barcklay/Cube_SAT/portfolio/sky/index.html

HAB-1 · GPS u-blox MAX-M10S · запись 29.09.2026, 21:44 · Бангкок, у окна

# Небо, которое видит GPS

Три минуты настоящих данных с модуля GPS моего зонда. Каждая точка — спутник: где он на небе, какой системы и насколько сильный сигнал до него доходит. Координаты не публикуются.

## Где эти спутники на самом деле

Земля, орбиты и расстояния в одном масштабе. Каждый спутник стоит там, где его в тот момент видел модуль GPS в Бангкоке, а линия — путь его сигнала до зонда. Все линии уходят на юг и запад: туда смотрит окно, остальное небо закрывает дом. Ещё 21 спутник BeiDou слышен, но где он, приёмник пока не знает, поэтому на глобусе его нет. Солнце стоит там, где было в момент записи: Бангкок уже на ночной стороне, а спутники высоко и ещё освещены. Высота и наклон каждой орбиты настоящие, поворот орбиты нарисован условно (по одному наблюдению не видно, куда летит спутник), а сами спутники увеличены в сотни тысяч раз — иначе их не разглядеть. Нажми на спутник, чтобы подлететь к нему.

тянуть — вращать · колесо / щипок — масштаб · нажми на спутник, чтобы подлететь

ВосходВсе спутники← Назад

## Что делают эти спутники

Навигационный спутник — это летающие часы. На каждом стоят атомные часы, и он без остановки передаёт: «сейчас ровно такое-то время, я нахожусь вот здесь». Приёмник на зонде замечает, насколько опоздал сигнал от каждого спутника, переводит опоздания в расстояния и по четырём и больше спутникам вычисляет, где он и который час.

Спутники SBAS (здесь — индийская система GAGAN) висят над одной точкой экватора и рассылают поправки к часам, орбитам и задержке сигнала в атмосфере. С ними ошибка координат падает до метра. Основная работа этих двух спутников — связь и телевидение, навигационная аппаратура на них — попутный груз.

Спецификации: NAVCEN (статус GPS), GSC Europa (Galileo), список кодов PRN gps.gov (январь 2026), AAI (GAGAN), Wikipedia и eoPortal. Внешний вид моделей — по фото и рендерам производителей, упрощённо.

## То же небо глазами приёмника

Как читать карту: центр — зенит, прямо над головой; край — горизонт. Север сверху, восток справа. Чем крупнее и ярче точка, тем сильнее сигнал.

## Почему пока нет координат

Все хорошо слышные спутники стоят в южной и западной половине неба, от 110° до 270°. Это и есть окно: северную половину закрывает дом, а спутник прямо над головой (GPS 30) почти не слышно из-за потолка. Приёмник слышит 32 спутника, но положение знает только у 11, и все они с одной стороны. По спутникам с одной стороны точку не вычислить.

Отсюда первое правило запуска: антенне GPS нужно всё небо. В полёте над зондом ничего нет, а вот на земле перед стартом его надо включать на открытом месте и ждать фикса, а не в машине или под навесом. Именно так карта неба помогает проверить аппарат до полёта.

## Сила сигнала каждого спутника

Среднее отношение сигнал/шум (C/N0) за три минуты, в дБ·Гц; штрих — лучшее значение. Ниже ~25 сигнал слабый, от 35 — сильный.

## Режим Airborne <4g: без него GPS слепнет на высоте

По умолчанию модуль считает, что его носят в руке или везут в машине, и выше 12 км перестаёт выдавать координаты. Зонд летит на 30 км. Поэтому прошивка при каждом включении переводит модуль в режим «летательный аппарат» (Airborne <4g, потолок 80 км), ждёт подтверждения и сохраняет режим в память модуля с батарейкой. Так выглядит это в настоящем логе при старте платы:

GPS: NMEA OK at 38400 baud
GPS dynModel at boot: RAM=8 (AIRBORNE<4g), BBR=8 (AIRBORNE<4g)
GPS set Airborne<4g: ACK
GPS dynModel now: RAM=8 (AIRBORNE<4g)

Закрыть Все типы рядом

↓ Земля · модель упрощена, по фото и спецификациям

HAB-1 · данные: сырые NMEA-строки GSV модуля MAX-M10S, 185 секунд · проект: github.com/barcklay/Cube_SAT · полёт в 3D: HAB-1 Лаборатория (https://claude.ai/artifact/VP8YPhxGNXckYP5Keu93rK)
