barcklay/Cube_SAT/portfolio/lab/index.html

# HAB-1

Самодельный зонд, который поднимется на метеошаре на 30 км в стратосферу, соберёт данные и вернётся на парашюте

надуваем шар…

# HAB-1

Зонд поднимется на метеошаре на 30 км, соберёт данные и вернётся на парашюте. Бортовой компьютер, плату и корпус делаю сама.

Зонд Весь подвес Сверху Заглянуть внутрь О модели

Датчики ▴

Датчики на борту

Среда и шар

Место

ПОДЪЁМ

0км

▶ Полёт

## HAB-1: полёт в стратосферу

Что это

Самодельный бортовой компьютер для метеошара: плату, прошивку и корпус делаю сама.

Зачем

Подняться на 30 км, измерить холод, давление и ветер на высоте и вернуть данные и снимки. Первый запуск — в Таиланде, 2027.

Что здесь

Симуляция полёта. Время двигается внизу, датчики справа. Нажми на коробку — она откроется, внутри настоящая плата из проекта; нажми ещё раз — закроется.

Заглянуть внутрь ▶ Запустить полёт Просто смотреть

Внутри — бортовой компьютер · нажми Закрыть

## Что здесь настоящее, а что модель

### Настоящее

- Плата внутри зонда выгружена из KiCad-проекта полётной платы (kicad-cli pcb export glb). Детали расставлены, дорожки ещё не разведены.
- Высота по давлению считается формулой из прошивки: 44330·(1 − (p/p₀)^(1/5,255)). Она верна только до 11 км, и страница показывает, насколько она ошибается выше.
- Строка внизу экрана в формате FramePrint: те же поля, флаги valid и код режима GPS, что в прошивке hab_bringup.
- Паспортные пределы: BMP390 работает от 300 до 1250 гПа, DS18B20 от −55 до +125 °C.
- GPS переведён в режим Airborne <4g: в режиме по умолчанию приёмник перестаёт выдавать координаты выше 12 км, и зонд было бы не найти. Прошивка ставит режим при каждом включении и проверяет подтверждение модуля.
- Корпус по концепции HW-34: пенопласт XPS 30 мм, 250 × 175 × 140 мм, салазки с платой 1U, батареи 4× L91, отсек камеры.

### Модель

- Атмосфера — упрощённый тропический профиль: +27 °C у земли, около −83 °C на 17 км. Он холоднее стандартной ISA, потому что запуск будет в Таиланде.
- Подъём 5 м/с. Шар 1,9 м у земли и лопается при 7,9 м, газ считается при температуре воздуха. Высота разрыва получается из этого расчёта.
- Спуск на парашюте: 5 м/с у земли, на высоте быстрее пропорционально √(ρ₀/ρ).
- Температура внутри бокса — грубая оценка. Её заменят данные теста с сухим льдом (HW-34).
- Сцена показана на рассвете: с высоты 30 км Солнце уже встало, а на земле ещё ночь. Огни городов — снимок NASA Black Marble, дневная земля — Blue Marble. Облака и показания IMU в момент разрыва условные. Размеры шара, строп и корпуса в масштабе.

### Точка старта

- Кандидаты считались по сетке 0,1° по всему Таиланду (около 11 км между точками). Условия: от аэропортов с кодом IATA/ICAO не ближе 50 км, от других аэродромов 20 км, от военных объектов 25 км, до сухопутной границы и моря не меньше 150 км. Перепад высот по SRTM в квадрате 8×8 км не больше 25 м.
- Выбрана точка 15,800° N 102,500° E (район Вэнг Ной, провинция Кхонкэн, плато Корат). До границы и моря 178 км, до аэропорта 80 км, до военного объекта в OSM 52 км, перепад высот 16 м, высота 186 м.
- Траектория на сцене — пример прогноза SondeHub/Tawhiri по погоде GFS на один день (дата в панели «Место»). В феврале–марте ветры другие. Настоящий прогноз нужно считать за несколько дней до пуска.
- Военные объекты в OSM отмечены не полностью. Перед пуском точку надо согласовать с авиавластями Таиланда (CAAT) и подать NOTAM.
- Снимок поверхности: NASA Blue Marble Next Generation (общественное достояние), через NASA GIBS.

### Дальше

- Карта неба GPS, повтор настоящего лога со стенда, радиолиния LoRa, питание на морозе.
- После запуска модель заменится настоящим полётом из лога.
