barcklay/Cube_SAT/hardware/flight_pcb/render_bottom_routed.png

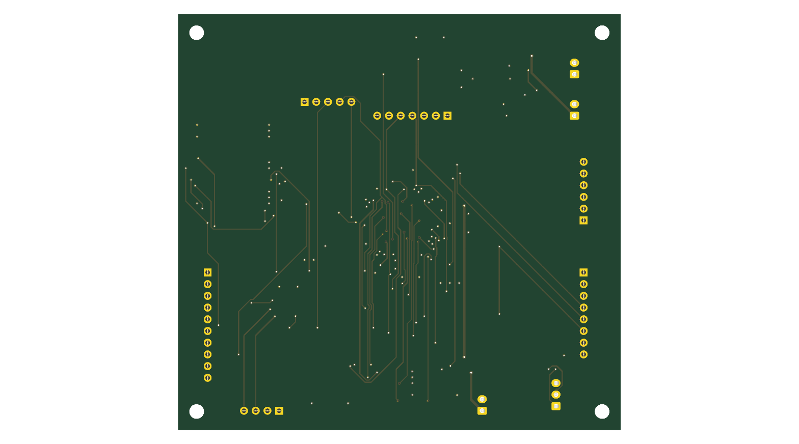
hardware/flight_pcb/render_bottom_routed.png
