barcklay/Cube_SAT/hardware/flight_pcb/render_top_unrouted.png

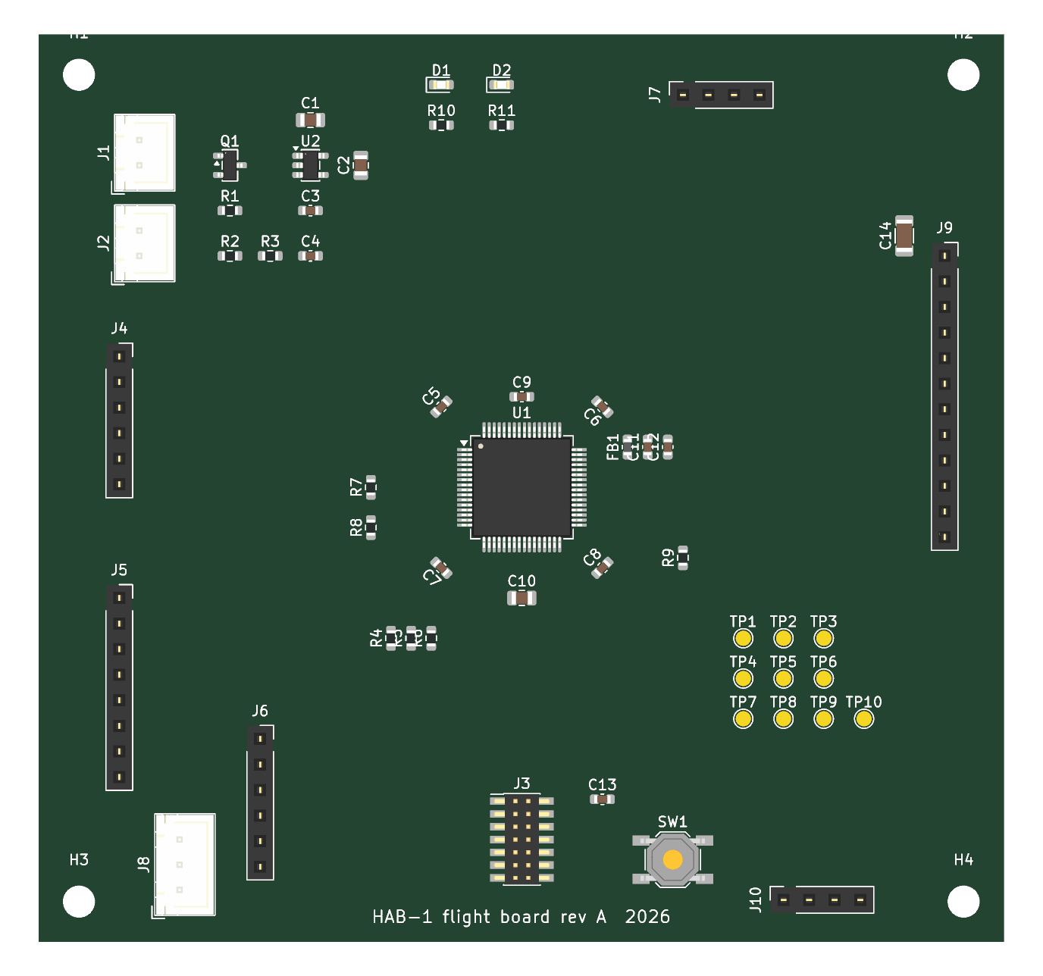
hardware/flight_pcb/render_top_unrouted.png
