barcklay/Cube_SAT/portfolio/lab/near.jpg

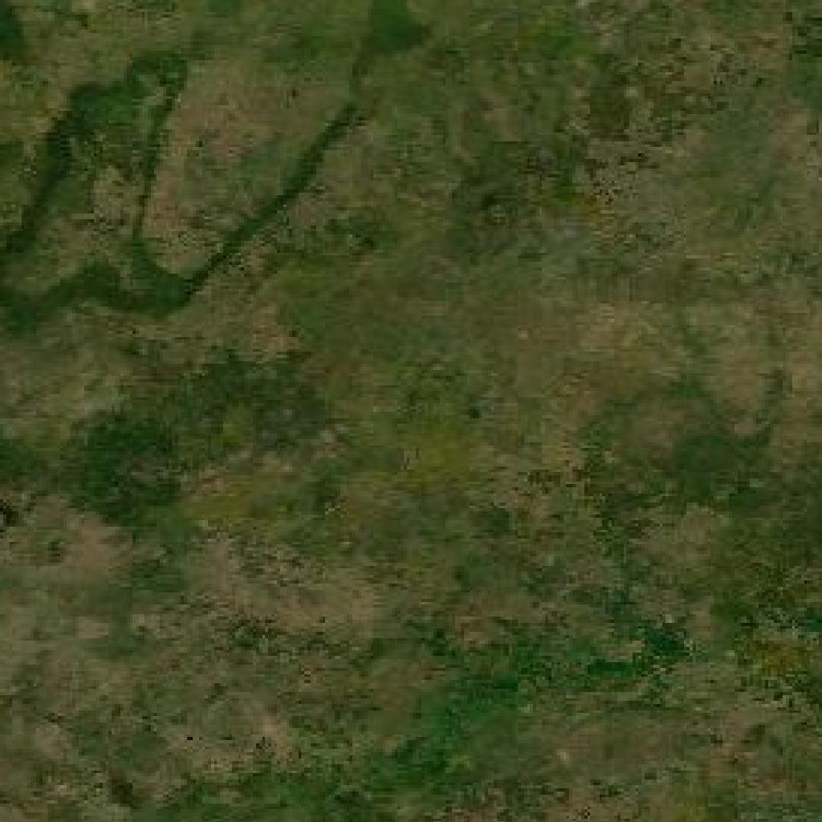
portfolio/lab/near.jpg
