barcklay/Cube_SAT/portfolio/lab/wide.jpg

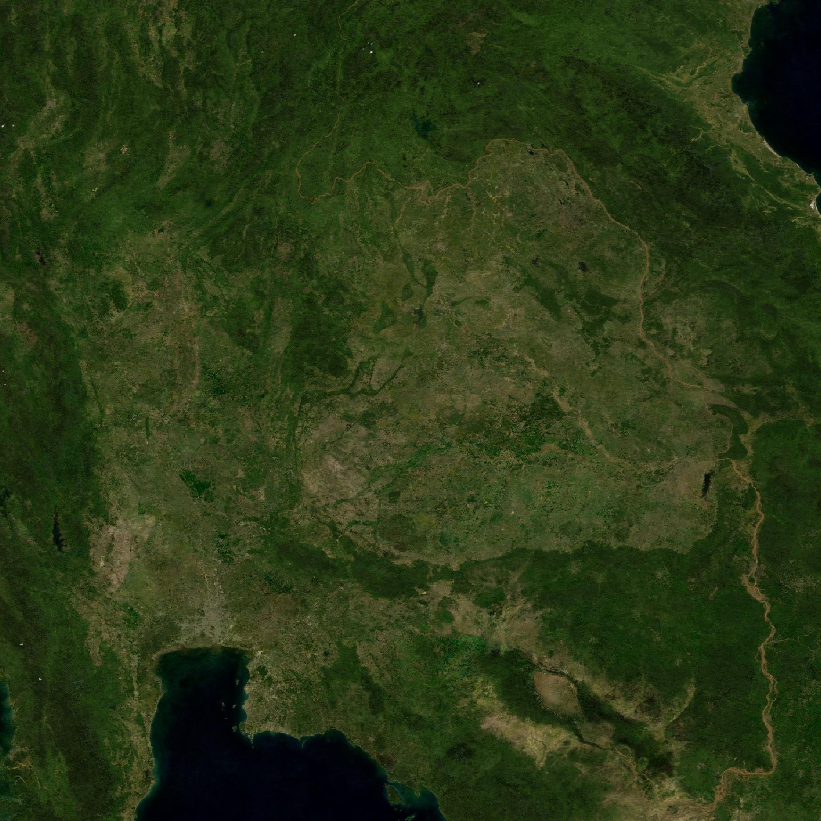
portfolio/lab/wide.jpg
