barcklay/Cube_SAT/portfolio/lab/wide_night.jpg

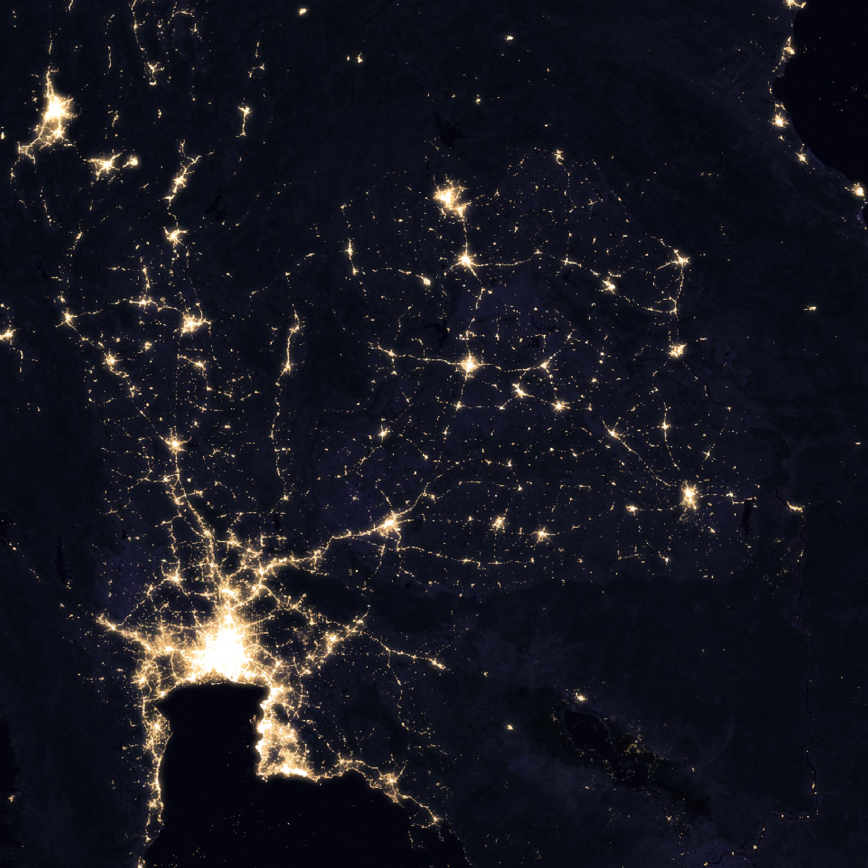
portfolio/lab/wide_night.jpg
