barcklay/Cube_SAT/portfolio/sky/world.jpg

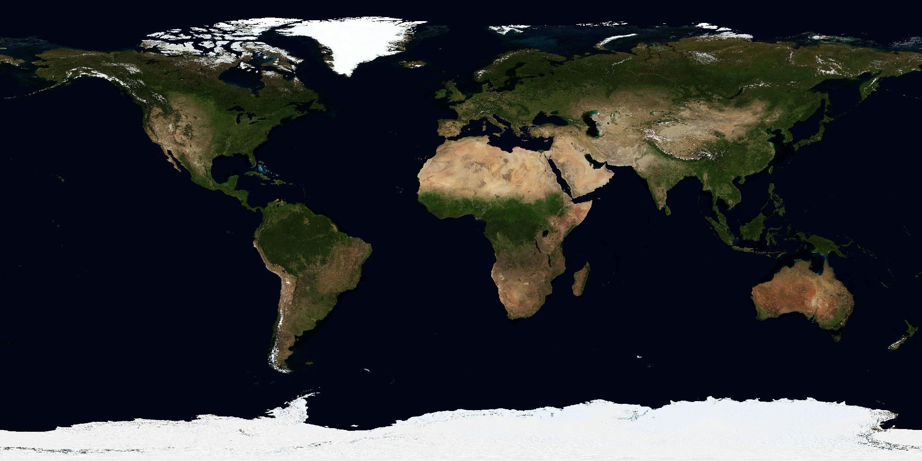
portfolio/sky/world.jpg
