barcklay/Cube_SAT/hardware/lora_adapter/fab/bom_jlcpcb.csv

Comment | Designator | Footprint | LCSC Part #
0805 4.7uF 25V X5R | C1 | C_0805_2012Metric | C1779
0603 100nF 50V X7R | C2 | C_0603_1608Metric | C14663
E22-400M22S LoRa module (Ebyte, SX1268) | U1 | E22-400M22S | C411291
