barcklay/Cube_SAT/hardware/flight_pcb/fab/hand_soldered.txt

Through-hole parts, soldered by hand, not in the JLCPCB order:
J1  BATTERY 4xL91  JST_XH_B2B-XH-A_1x02_P2.50mm_Vertical
J2  POWER SWITCH (on the box)  JST_XH_B2B-XH-A_1x02_P2.50mm_Vertical
J4  SPI FLASH module  PinSocket_1x06_P2.54mm_Vertical
J5  IMU GY-601N1  PinSocket_1x08_P2.54mm_Vertical
J6  BAROMETER BMP390  PinSocket_1x07_P2.54mm_Vertical
J7  GPS MAX-M10S  PinSocket_1x05_P2.54mm_Vertical
J8  DS18B20 probe  JST_XH_B3B-XH-A_1x03_P2.50mm_Vertical
J10  OLED SSD1306 (bench)  PinSocket_1x04_P2.54mm_Vertical
J11  BUZZER (+ / -)  JST_XH_B2B-XH-A_1x02_P2.50mm_Vertical
J12  EXPANSION  PinSocket_1x10_P2.54mm_Vertical
