barcklay/Cube_SAT/hardware/flight_pcb/fit_check_1to1.pdf

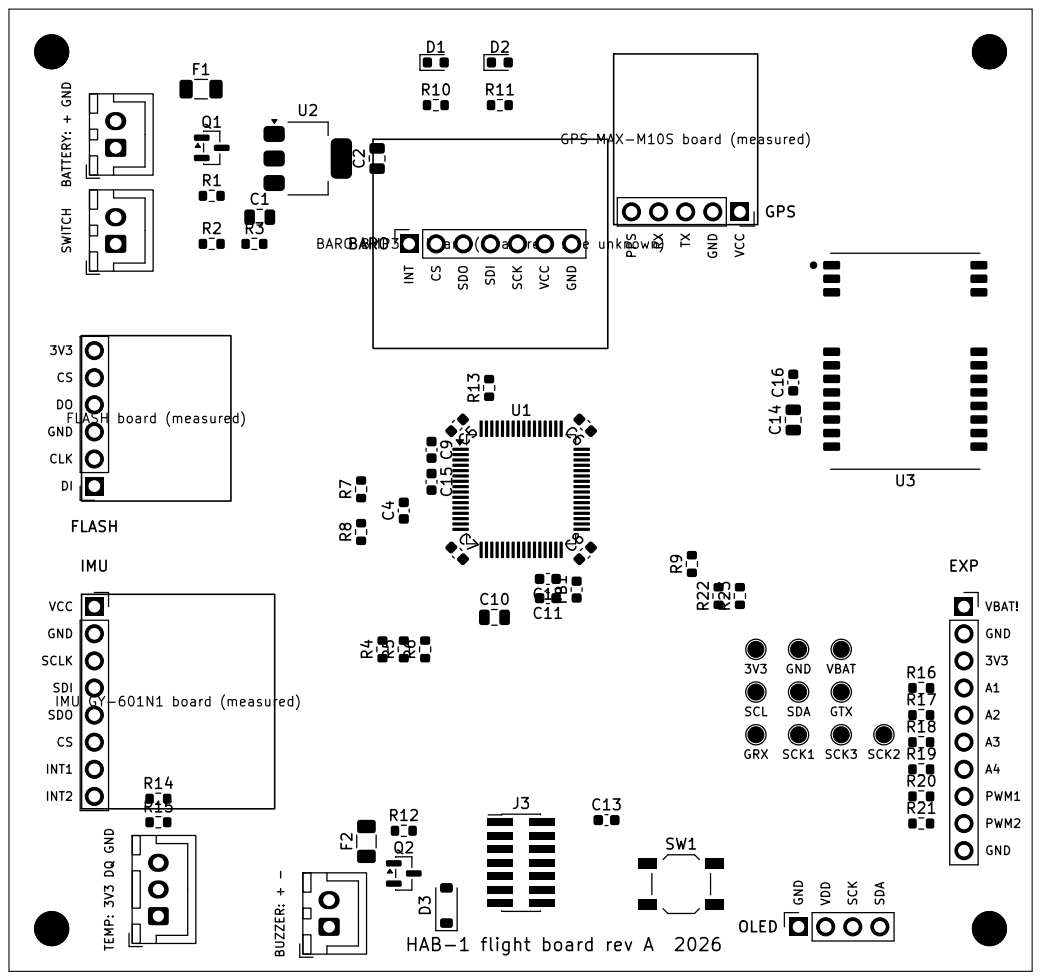
[picture p9: page 1]

EXP HAB-1 flight board rev A 2026
