barcklay/Cube_SAT/hardware/flight_pcb/hab1_flight.pdf

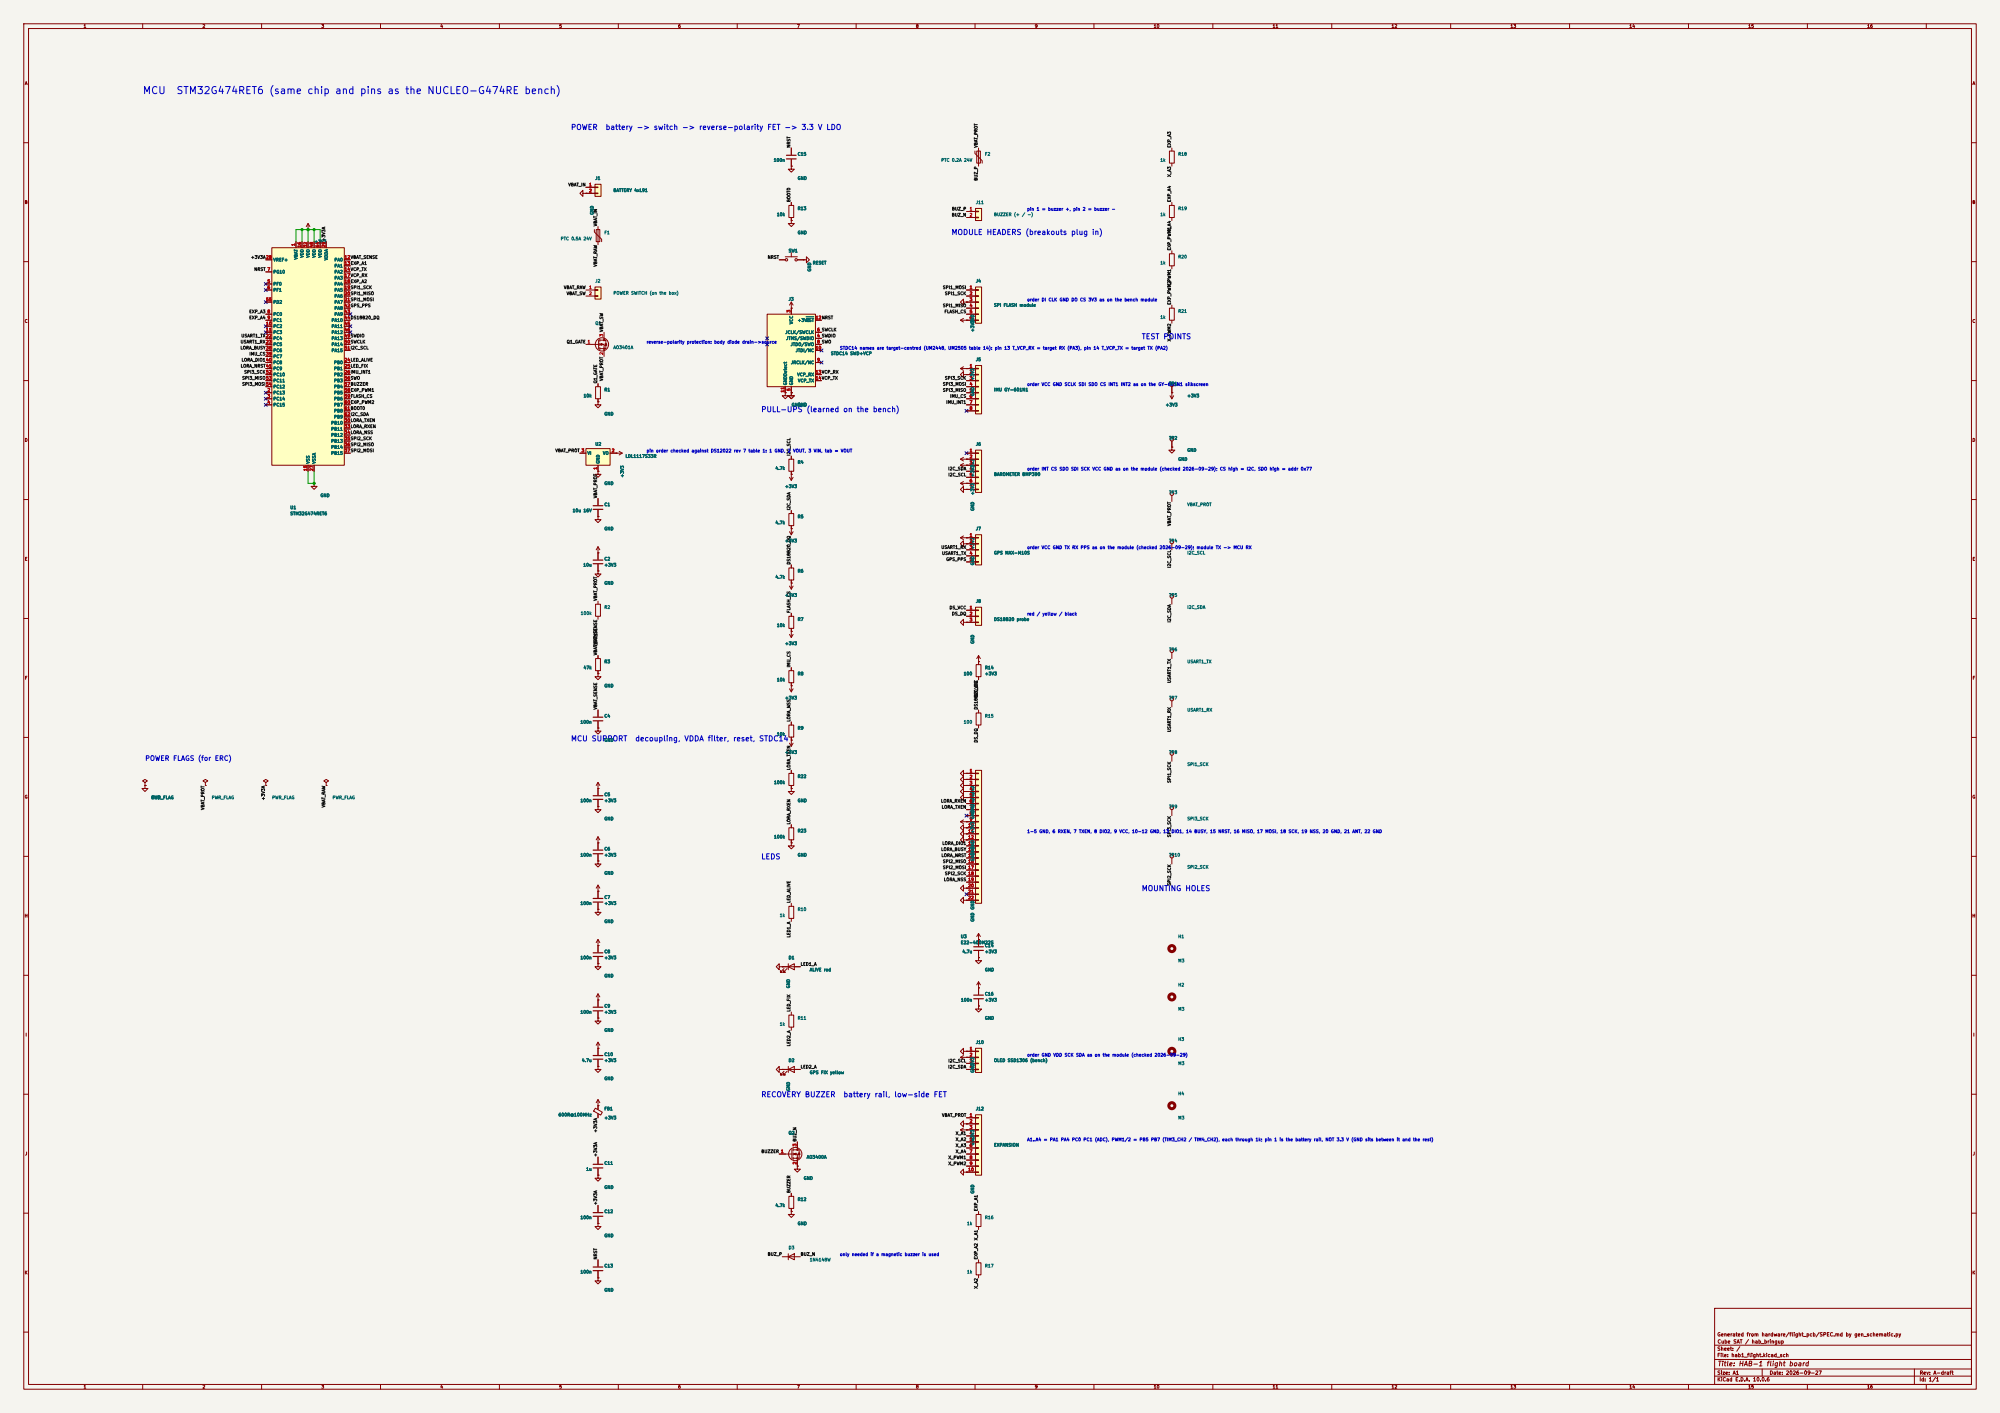
[picture p10: page 1]

MCU STM32G474RET6 (same chip and pins as the NUCLEO-G474RE bench)

POWER battery -> switch -> reverse-polarity FET -> 3.3 V LDO

SPI FLASH module 123456 GND +3V3 +3V3 R13

pin 1 = buzzer +, pin 2 = buzzer -

MODULE HEADERS (breakouts plug in)

STDC14 names are target-centred (UM2448, UM2505 table 14): pin 13 T_VCP_RX = target RX (PA3), pin 14 T_VCP_TX = target TX (PA2) order DI CLK GND DO CS 3V3 as on the bench module order VCC GND TX RX PPS as on the module (checked 2026-09-29); module TX -> MCU RX

order VCC GND SCLK SDI SDO CS INT1 INT2 as on the GY-601N1 silkscreen TEST POINTS

Q1_GATE
reverse-polarity protection: body diode drain->source pin order checked against DS12022 rev 7 table 1: 1 GND, 2 VOUT, 3 VIN, tab = VOUT MCU SUPPORT decoupling, VDDA filter, reset, STDC14

PULL-UPS (learned on the bench)

order INT CS SDO SDI SCK VCC GND as on the module (checked 2026-09-29); CS high = I2C, SDO high = addr 0x77

POWER FLAGS (for ERC)

1-5 GND, 6 RXEN, 7 TXEN, 8 DIO2, 9 VCC, 10-12 GND, 13 DIO1, 14 BUSY, 15 NRST, 16 MISO, 17 MOSI, 18 SCK, 19 NSS, 20 GND, 21 ANT, 22 GND

A1..A4 = PA1 PA4 PC0 PC1 (ADC), PWM1/2 = PB5 PB7 (TIM3_CH2 / TIM4_CH2), each through 1k; pin 1 is the battery rail, NOT 3.3 V (GND sits between it and the rest) order GND VDD SCK SDA as on the module (checked 2026-09-29)

RECOVERY BUZZER battery rail, low-side FET

Generated from hardware/flight_pcb/SPEC.md by gen_schematic.py
Cube SAT / hab_bringup
Sheet: /
File: hab1_flight.kicad_sch
Title: HAB-1 flight board

Size: A1 | Rev: A-draft
KiCad E.D.A. 10.0.6 | Id: 1/1
