barcklay/Cube_SAT/hardware/flight_pcb/hab1_flight.kicad_pcb

## KiCad design hardware/flight_pcb/hab1_flight.kicad_pcb (2026-10-08)

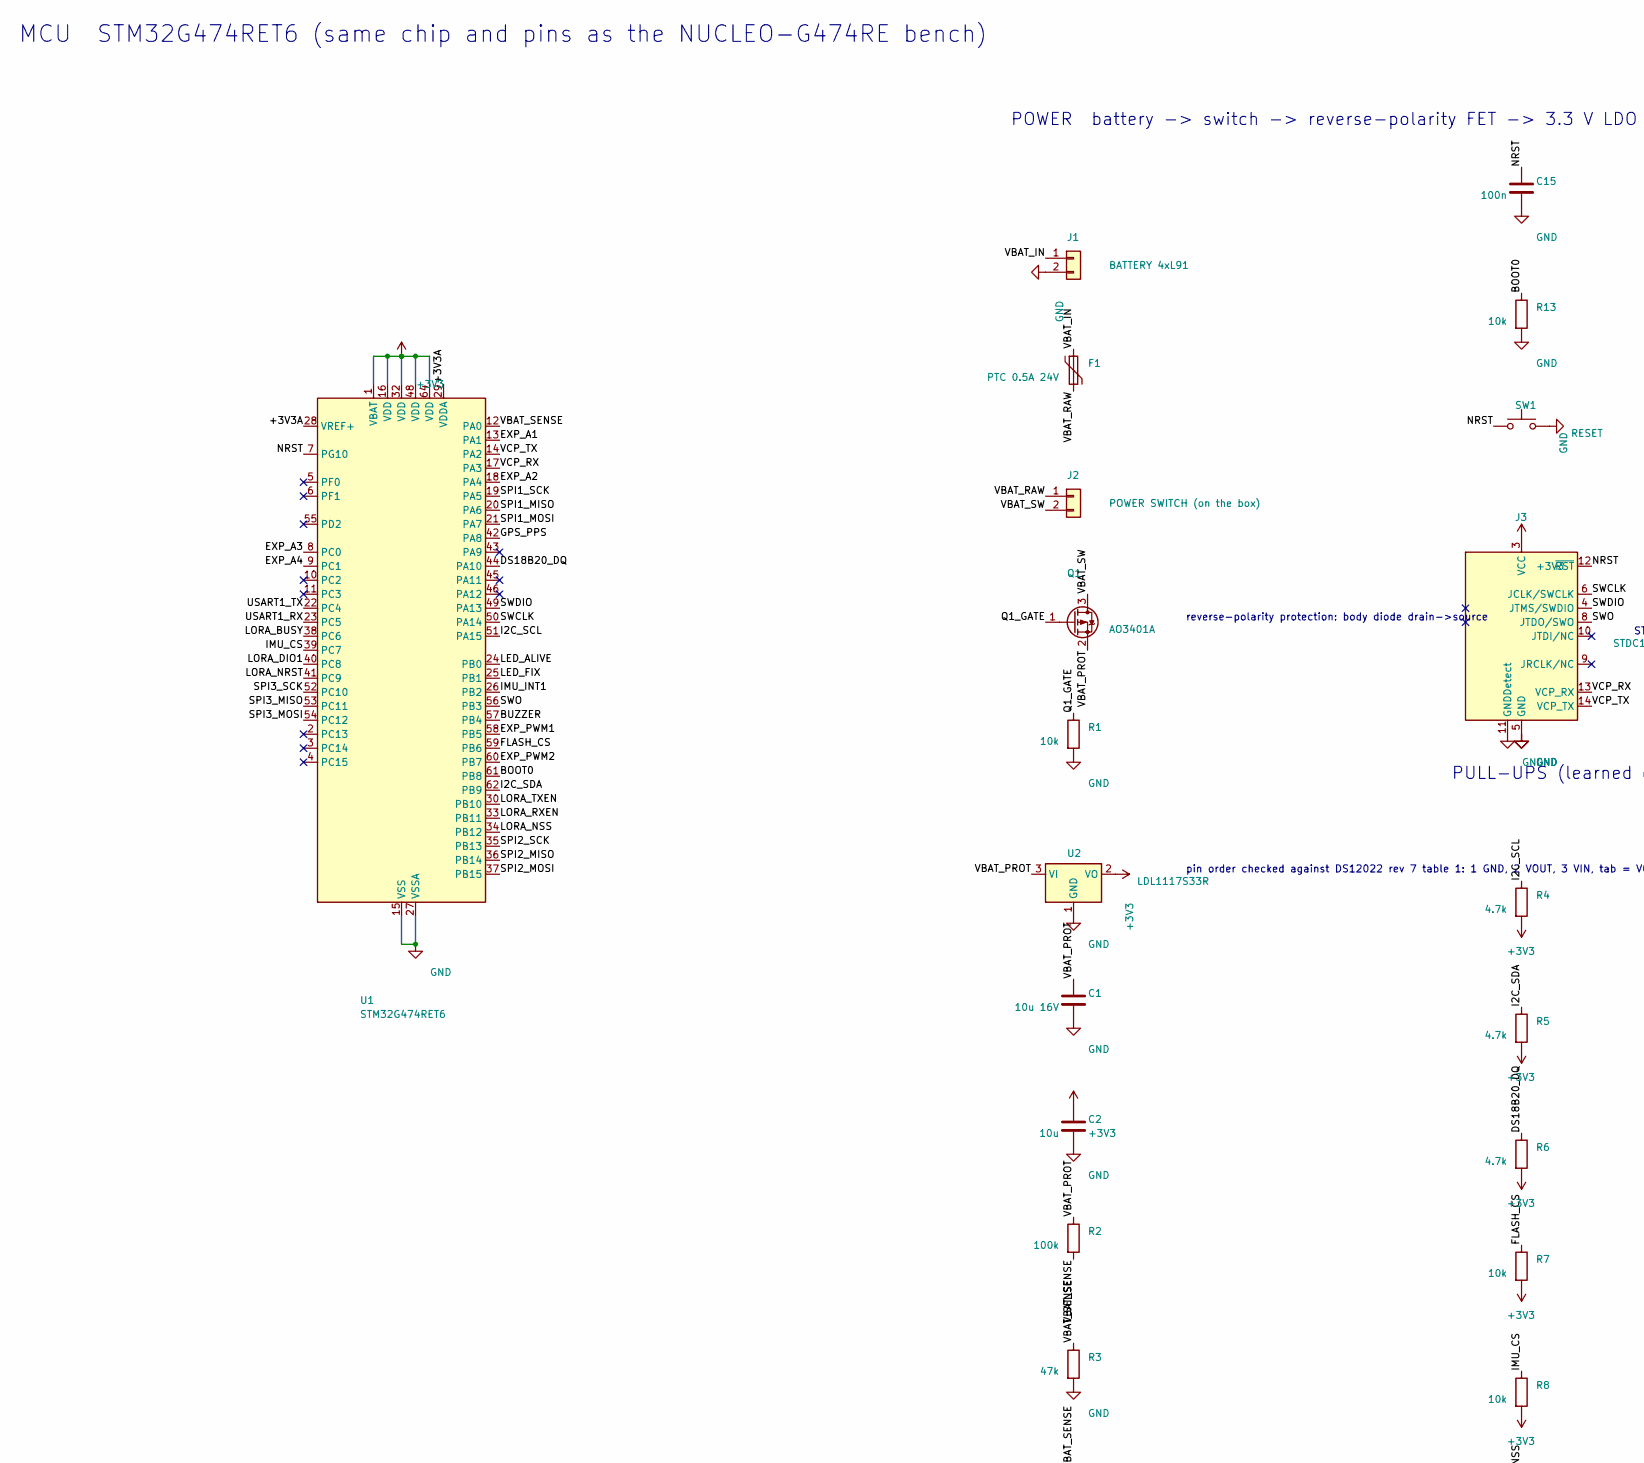
[picture p11: schematic hab1_flight.kicad_sch, HAB-1 flight board, part in row 1, column 1]

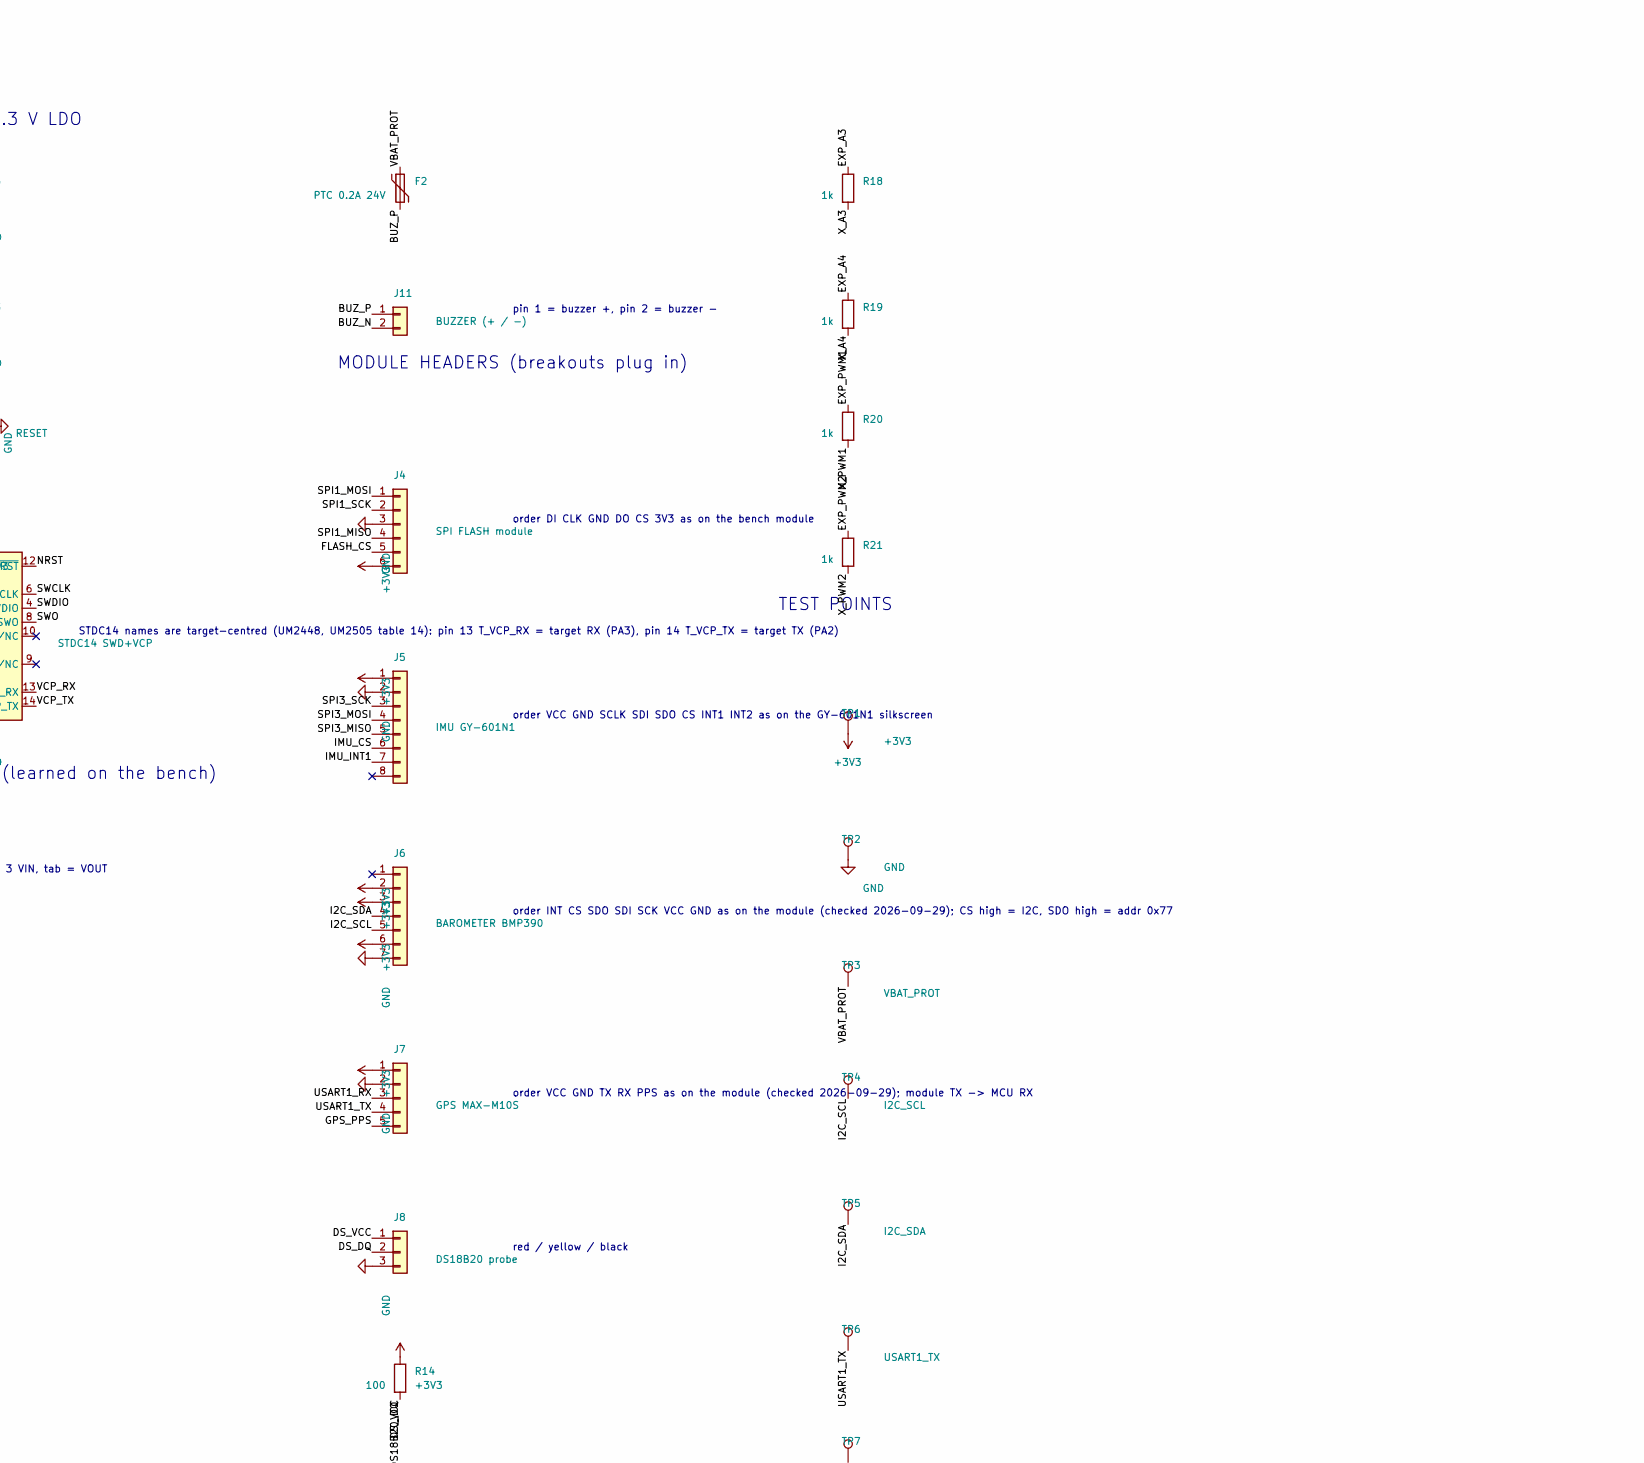
[picture p12: schematic hab1_flight.kicad_sch, HAB-1 flight board, part in row 1, column 2]

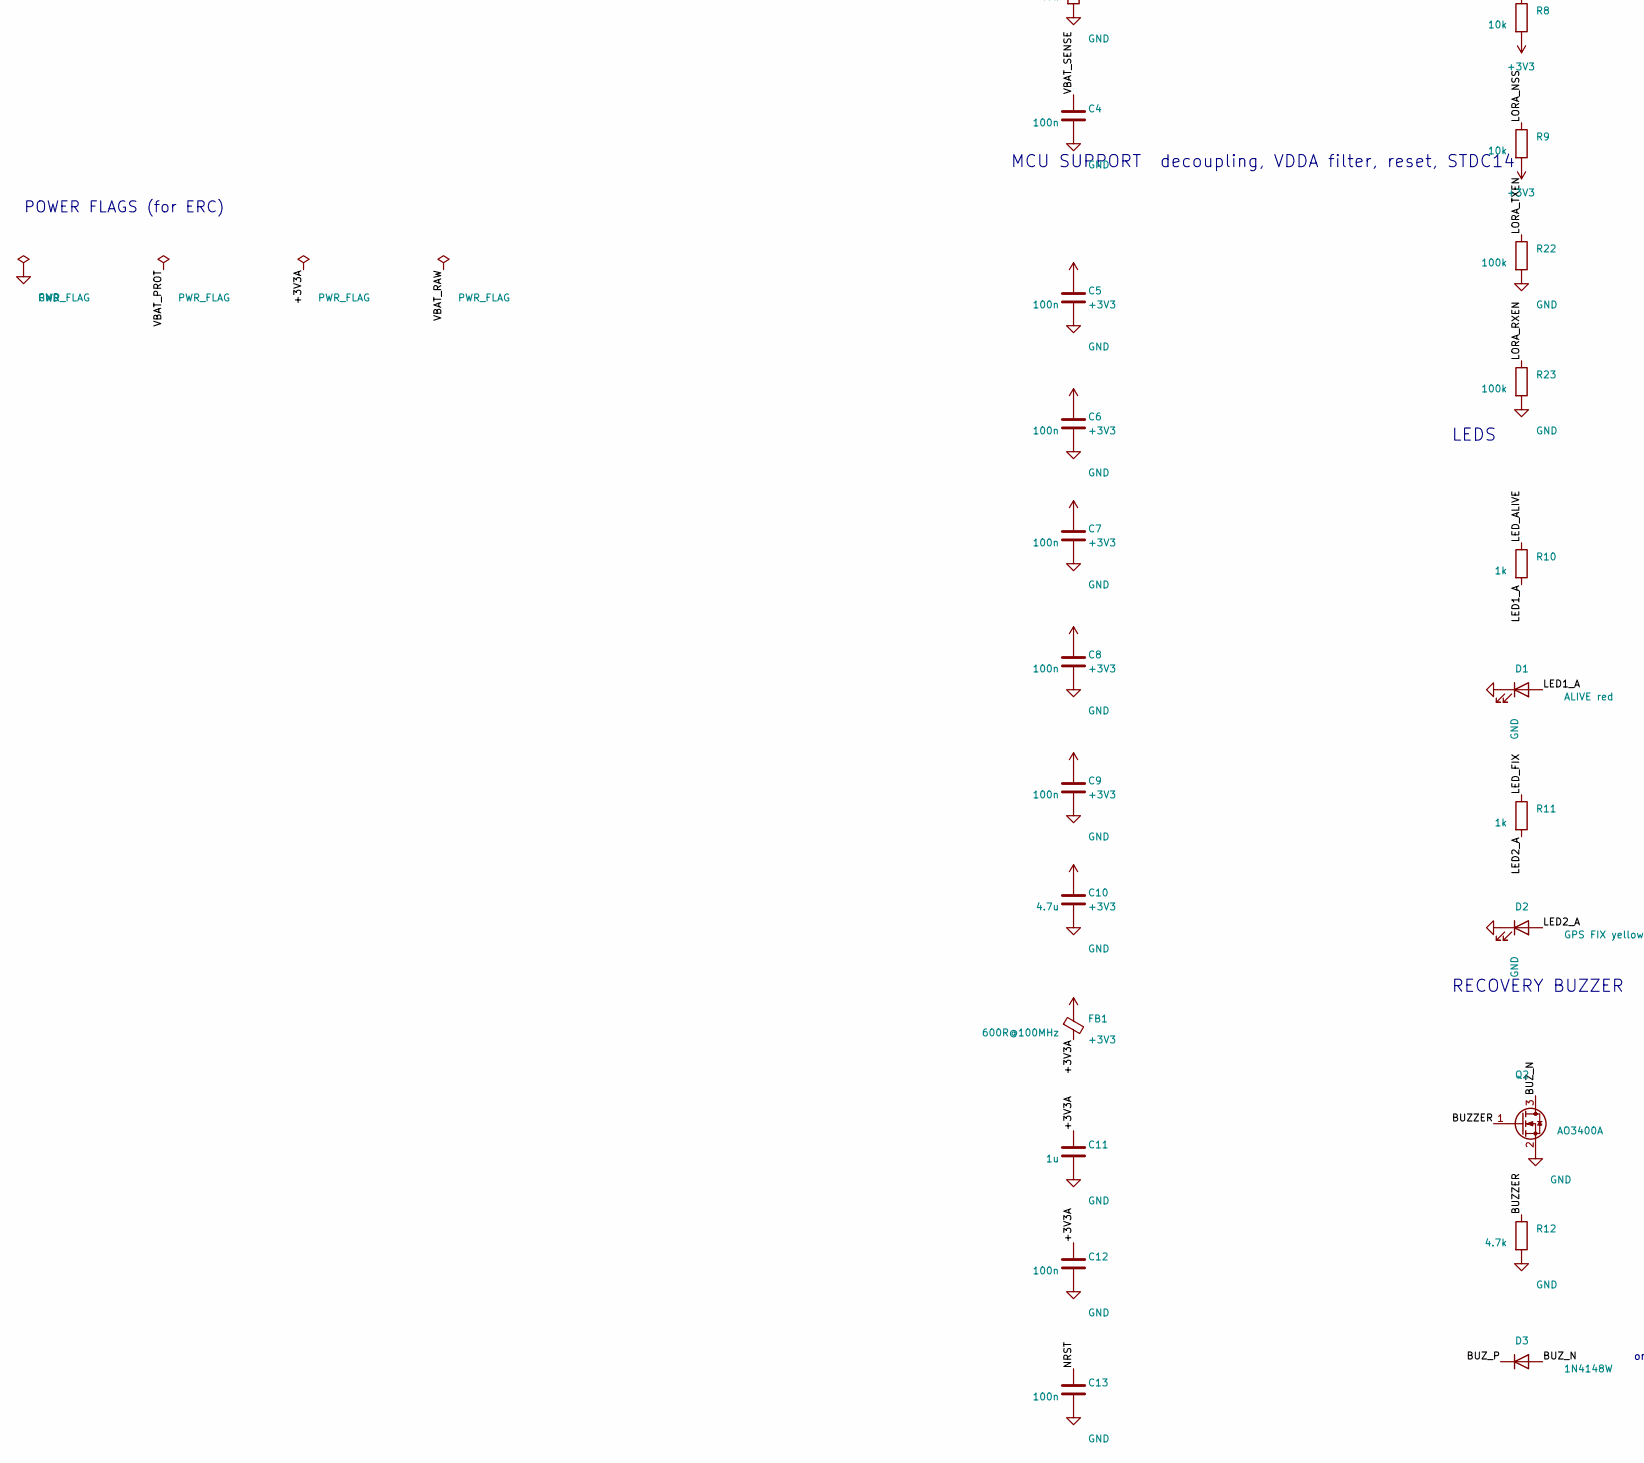
[picture p13: schematic hab1_flight.kicad_sch, HAB-1 flight board, part in row 2, column 1]

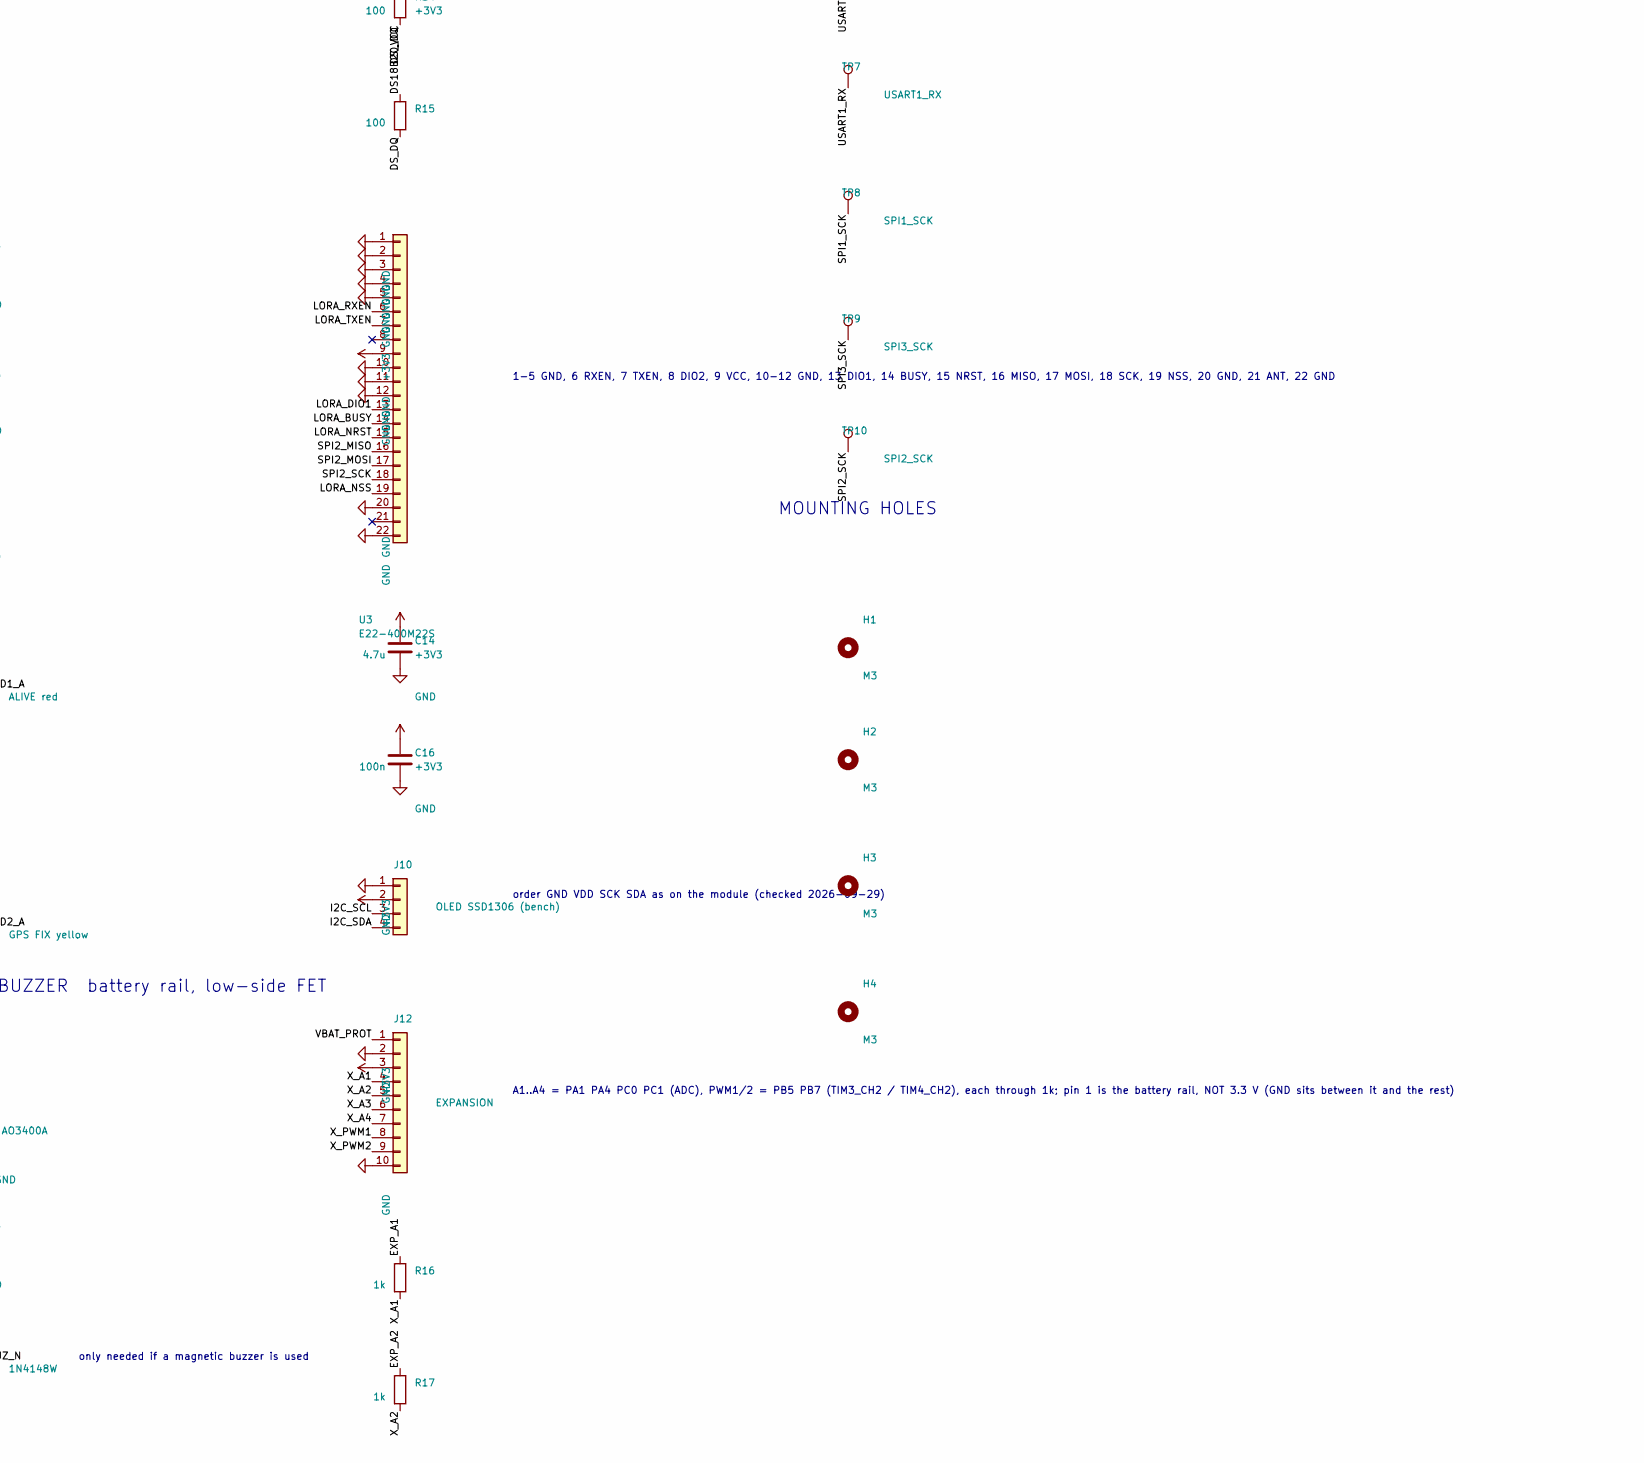
[picture p14: schematic hab1_flight.kicad_sch, HAB-1 flight board, part in row 2, column 2]

Parts:
C1: 10u 16V; C_0805_2012Metric
C2: 10u; C_0805_2012Metric
C4, C5, C6, C7, C8, C9, C12, C13, C15, C16: 100n; C_0603_1608Metric
C10, C14: 4.7u; C_0805_2012Metric
C11: 1u; C_0603_1608Metric
D1: ALIVE red; LED_0603_1608Metric
D2: GPS FIX yellow; LED_0603_1608Metric
D3: 1N4148W; D_SOD-123
F1: PTC 0.5A 24V; Fuse_1206_3216Metric
F2: PTC 0.2A 24V; Fuse_1206_3216Metric
FB1: 600R@100MHz; L_0603_1608Metric
H1, H2, H3, H4: M3; MountingHole_3.2mm_M3
J1: BATTERY 4xL91; JST_XH_B2B-XH-A_1x02_P2.50mm_Vertical
J2: POWER SWITCH (on the box); JST_XH_B2B-XH-A_1x02_P2.50mm_Vertical
J3: STDC14 SWD+VCP; PinHeader_2x07_P1.27mm_Vertical_SMD
J4: SPI FLASH module; PinSocket_1x06_P2.54mm_Vertical
J5: IMU GY-601N1; PinSocket_1x08_P2.54mm_Vertical
J6: BAROMETER BMP390; PinSocket_1x07_P2.54mm_Vertical
J7: GPS MAX-M10S; PinSocket_1x05_P2.54mm_Vertical
J8: DS18B20 probe; JST_XH_B3B-XH-A_1x03_P2.50mm_Vertical
J10: OLED SSD1306 (bench); PinSocket_1x04_P2.54mm_Vertical
J11: BUZZER (+ / -); JST_XH_B2B-XH-A_1x02_P2.50mm_Vertical
J12: EXPANSION; PinSocket_1x10_P2.54mm_Vertical
Q1: AO3401A; SOT-23
Q2: AO3400A; SOT-23
R1, R7, R8, R9, R13: 10k; R_0603_1608Metric
R2, R22, R23: 100k; R_0603_1608Metric
R3: 47k; R_0603_1608Metric
R4, R5, R6, R12: 4.7k; R_0603_1608Metric
R10, R11, R16, R17, R18, R19, R20, R21: 1k; R_0603_1608Metric
R14, R15: 100; R_0603_1608Metric
SW1: RESET; SW_SPST_TL3342
TP1: +3V3; TestPoint_Pad_D1.5mm
TP2: GND; TestPoint_Pad_D1.5mm
TP3: VBAT_PROT; TestPoint_Pad_D1.5mm
TP4: I2C_SCL; TestPoint_Pad_D1.5mm
TP5: I2C_SDA; TestPoint_Pad_D1.5mm
TP6: USART1_TX; TestPoint_Pad_D1.5mm
TP7: USART1_RX; TestPoint_Pad_D1.5mm
TP8: SPI1_SCK; TestPoint_Pad_D1.5mm
TP9: SPI3_SCK; TestPoint_Pad_D1.5mm
TP10: SPI2_SCK; TestPoint_Pad_D1.5mm
U1: STM32G474RET6; LQFP-64_10x10mm_P0.5mm
U2: LDL1117S33R; SOT-223-3_TabPin2
U3: E22-400M22S

Connections:
+3V3: C2.1, C5.1, C6.1, C7.1, C8.1, C9.1, C10.1, C14.1, C16.1, FB1.1, J3.3 (VCC), J4.6, J5.1, J6.2, J6.3, J6.6, J7.1, J10.2, J12.3, R4.2, R5.2, R6.2, R7.2, R8.2, R9.2, R14.1, TP1.1, U1.1 (VBAT), U1.16 (VDD), U1.32 (VDD), U1.48 (VDD), U1.64 (VDD), U2.2 (VO), U3.9
/+3V3A: C11.1, C12.1, FB1.2, U1.28 (VREF+), U1.29 (VDDA)
/BOOT0: R13.1, U1.61 (PB8)
/BUZZER: Q2.1 (G), R12.1, U1.57 (PB4)
/BUZ_N: D3.2 (A), J11.2, Q2.3 (D)
/BUZ_P: D3.1 (K), F2.2, J11.1
/DS18B20_DQ: R6.1, R15.1, U1.44 (PA10)
/DS_DQ: J8.2, R15.2
/DS_VCC: J8.1, R14.2
/EXP_A1: R16.1, U1.13 (PA1)
/EXP_A2: R17.1, U1.18 (PA4)
/EXP_A3: R18.1, U1.8 (PC0)
/EXP_A4: R19.1, U1.9 (PC1)
/EXP_PWM1: R20.1, U1.58 (PB5)
/EXP_PWM2: R21.1, U1.60 (PB7)
/FLASH_CS: J4.5, R7.1, U1.59 (PB6)
/GPS_PPS: J7.5, U1.42 (PA8)
/I2C_SCL: J6.5, J10.3, R4.1, TP4.1, U1.51 (PA15)
/I2C_SDA: J6.4, J10.4, R5.1, TP5.1, U1.62 (PB9)
/IMU_CS: J5.6, R8.1, U1.39 (PC7)
/IMU_INT1: J5.7, U1.26 (PB2)
/LED1_A: D1.2 (A), R10.2
/LED2_A: D2.2 (A), R11.2
/LED_ALIVE: R10.1, U1.24 (PB0)
/LED_FIX: R11.1, U1.25 (PB1)
/LORA_BUSY: U1.38 (PC6), U3.14
/LORA_DIO1: U1.40 (PC8), U3.13
/LORA_NRST: U1.41 (PC9), U3.15
/LORA_NSS: R9.1, U1.34 (PB12), U3.19
/LORA_RXEN: R23.1, U1.33 (PB11), U3.6
/LORA_TXEN: R22.1, U1.30 (PB10), U3.7
/NRST: C13.1, C15.1, J3.12 (~RST), SW1.1, U1.7 (PG10)
/Q1_GATE: Q1.1 (G), R1.1
/SPI1_MISO: J4.4, U1.20 (PA6)
/SPI1_MOSI: J4.1, U1.21 (PA7)
/SPI1_SCK: J4.2, TP8.1, U1.19 (PA5)
/SPI2_MISO: U1.36 (PB14), U3.16
/SPI2_MOSI: U1.37 (PB15), U3.17
/SPI2_SCK: TP10.1, U1.35 (PB13), U3.18
/SPI3_MISO: J5.5, U1.53 (PC11)
/SPI3_MOSI: J5.4, U1.54 (PC12)
/SPI3_SCK: J5.3, TP9.1, U1.52 (PC10)
/SWCLK: J3.6 (JCLK/SWCLK), U1.50 (PA14)
/SWDIO: J3.4 (JTMS/SWDIO), U1.49 (PA13)
/SWO: J3.8 (JTDO/SWO), U1.56 (PB3)
/USART1_RX: J7.3, TP7.1, U1.23 (PC5)
/USART1_TX: J7.4, TP6.1, U1.22 (PC4)
/VBAT_IN: F1.1, J1.1
/VBAT_PROT: C1.1, F2.1, J12.1, Q1.2 (S), R2.1, TP3.1, U2.3 (VI)
/VBAT_RAW: F1.2, J2.1
/VBAT_SENSE: C4.1, R2.2, R3.1, U1.12 (PA0)
/VBAT_SW: J2.2, Q1.3 (D)
/VCP_RX: J3.13 (VCP_RX), U1.17 (PA3)
/VCP_TX: J3.14 (VCP_TX), U1.14 (PA2)
/X_A1: J12.4, R16.2
/X_A2: J12.5, R17.2
/X_A3: J12.6, R18.2
/X_A4: J12.7, R19.2
/X_PWM1: J12.8, R20.2
/X_PWM2: J12.9, R21.2
GND: C1.2, C2.2, C4.2, C5.2, C6.2, C7.2, C8.2, C9.2, C10.2, C11.2, C12.2, C13.2, C14.2, C15.2, C16.2, D1.1 (K), D2.1 (K), J1.2, J3.5 (GND), J3.7 (GND), J3.11 (GNDDetect), J4.3, J5.2, J6.7, J7.2, J8.3, J10.1, J12.2, J12.10, Q2.2 (S), R1.2, R3.2, R12.2, R13.2, R22.2, R23.2, SW1.2, TP2.1, U1.15 (VSS), U1.27 (VSSA), U1.31 (VSS), U1.47 (VSS), U1.63 (VSS), U2.1 (GND), U3.1, U3.2, U3.3, U3.4, U3.5, U3.10, U3.11, U3.12, U3.20, U3.22

Notes on the sheet:
MCU STM32G474RET6 (same chip and pins as the NUCLEO-G474RE bench)
POWER battery -> switch -> reverse-polarity FET -> 3.3 V LDO
reverse-polarity protection: body diode drain->source
pin order checked against DS12022 rev 7 table 1: 1 GND, 2 VOUT, 3 VIN, tab = VOUT
MCU SUPPORT decoupling, VDDA filter, reset, STDC14
STDC14 names are target-centred (UM2448, UM2505 table 14): pin 13 T_VCP_RX = target RX (PA3), pin 14 T_VCP_TX = target TX (PA2)
PULL-UPS (learned on the bench)
LEDS
RECOVERY BUZZER battery rail, low-side FET
only needed if a magnetic buzzer is used
pin 1 = buzzer +, pin 2 = buzzer -
MODULE HEADERS (breakouts plug in)
order DI CLK GND DO CS 3V3 as on the bench module
order VCC GND SCLK SDI SDO CS INT1 INT2 as on the GY-601N1 silkscreen
order INT CS SDO SDI SCK VCC GND as on the module (checked 2026-09-29); CS high = I2C, SDO high = addr 0x77
order VCC GND TX RX PPS as on the module (checked 2026-09-29); module TX -> MCU RX
red / yellow / black
1-5 GND, 6 RXEN, 7 TXEN, 8 DIO2, 9 VCC, 10-12 GND, 13 DIO1, 14 BUSY, 15 NRST, 16 MISO, 17 MOSI, 18 SCK, 19 NSS, 20 GND, 21 ANT, 22 GND
order GND VDD SCK SDA as on the module (checked 2026-09-29)
A1..A4 = PA1 PA4 PC0 PC1 (ADC), PWM1/2 = PB5 PB7 (TIM3_CH2 / TIM4_CH2), each through 1k; pin 1 is the battery rail, NOT 3.3 V (GND sits between it and the rest)
TEST POINTS
MOUNTING HOLES
POWER FLAGS (for ERC)

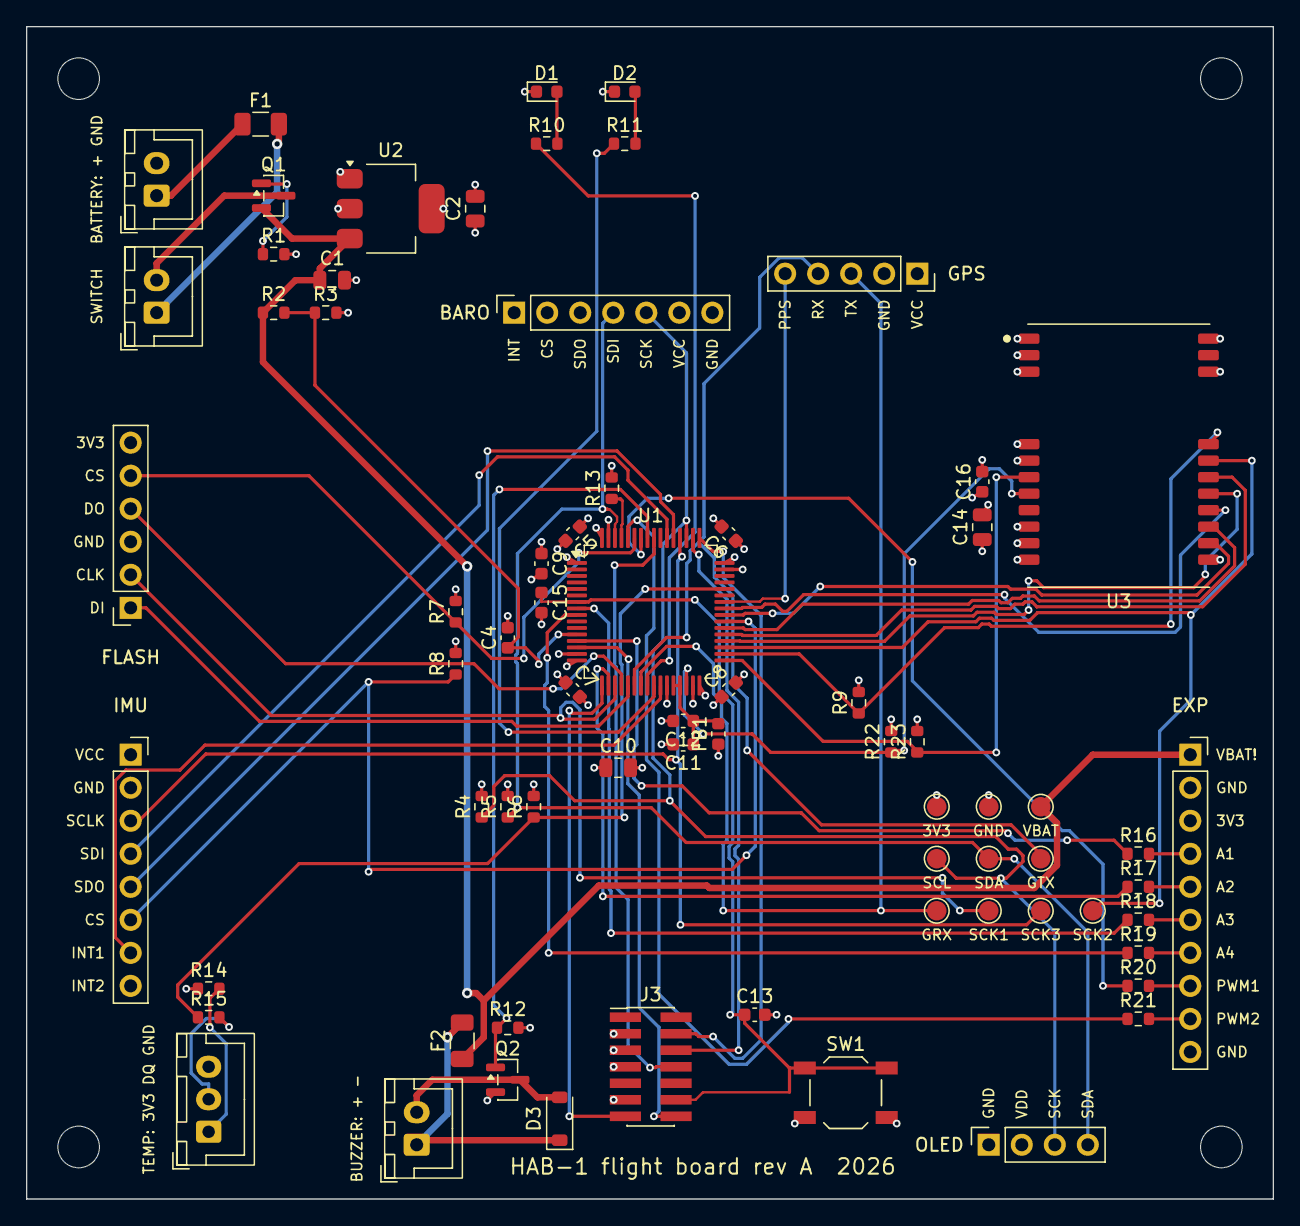
[picture p15: board hab1_flight.kicad_pcb from above]

Board: 4 copper layers, 95.9 x 90.2 mm, 75 parts (0 on the bottom side), 61 nets.
