barcklay/Cube_SAT/hardware/lora_adapter/e22_adapter.kicad_pcb

## KiCad design hardware/lora_adapter/e22_adapter.kicad_pcb (2026-10-08)

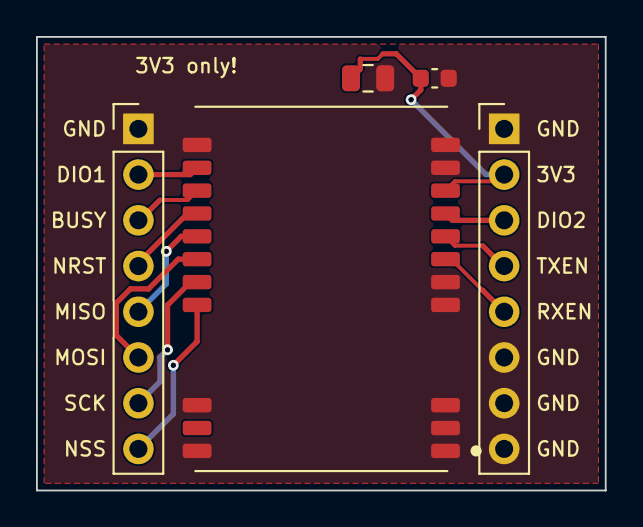
[picture p16: board e22_adapter.kicad_pcb from above]

Board: 2 copper layers, 31.6 x 25.2 mm, 5 parts (0 on the bottom side), 12 nets.

Parts:
C1: 4.7u; C_0805_2012Metric
C2: 100n; C_0603_1608Metric
J1: LEFT; PinHeader_1x08_P2.54mm_Vertical
J2: RIGHT; PinHeader_1x08_P2.54mm_Vertical
U1: E22-400M22S

Connections:
3V3: C1.1, C2.1, J2.2, U1.9
BUSY: J1.3, U1.14
DIO1: J1.2, U1.13
DIO2: J2.3, U1.8
GND: C1.2, C2.2, J1.1, J2.1, J2.6, J2.7, J2.8, U1.1, U1.2, U1.3, U1.4, U1.5, U1.10, U1.11, U1.12, U1.20, U1.22
MISO: J1.5, U1.16
MOSI: J1.6, U1.17
NRST: J1.4, U1.15
NSS: J1.8, U1.19
RXEN: J2.5, U1.6
SCK: J1.7, U1.18
TXEN: J2.4, U1.7
