barcklay/Cube_SAT/hab_bringup/Core/Src/main.c

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
/* Includes ------------------------------------------------------------------*/
#include "main.h"

/* USER CODE BEGIN Includes */
#include <stdio.h>
#include <stdlib.h>
#include <string.h>
#include <math.h>
#include "flight_sm.h"
#include "altitude_fuse.h"
#include "lora_e22.h"
#include "oled_screens.h"
/* USER CODE END Includes */

/* USER CODE BEGIN PTD */
/* BMP390 calibration coefficients, already scaled to floating point (datasheet 8.4). */
typedef struct
{
  double t1, t2, t3;
  double p1, p2, p3, p4, p5, p6, p7, p8, p9, p10, p11;
} BmpCalib;

/* One flash page (256 bytes) that survives reset and power-off. */
typedef struct
{
  uint32_t magic;
  uint32_t boot_count;
  uint8_t pattern[248];
} BootRecord;

/* Latest GPS data, filled from NMEA GGA and GSV sentences. */
typedef struct
{
  int fix_quality;  /* 0 = no fix, 1 = GPS fix, 2 = DGPS */
  int sats_used;
  double lat_deg;   /* + north */
  double lon_deg;   /* + east */
  double alt_m;     /* above mean sea level */
  char utc[7];      /* "hhmmss" */
} GpsData;

/* Last complete UBX frame from the GPS: answers to our config commands. */
typedef struct
{
  uint8_t cls;
  uint8_t id;
  uint16_t len;
  uint8_t payload[64];
  int ready;
} UbxFrame;

/* One telemetry frame: everything the flight computer knows at one moment.
   Filled every FRAME_PERIOD_MS; later written to flash (HW-16) and sent by radio (HW-13). */
typedef struct
{
  uint32_t seq;         /* frame number since boot */
  uint32_t t_ms;        /* time since boot when the frame was taken */
  uint16_t valid;       /* FRAME_OK_* bits: which sensors answered */
  float baro_pa;
  float baro_temp_c;
  float baro_rel_m;     /* altitude relative to the pressure at power-on */
  float acc_g[3];
  float gyro_dps[3];
  float out_temp_c;     /* DS18B20, refreshed once per second */
  uint8_t gps_fix;
  uint8_t gps_sats;
  uint8_t gps_in_view;
  int32_t gps_lat_e7;   /* degrees * 1e7, like u-blox */
  int32_t gps_lon_e7;
  float gps_alt_m;
  uint32_t work_us;     /* time spent reading sensors in this cycle */
  float alt_m;          /* altitude above the launch point, input of the state machine */
  float vz_mps;         /* vertical speed over the last 5 s, + = up */
  float asl_m;          /* altitude above sea level (barometer, reference: asl_src) */
  uint8_t state;        /* FlightState: PRELAUNCH ... LANDED (HW-18) */
  uint8_t asl_src;      /* ASL_STD / ASL_GPS / ASL_QNH */
  uint8_t alt_src;      /* ALT_SRC_*: barometer, mix, GPS, carried forward (HW-15) */
  uint8_t gps_model_fixes;  /* times the GPS lost its Airborne model and got it back */
} TelemetryFrame;

/* One log record in the SPI flash: exactly half a 256-byte page, so records never
   straddle a page. Erased flash reads 0xFF, so an unused slot has magic 0xFFFF. */
typedef struct
{
  uint16_t magic;        /* LOG_MAGIC */
  uint16_t boot;         /* boot number: shows where the board restarted */
  uint32_t index;        /* record number since the log was cleared = its slot number */
  TelemetryFrame frame;
  float ground_pa;       /* launch pressure: lets a reset in flight continue (HW-18) */
  float asl_offset;      /* sea-level reference at that time */
  float max_alt;         /* highest altitude above launch so far */
  uint8_t reset_cause;   /* why the board last restarted (RESET_*), 0xFF in older records */
  uint8_t reserved0;
  int16_t alt_bias_dm;   /* GPS minus barometer, 0.1 m (HW-15); -1 (0xFFFF) in older records */
  uint8_t reserved[128 - 8 - sizeof(TelemetryFrame) - 12 - 1 - 1 - 2 - 2];
  uint16_t crc;          /* CRC-16/CCITT of everything above */
} LogRecord;
_Static_assert(sizeof(LogRecord) == 128, "LogRecord must be 128 bytes");
/* USER CODE END PTD */

/* USER CODE BEGIN PD */
#define BMP390_ADDR      (0x77U << 1)
/* I2C clock pin: PB8 on the Nucleo bench, PA15 on the flight board (PB8 is BOOT0 there and is
   pulled down). The flight build is made with -DHAB_FLIGHT_BOARD (cmake preset "Flight"). */
#ifdef HAB_FLIGHT_BOARD
#define I2C_SCL_PORT     GPIOA
#define I2C_SCL_PIN      GPIO_PIN_15
#define I2C_SCL_NAME     "SCL (PA15, flight board)"
#else
#define I2C_SCL_PORT     GPIOB
#define I2C_SCL_PIN      GPIO_PIN_8
#define I2C_SCL_NAME     "SCL (PB8, D15)"
#endif
#define BMP_REG_CHIP_ID  0x00U
#define BMP_REG_ERR      0x02U
#define BMP_REG_DATA     0x04U  /* 6 bytes: pressure xlsb..msb, temperature xlsb..msb */
#define BMP_REG_PWR_CTRL 0x1BU
#define BMP_REG_OSR      0x1CU
#define BMP_REG_ODR      0x1DU
#define BMP_REG_CONFIG   0x1FU
#define BMP_REG_CALIB    0x31U  /* 21 bytes of calibration data */
#define BMP_REG_CMD      0x7EU

#define FLASH_CMD_WREN   0x06U
#define FLASH_CMD_RDSR   0x05U
#define FLASH_CMD_READ   0x03U
#define FLASH_CMD_PP     0x02U  /* page program, up to 256 bytes */
#define FLASH_CMD_SE     0x20U  /* 4 KB sector erase */
#define FLASH_CMD_JEDEC  0x9FU

#define FLASH_BOOT_ADDR  0x000000U  /* sector 0: boot record */
#define FLASH_DEMO_ADDR  0x001000U  /* sector 1: "write without erase" demo */
#define BOOT_MAGIC       0xCAFE5A7EU

#define STD_SEA_LEVEL_PA 101325.0

#define GPS_RX_BUF_SIZE  2048U  /* ~2 s of NMEA at 9600 baud */
#define GPS_LINE_MAX     100U   /* NMEA sentences are at most 82 chars */
#define GPS_TALKERS      "PLABQ" /* GP GPS, GL GLONASS, GA Galileo, GB BeiDou, GQ QZSS */

#define UBX_CLASS_ACK    0x05U
#define UBX_ID_ACK       0x01U
#define UBX_ID_NAK       0x00U
#define UBX_CLASS_CFG    0x06U
#define UBX_ID_VALSET    0x8AU
#define UBX_ID_VALGET    0x8BU
#define UBX_LAYER_RAM    0x01U  /* VALSET layer bits */
#define UBX_LAYER_BBR    0x02U  /* battery-backed RAM: kept while the backup cell holds */
#define CFG_NAVSPG_DYNMODEL 0x20110021UL  /* key ID, 1-byte value */
#define DYNMODEL_AIRBORNE_4G 8U
/* ICM-42688-P IMU on its own SPI3 (PC10/PC11/PC12), CS on PC7 (D9). Until PC7 gets the IMU_CS label in CubeMX,
   the pin is set up by ImuCsInit() below. */
#ifndef IMU_CS_Pin
#define IMU_CS_Pin       GPIO_PIN_7
#define IMU_CS_GPIO_Port GPIOC
#define IMU_CS_MANUAL_INIT 1
#endif
#define IMU_REG_WHO_AM_I 0x75U
#define IMU_WHO_AM_I_VAL 0x47U
#define IMU_REG_INTF_CONFIG0 0x4CU  /* bits 1:0 UI_SIFS_CFG: 11 = disable I2C */
#define IMU_REG_TEMP_DATA1   0x1DU  /* 14 bytes: temp, accel X/Y/Z, gyro X/Y/Z, big-endian */
#define IMU_REG_PWR_MGMT0    0x4EU
#define IMU_ACCEL_LSB_PER_G  2048.0  /* default range +-16 g */
#define IMU_GYRO_LSB_PER_DPS 16.4    /* default range +-2000 deg/s */

/* DS18B20 1-Wire commands */
#define OW_CMD_READ_ROM     0x33U
#define OW_CMD_SKIP_ROM     0xCCU
#define OW_CMD_CONVERT_T    0x44U
#define OW_CMD_READ_SCRATCH 0xBEU

#define FRAME_PERIOD_MS  200U  /* 5 frames per second */
#define DS18B20_EVERY_N  5U    /* DS18B20 needs 750 ms per conversion: read it once per second */
#define LOOP_STATS_EVERY 25U   /* print loop timing statistics every 25 frames = 5 s */
#define FRAME_OK_BARO    0x01U
#define FRAME_OK_IMU     0x02U
#define FRAME_OK_OUT     0x04U
#define FRAME_OK_GPSFIX  0x08U

/* Flight log in the SPI flash: sectors 0-1 are used by the boot test, the log starts at 8 KB. */
#define LOG_MAGIC        0x484CU                 /* "LH": record with flight state (HW-18); older "LG" records are overwritten */
#define LOG_START_ADDR   0x002000UL
#define LOG_END_ADDR     0x1000000UL             /* 16 MB */
#define LOG_RECORD_SIZE  128U
#define SECTOR_SIZE      4096U
#define LOG_PER_SECTOR   (SECTOR_SIZE / LOG_RECORD_SIZE)  /* 32 */
#define LOG_SLOTS        ((LOG_END_ADDR - LOG_START_ADDR) / LOG_RECORD_SIZE)
#define LOG_QUEUE_LEN    16U                     /* frames waiting while the flash is busy */
#define FLASH_CMD_CHIP_ERASE 0xC7U

/* Independent watchdog: its own 32 kHz oscillator, /64 -> 500 Hz, reload 999 -> 2 s. */
#define IWDG_KEY_START   0xCCCCU
#define IWDG_KEY_ACCESS  0x5555U
#define IWDG_KEY_FEED    0xAAAAU
#define IWDG_PRESCALER_64 4U
#define IWDG_RELOAD_2S   999U

#define RESET_POWER      1U
#define RESET_PIN        2U  /* black RESET button or the programmer */
#define RESET_SOFTWARE   3U
#define RESET_WATCHDOG   4U
#define RESET_BROWNOUT   5U

#define FRAME_OK_GPSLINK 0x10U  /* GPS is sending data (fresh GGA in the last 3 s) */
#define GPS_STALE_MS     3000U
#define RETRY_EVERY_N    25U    /* re-try a lost sensor every 25 frames = 5 s */

#define WIRING_DIAG      1  /* 1 = at boot, probe the SPI flash wiring and print a verdict */
#define GPS_ECHO_NMEA    0  /* 1 = also print every valid NMEA sentence (for logging) */

/* Flight state machine (HW-18) */
#define FRAME_SIM        0x80U  /* frame from the 'S' simulation: the altitude is synthetic */
#define FRAME_TEST       0x40U  /* frame in the 'T' lift test: real altitude, thresholds x0.05 */
#define TEST_SCALE       0.05f
#define TEST_LANDED_MAX  10.0f  /* lift test: landing only within 10 m of the start floor,
                                   so a lift stopping on the way down is not a landing */
#define LANDED_LOG_EVERY 50U    /* after landing one record per 10 s: the flash lasts for days */
#define BUZZER_EVERY_N   15U    /* after landing: one 200 ms beep every 3 s */
#define SIM_SPEED        40.0   /* 'S' simulation runs 40x faster than a real flight */
#define ASL_STD          0U     /* sea level from the standard 1013.25 hPa */
#define ASL_GPS          1U     /* sea level calibrated against GPS altitude before launch */
#define ASL_QNH          2U     /* sea-level pressure typed in with 'Q' */
/* USER CODE END PD */

/* USER CODE BEGIN PM */
/* Init functions stay quiet when a lost sensor is being re-tried every few seconds. */
#define INIT_PRINTF(...) do { if (init_verbose) { printf(__VA_ARGS__); } } while (0)

/* USER CODE END PM */


I2C_HandleTypeDef hi2c1;

UART_HandleTypeDef hlpuart1;
UART_HandleTypeDef huart1;

SPI_HandleTypeDef hspi1;
SPI_HandleTypeDef hspi3;

/* USER CODE BEGIN PV */
static BmpCalib bmp_cal;
static double ground_pa;  /* pressure at power-on, reference for relative altitude */
static double asl_offset; /* altitude above sea level = IsaAltitude(p) + asl_offset */
static uint8_t asl_src = ASL_STD;
static FlightSm fsm;
static AltFuse afuse;     /* barometer + GPS altitude (HW-15) */
static int sim_active;
static int test_mode;     /* 'T' lift test: a lift ride is a small flight */
static int reset_by_programmer;  /* this boot comes from st-flash, not from a fault */
static uint32_t sim_start_ms;
static uint32_t sim_rng = 12345U;
static LogRecord log_last;  /* last valid record found at boot: to continue after a reset */
static int log_last_ok;

/* Ring buffer: the UART interrupt writes at head, the main loop reads at tail. */
static uint8_t gps_rx_byte;
static uint8_t gps_rx_buf[GPS_RX_BUF_SIZE];
static volatile uint16_t gps_rx_head;
static volatile uint16_t gps_rx_tail;
static volatile uint32_t gps_rx_total;
static volatile uint32_t gps_rx_overflow;

static GpsData gps;
static UbxFrame ubx;
static int gsv_in_view[sizeof(GPS_TALKERS) - 1];  /* satellites in view per constellation */
static uint32_t nmea_ok, nmea_bad;
static int gps_boot_dynmodel = -1;
static uint16_t boot_id;
static uint8_t reset_cause;
static int init_verbose = 1;
static uint32_t gps_last_gga_ms;  /* tick of the last good GGA sentence */               /* boot counter from the boot record, stored in every log record */

/* Log state: next free slot, first slot that is not yet known to be erased, and a small
   queue for frames that arrive while the flash is busy erasing a sector. */
static uint32_t log_next;
static uint32_t log_erased_to;
static LogRecord log_queue[LOG_QUEUE_LEN];
static uint32_t log_q_head, log_q_tail;
static uint32_t log_written, log_dropped;
static int log_full;  /* RAM value right after power-up, before we set it */

/* Results of the power-on checks, kept for the bench OLED (HW-142) */
static uint8_t boot_flash_ok;    /* SPI flash: erase + write + read-back worked */
static uint8_t boot_gps_talks;   /* the GPS module sends valid NMEA */
static uint8_t boot_gps_airborne; /* and confirmed the Airborne <4g model */

/* The Airborne <4g model is set at power-on. If the GPS restarts on its own in flight
   (a dip in its supply) it may come back in the default model, which stops working above
   ~12 km. So it is asked once a minute, without waiting for the answer (HW-15). */
#define GPS_MODEL_CHECK_MS 60000U
static volatile int gps_model_answer = -1;  /* dynModel from a CFG-VALGET answer, set by the parser */
static uint32_t gps_model_next_ms;
static uint32_t gps_model_asked_ms;
static int gps_model_waiting;
static uint8_t gps_model_fixes;
/* USER CODE END PV */

void SystemClock_Config(void);
static void MX_GPIO_Init(void);
static void MX_LPUART1_UART_Init(void);
static void MX_I2C1_Init(void);
static void MX_SPI1_Init(void);
static void MX_USART1_UART_Init(void);
static void MX_SPI3_Init(void);
/* USER CODE BEGIN 0 */
/* printf here is newlib-nano without %f, so print fixed-point with N decimals. */
static void PrintFixed(double v, int decimals)
{
  long scale = 1;
  for (int i = 0; i < decimals; i++)
  {
    scale *= 10;
  }
  long x = lround(v * (double)scale);
  if (x < 0)
  {
    printf("-");
    x = -x;
  }
  char frac[12];
  long rest = x % scale;
  for (int i = decimals - 1; i >= 0; i--)
  {
    frac[i] = (char)('0' + rest % 10);
    rest /= 10;
  }
  frac[decimals] = '\0';
  printf(decimals > 0 ? "%ld.%s" : "%ld", x / scale, frac);
}

static void PrintFixed2(double v)
{
  PrintFixed(v, 2);
}

/* ---------------- BMP390 (I2C) ---------------- */

static HAL_StatusTypeDef BmpRead(uint8_t reg, uint8_t *buf, uint16_t len)
{
  return HAL_I2C_Mem_Read(&hi2c1, BMP390_ADDR, reg, I2C_MEMADD_SIZE_8BIT, buf, len, 100);
}

static HAL_StatusTypeDef BmpWrite(uint8_t reg, uint8_t val)
{
  return HAL_I2C_Mem_Write(&hi2c1, BMP390_ADDR, reg, I2C_MEMADD_SIZE_8BIT, &val, 1, 100);
}

static int BmpInit(void)
{
  uint8_t id = 0;
  if (BmpRead(BMP_REG_CHIP_ID, &id, 1) != HAL_OK || id != 0x60U)
  {
    INIT_PRINTF("BMP390: not found (id=0x%02X)\r\n", (unsigned int)id);
    return -1;
  }
  INIT_PRINTF("BMP390 chip ID: 0x%02X\r\n", (unsigned int)id);

  BmpWrite(BMP_REG_CMD, 0xB6U);  /* soft reset */
  HAL_Delay(10);

  /* Raw calibration from NVM, then scale each value as in datasheet 8.4. */
  uint8_t c[21];
  if (BmpRead(BMP_REG_CALIB, c, sizeof(c)) != HAL_OK)
  {
    INIT_PRINTF("BMP390: calibration read failed\r\n");
    return -1;
  }
  bmp_cal.t1 = ldexp((uint16_t)(c[1] << 8 | c[0]), 8);
  bmp_cal.t2 = ldexp((uint16_t)(c[3] << 8 | c[2]), -30);
  bmp_cal.t3 = ldexp((int8_t)c[4], -48);
  bmp_cal.p1 = ldexp((int16_t)(c[6] << 8 | c[5]) - 16384, -20);
  bmp_cal.p2 = ldexp((int16_t)(c[8] << 8 | c[7]) - 16384, -29);
  bmp_cal.p3 = ldexp((int8_t)c[9], -32);
  bmp_cal.p4 = ldexp((int8_t)c[10], -37);
  bmp_cal.p5 = ldexp((uint16_t)(c[12] << 8 | c[11]), 3);
  bmp_cal.p6 = ldexp((uint16_t)(c[14] << 8 | c[13]), -6);
  bmp_cal.p7 = ldexp((int8_t)c[15], -8);
  bmp_cal.p8 = ldexp((int8_t)c[16], -15);
  bmp_cal.p9 = ldexp((int16_t)(c[18] << 8 | c[17]), -48);
  bmp_cal.p10 = ldexp((int8_t)c[19], -48);
  bmp_cal.p11 = ldexp((int8_t)c[20], -65);

  BmpWrite(BMP_REG_OSR, 0x03U);       /* pressure x8, temperature x1 */
  BmpWrite(BMP_REG_ODR, 0x04U);       /* new sample every 80 ms (12.5 Hz) */
  BmpWrite(BMP_REG_CONFIG, 0x04U);    /* IIR filter coefficient 3: smooths noise */
  BmpWrite(BMP_REG_PWR_CTRL, 0x33U);  /* pressure on, temperature on, normal mode */
  HAL_Delay(100);

  uint8_t err = 0;
  BmpRead(BMP_REG_ERR, &err, 1);
  if (err != 0)
  {
    INIT_PRINTF("BMP390: config error 0x%02X\r\n", (unsigned int)err);
    return -1;
  }
  return 0;
}

/* Raw ADC values -> degrees C and Pa (datasheet 8.5, 8.6). */
static int BmpReadData(double *temp_c, double *press_pa)
{
  uint8_t d[6];
  if (BmpRead(BMP_REG_DATA, d, sizeof(d)) != HAL_OK)
  {
    return -1;
  }
  double up = (double)((uint32_t)d[2] << 16 | (uint32_t)d[1] << 8 | d[0]);
  double ut = (double)((uint32_t)d[5] << 16 | (uint32_t)d[4] << 8 | d[3]);

  double pd1 = ut - bmp_cal.t1;
  double t = pd1 * bmp_cal.t2 + pd1 * pd1 * bmp_cal.t3;

  double out1 = bmp_cal.p5 + bmp_cal.p6 * t + bmp_cal.p7 * t * t + bmp_cal.p8 * t * t * t;
  double out2 = up * (bmp_cal.p1 + bmp_cal.p2 * t + bmp_cal.p3 * t * t + bmp_cal.p4 * t * t * t);
  double out3 = up * up * (bmp_cal.p9 + bmp_cal.p10 * t) + up * up * up * bmp_cal.p11;

  *temp_c = t;
  *press_pa = out1 + out2 + out3;
  return 0;
}

/* Altitude difference between two pressures in the layered standard atmosphere
   (flight_sm.h). The old single formula was ~4.7 km low at 30 km. */
static double PressureToAltitude(double press_pa, double ref_pa)
{
  return IsaAltitude(press_pa) - IsaAltitude(ref_pa);
}

/* ---------------- SPI flash (GD25Q128 / W25Q128) ---------------- */

static void FlashSelect(void)
{
  HAL_GPIO_WritePin(FLASH_CS_GPIO_Port, FLASH_CS_Pin, GPIO_PIN_RESET);
}

static void FlashDeselect(void)
{
  HAL_GPIO_WritePin(FLASH_CS_GPIO_Port, FLASH_CS_Pin, GPIO_PIN_SET);
}

/* Command byte + 24-bit address, most significant byte first. */
static void FlashSendCmdAddr(uint8_t cmd, uint32_t addr)
{
  uint8_t hdr[4] = {cmd, (uint8_t)(addr >> 16), (uint8_t)(addr >> 8), (uint8_t)addr};
  HAL_SPI_Transmit(&hspi1, hdr, sizeof(hdr), 100);
}

static void FlashWriteEnable(void)
{
  uint8_t cmd = FLASH_CMD_WREN;
  FlashSelect();
  HAL_SPI_Transmit(&hspi1, &cmd, 1, 100);
  FlashDeselect();
}

/* Status register bit 0 (BUSY) is 1 while erase/program is running. */
static int FlashWaitReady(uint32_t timeout_ms)
{
  uint32_t start = HAL_GetTick();
  uint8_t cmd = FLASH_CMD_RDSR;
  uint8_t sr = 0;
  do
  {
    FlashSelect();
    HAL_SPI_Transmit(&hspi1, &cmd, 1, 100);
    HAL_SPI_Receive(&hspi1, &sr, 1, 100);
    FlashDeselect();
    if ((sr & 0x01U) == 0)
    {
      return 0;
    }
  } while (HAL_GetTick() - start < timeout_ms);
  return -1;
}

static void FlashReadJedec(uint8_t id[3])
{
  uint8_t cmd = FLASH_CMD_JEDEC;
  FlashSelect();
  HAL_SPI_Transmit(&hspi1, &cmd, 1, 100);
  HAL_SPI_Receive(&hspi1, id, 3, 100);
  FlashDeselect();
}

static void FlashRead(uint32_t addr, uint8_t *buf, uint16_t len)
{
  FlashSelect();
  FlashSendCmdAddr(FLASH_CMD_READ, addr);
  HAL_SPI_Receive(&hspi1, buf, len, 1000);
  FlashDeselect();
}

/* Sets every bit of a 4 KB sector back to 1 (all bytes = 0xFF). */
static int FlashEraseSector(uint32_t addr)
{
  FlashWriteEnable();
  FlashSelect();
  FlashSendCmdAddr(FLASH_CMD_SE, addr);
  FlashDeselect();
  return FlashWaitReady(1000);
}

/* Programming can only turn bits 1 -> 0, never 0 -> 1. Must stay inside one 256-byte page. */
static int FlashProgramPage(uint32_t addr, const uint8_t *data, uint16_t len)
{
  FlashWriteEnable();
  FlashSelect();
  FlashSendCmdAddr(FLASH_CMD_PP, addr);
  HAL_SPI_Transmit(&hspi1, (uint8_t *)data, len, 100);
  FlashDeselect();
  return FlashWaitReady(100);
}

/* Boot counter in sector 0: proves data survives reset and power-off. */
static void FlashBootTest(void)
{
  uint8_t id[3];
  FlashReadJedec(id);
  printf("Flash JEDEC: %02X %02X %02X\r\n", id[0], id[1], id[2]);

  BootRecord rec;
  FlashRead(FLASH_BOOT_ADDR, (uint8_t *)&rec, sizeof(rec));

  uint32_t prev = 0;
  if (rec.magic == BOOT_MAGIC)
  {
    int intact = 1;
    for (uint32_t i = 0; i < sizeof(rec.pattern); i++)
    {
      if (rec.pattern[i] != (uint8_t)(i + rec.boot_count))
      {
        intact = 0;
      }
    }
    prev = rec.boot_count;
    printf("Flash: found record from previous boot, boot_count=%lu, data %s\r\n",
           (unsigned long)prev, intact ? "intact" : "CORRUPTED");
  }
  else
  {
    printf("Flash: no record yet (first boot or blank sector)\r\n");
  }

  rec.magic = BOOT_MAGIC;
  rec.boot_count = prev + 1;
  boot_id = (uint16_t)rec.boot_count;
  for (uint32_t i = 0; i < sizeof(rec.pattern); i++)
  {
    rec.pattern[i] = (uint8_t)(i + rec.boot_count);
  }

  BootRecord check;
  int ok = FlashEraseSector(FLASH_BOOT_ADDR) == 0
        && FlashProgramPage(FLASH_BOOT_ADDR, (uint8_t *)&rec, sizeof(rec)) == 0;
  FlashRead(FLASH_BOOT_ADDR, (uint8_t *)&check, sizeof(check));
  ok = ok && memcmp(&rec, &check, sizeof(rec)) == 0;
  printf("Flash: erase + write + read-back %s, boot_count now %lu\r\n",
         ok ? "OK" : "FAILED", (unsigned long)rec.boot_count);
  boot_flash_ok = (uint8_t)ok;
}

/* Why erase is required: programming only clears bits, so old & new = result. */
static void FlashNoEraseDemo(void)
{
  uint8_t b;
  FlashEraseSector(FLASH_DEMO_ADDR);
  FlashRead(FLASH_DEMO_ADDR, &b, 1);
  printf("Flash demo: after erase          -> %02X\r\n", b);
  b = 0xF0U;
  FlashProgramPage(FLASH_DEMO_ADDR, &b, 1);
  FlashRead(FLASH_DEMO_ADDR, &b, 1);
  printf("Flash demo: write F0             -> %02X\r\n", b);
  b = 0x0FU;
  FlashProgramPage(FLASH_DEMO_ADDR, &b, 1);
  FlashRead(FLASH_DEMO_ADDR, &b, 1);
  printf("Flash demo: write 0F, no erase   -> %02X (F0 & 0F)\r\n", b);
}

/* ---------------- IMU ICM-42688-P (SPI3, own bus) ---------------- */

static void ImuCsInit(void)
{
#ifdef IMU_CS_MANUAL_INIT
  /* CS must idle high, otherwise the IMU answers while we talk to the flash. */
  __HAL_RCC_GPIOC_CLK_ENABLE();
  HAL_GPIO_WritePin(IMU_CS_GPIO_Port, IMU_CS_Pin, GPIO_PIN_SET);
  GPIO_InitTypeDef g = {0};
  g.Pin = IMU_CS_Pin;
  g.Mode = GPIO_MODE_OUTPUT_PP;
  g.Pull = GPIO_NOPULL;
  g.Speed = GPIO_SPEED_FREQ_LOW;
  HAL_GPIO_Init(IMU_CS_GPIO_Port, &g);
#endif
  HAL_GPIO_WritePin(IMU_CS_GPIO_Port, IMU_CS_Pin, GPIO_PIN_SET);
}

/* SPI read: first byte = register address with bit 7 set (= read). */
static uint8_t ImuReadReg(uint8_t reg)
{
  uint8_t tx = reg | 0x80U;
  uint8_t val = 0;
  HAL_GPIO_WritePin(IMU_CS_GPIO_Port, IMU_CS_Pin, GPIO_PIN_RESET);
  HAL_SPI_Transmit(&hspi3, &tx, 1, 100);
  HAL_SPI_Receive(&hspi3, &val, 1, 100);
  HAL_GPIO_WritePin(IMU_CS_GPIO_Port, IMU_CS_Pin, GPIO_PIN_SET);
  return val;
}

static void ImuWriteReg(uint8_t reg, uint8_t val)
{
  uint8_t tx[2] = {reg & 0x7FU, val};
  HAL_GPIO_WritePin(IMU_CS_GPIO_Port, IMU_CS_Pin, GPIO_PIN_RESET);
  HAL_SPI_Transmit(&hspi3, tx, sizeof(tx), 100);
  HAL_GPIO_WritePin(IMU_CS_GPIO_Port, IMU_CS_Pin, GPIO_PIN_SET);
}

/* The IMU shares its SPI pins with I2C (SCLK = SCL, SDI = SDA). We use SPI only,
   so switch the I2C interface off (it usually already is). */
static void ImuDisableI2c(void)
{
  uint8_t before = ImuReadReg(IMU_REG_INTF_CONFIG0);
  ImuWriteReg(IMU_REG_INTF_CONFIG0, (uint8_t)((before & ~0x03U) | 0x03U));
  uint8_t after = ImuReadReg(IMU_REG_INTF_CONFIG0);
  INIT_PRINTF("IMU INTF_CONFIG0: 0x%02X -> 0x%02X (I2C off)\r\n", (unsigned int)before, (unsigned int)after);
}

/* Burst read: the register address auto-increments while CS stays low. */
static void ImuReadRegs(uint8_t reg, uint8_t *buf, uint16_t len)
{
  uint8_t tx = reg | 0x80U;
  HAL_GPIO_WritePin(IMU_CS_GPIO_Port, IMU_CS_Pin, GPIO_PIN_RESET);
  HAL_SPI_Transmit(&hspi3, &tx, 1, 100);
  HAL_SPI_Receive(&hspi3, buf, len, 100);
  HAL_GPIO_WritePin(IMU_CS_GPIO_Port, IMU_CS_Pin, GPIO_PIN_SET);
}

static int ImuInit(void)
{
  uint8_t id = ImuReadReg(IMU_REG_WHO_AM_I);
  INIT_PRINTF("IMU WHO_AM_I: 0x%02X (%s)\r\n", (unsigned int)id,
         id == IMU_WHO_AM_I_VAL ? "ICM-42688-P OK" : "unexpected");
  if (id != IMU_WHO_AM_I_VAL)
  {
    return -1;
  }
  ImuDisableI2c();
  ImuWriteReg(IMU_REG_PWR_MGMT0, 0x0FU);  /* gyro + accel on, low-noise mode */
  HAL_Delay(50);                          /* gyro needs ~45 ms to start */
  return 0;
}

/* Raw 16-bit big-endian values (after 2 temperature bytes) -> g and deg/s. */
static void ImuRead(float acc_g[3], float gyro_dps[3])
{
  uint8_t d[14];
  ImuReadRegs(IMU_REG_TEMP_DATA1, d, sizeof(d));
  for (int i = 0; i < 3; i++)
  {
    int16_t a = (int16_t)((uint16_t)d[2 + 2 * i] << 8 | d[3 + 2 * i]);
    int16_t g = (int16_t)((uint16_t)d[8 + 2 * i] << 8 | d[9 + 2 * i]);
    acc_g[i] = (float)(a / IMU_ACCEL_LSB_PER_G);
    gyro_dps[i] = (float)(g / IMU_GYRO_LSB_PER_DPS);
  }
}

/* ---------------- Wiring check for the SPI flash ----------------
   SPI1 is switched off and the pins are driven by hand (bit-bang), so we can try
   "what if" cases: CS on another socket, DI and DO swapped. The case where the flash
   answers its real JEDEC ID tells which wire is where. */

typedef struct
{
  GPIO_TypeDef *port;
  uint16_t pin;
  const char *name;
} DiagPin;

static void DiagPinMode(const DiagPin *p, uint32_t mode, uint32_t pull)
{
  GPIO_InitTypeDef g = {0};
  g.Pin = p->pin;
  g.Mode = mode;
  g.Pull = pull;
  g.Speed = GPIO_SPEED_FREQ_LOW;
  HAL_GPIO_Init(p->port, &g);
}

static void DiagDelay(void)
{
  for (volatile int i = 0; i < 40; i++)
  {
  }
}

/* SPI mode 0 by hand: set data, clock up (device samples), read, clock down. */
static void DiagTransfer(const DiagPin *cs, const DiagPin *mosi, const DiagPin *miso,
                         const DiagPin *sck, const uint8_t *tx, uint8_t *rx, int n)
{
  HAL_GPIO_WritePin(cs->port, cs->pin, GPIO_PIN_RESET);
  DiagDelay();
  for (int i = 0; i < n; i++)
  {
    uint8_t in = 0;
    for (int bit = 7; bit >= 0; bit--)
    {
      HAL_GPIO_WritePin(mosi->port, mosi->pin, (tx[i] >> bit) & 1U ? GPIO_PIN_SET : GPIO_PIN_RESET);
      DiagDelay();
      HAL_GPIO_WritePin(sck->port, sck->pin, GPIO_PIN_SET);
      DiagDelay();
      in = (uint8_t)(in << 1 | (HAL_GPIO_ReadPin(miso->port, miso->pin) == GPIO_PIN_SET));
      HAL_GPIO_WritePin(sck->port, sck->pin, GPIO_PIN_RESET);
    }
    rx[i] = in;
  }
  HAL_GPIO_WritePin(cs->port, cs->pin, GPIO_PIN_SET);
  DiagDelay();
}

/* JEDEC read (command 0x9F, then 3 answer bytes). */
static void DiagJedec(const DiagPin *cs, const DiagPin *mosi, const DiagPin *miso,
                      const DiagPin *sck, uint8_t id[3])
{
  uint8_t tx[4] = {FLASH_CMD_JEDEC, 0, 0, 0};
  uint8_t rx[4];
  DiagPinMode(mosi, GPIO_MODE_OUTPUT_PP, GPIO_NOPULL);
  DiagPinMode(miso, GPIO_MODE_INPUT, GPIO_PULLUP);
  DiagTransfer(cs, mosi, miso, sck, tx, rx, 4);
  memcpy(id, &rx[1], 3);
}

static void FlashWiringCheck(void)
{
  const DiagPin sck  = {GPIOA, GPIO_PIN_5, "D13"};
  const DiagPin line_d11 = {GPIOA, GPIO_PIN_7, "D11"};
  const DiagPin line_d12 = {GPIOA, GPIO_PIN_6, "D12"};
  /* D8 (PA9) has nothing on it: reading "through" it shows what the line looks like when nobody answers. */
  const DiagPin cs_list[] = {{GPIOB, GPIO_PIN_6, "D10"}, {GPIOC, GPIO_PIN_7, "D9"}, {GPIOA, GPIO_PIN_9, "D8"}};
  const int n_cs = (int)(sizeof(cs_list) / sizeof(cs_list[0]));

  printf("--- Flash wiring check (expected JEDEC C8 40 18) ---\r\n");
  HAL_SPI_DeInit(&hspi1);
  __HAL_RCC_GPIOA_CLK_ENABLE();
  __HAL_RCC_GPIOB_CLK_ENABLE();
  __HAL_RCC_GPIOC_CLK_ENABLE();
  for (int c = 0; c < n_cs; c++)
  {
    HAL_GPIO_WritePin(cs_list[c].port, cs_list[c].pin, GPIO_PIN_SET);
    DiagPinMode(&cs_list[c], GPIO_MODE_OUTPUT_PP, GPIO_NOPULL);
  }
  HAL_GPIO_WritePin(sck.port, sck.pin, GPIO_PIN_RESET);
  DiagPinMode(&sck, GPIO_MODE_OUTPUT_PP, GPIO_NOPULL);

  uint8_t idle[2][3];
  for (int swapped = 0; swapped <= 1; swapped++)
  {
    DiagJedec(&cs_list[n_cs - 1], swapped ? &line_d12 : &line_d11, swapped ? &line_d11 : &line_d12,
              &sck, idle[swapped]);
  }

  const char *found_cs = NULL;
  int found_swapped = 0;
  int any_driven = 0;
  for (int c = 0; c < n_cs - 1; c++)
  {
    for (int swapped = 0; swapped <= 1; swapped++)
    {
      const DiagPin *mosi = swapped ? &line_d12 : &line_d11;
      const DiagPin *miso = swapped ? &line_d11 : &line_d12;
      uint8_t id[3];
      DiagJedec(&cs_list[c], mosi, miso, &sck, id);
      int driven = memcmp(id, idle[swapped], 3) != 0;
      any_driven |= driven;
      int ok = id[0] == 0xC8U && id[1] == 0x40U && id[2] == 0x18U;
      printf("  CS=%-3s DI->%s DO->%s : %02X %02X %02X  %s%s\r\n", cs_list[c].name,
             mosi->name, miso->name, id[0], id[1], id[2],
             driven ? "someone answers" : "no answer (same as nothing selected)", ok ? "  <== FLASH" : "");
      if (ok && found_cs == NULL)
      {
        found_cs = cs_list[c].name;
        found_swapped = swapped;
      }
    }
  }

  if (found_cs != NULL && strcmp(found_cs, "D10") == 0 && !found_swapped)
  {
    printf("VERDICT: flash wiring is correct.\r\n");
  }
  else if (found_cs != NULL)
  {
    printf("VERDICT: flash answers with CS on %s%s.\r\n", found_cs,
           found_swapped ? " and DI/DO SWAPPED (DI must go to D11 row, DO to D12 row)" : "");
    if (strcmp(found_cs, "D10") != 0)
    {
      printf("         -> move the flash CS wire to D10.\r\n");
    }
  }
  else if (!any_driven)
  {
    printf("VERDICT: nobody drives the answer line. Check flash DO -> D12 row, CLK -> D13 row,\r\n"
           "         3V3/GND of the flash, and HOLD/WP if the module has them.\r\n");
  }
  else
  {
    printf("VERDICT: something answers but never the flash ID. Likely CLK (D13 row) or DI\r\n"
           "         (D11 row) of the flash is not connected, so it never gets the command.\r\n");
  }

  /* Give the pins back to SPI1 and restore the chip selects. */
  DiagPinMode(&cs_list[2], GPIO_MODE_INPUT, GPIO_NOPULL);
  HAL_SPI_Init(&hspi1);
  HAL_GPIO_WritePin(FLASH_CS_GPIO_Port, FLASH_CS_Pin, GPIO_PIN_SET);
  HAL_GPIO_WritePin(IMU_CS_GPIO_Port, IMU_CS_Pin, GPIO_PIN_SET);
  printf("--- end of wiring check ---\r\n");
}

/* ---------------- DS18B20 outside thermometer (1-Wire on PA10 = D2) ----------------
   One data wire, open-drain: writing 0 pulls the line low, writing 1 releases it and
   the 4.7k resistor pulls it back up. The sensor answers by pulling low too.
   Every bit is a short, precisely timed low pulse, so we need a microsecond delay. */

static void DelayUsInit(void)
{
  CoreDebug->DEMCR |= CoreDebug_DEMCR_TRCENA_Msk;  /* enable the cycle counter (not reset: */
  DWT->CTRL |= DWT_CTRL_CYCCNTENA_Msk;              /* the frame loop measures time with it) */
}

static void DelayUs(uint32_t us)
{
  uint32_t start = DWT->CYCCNT;
  uint32_t ticks = us * (SystemCoreClock / 1000000U);
  while (DWT->CYCCNT - start < ticks)
  {
  }
}

static void OwLow(void)
{
  HAL_GPIO_WritePin(DS18B20_GPIO_Port, DS18B20_Pin, GPIO_PIN_RESET);
}

static void OwRelease(void)
{
  HAL_GPIO_WritePin(DS18B20_GPIO_Port, DS18B20_Pin, GPIO_PIN_SET);
}

static int OwRead(void)
{
  return HAL_GPIO_ReadPin(DS18B20_GPIO_Port, DS18B20_Pin) == GPIO_PIN_SET;
}

/* Reset: low for 480 us, then a present sensor pulls the line low for 60-240 us. */
static int OwReset(void)
{
  OwLow();
  DelayUs(480);
  __disable_irq();
  OwRelease();
  DelayUs(70);
  int present = !OwRead();
  __enable_irq();
  DelayUs(410);
  return present;
}

/* Bits go least significant first. A "1" is a short low pulse, a "0" a long one. */
static void OwWriteByte(uint8_t b)
{
  for (int i = 0; i < 8; i++)
  {
    __disable_irq();
    OwLow();
    if (b & 1U)
    {
      DelayUs(6);
      OwRelease();
      DelayUs(64);
    }
    else
    {
      DelayUs(60);
      OwRelease();
      DelayUs(10);
    }
    __enable_irq();
    b >>= 1;
  }
}

/* Read: short low pulse, release, then sample: the sensor holds the line low for a "0". */
static uint8_t OwReadByte(void)
{
  uint8_t b = 0;
  for (int i = 0; i < 8; i++)
  {
    __disable_irq();
    OwLow();
    DelayUs(3);
    OwRelease();
    DelayUs(10);
    if (OwRead())
    {
      b |= (uint8_t)(1U << i);
    }
    __enable_irq();
    DelayUs(53);
  }
  return b;
}

/* Dallas/Maxim CRC-8 (polynomial x^8 + x^5 + x^4 + 1), checks ROM and scratchpad. */
static uint8_t OwCrc8(const uint8_t *data, int len)
{
  uint8_t crc = 0;
  for (int i = 0; i < len; i++)
  {
    uint8_t in = data[i];
    for (int bit = 0; bit < 8; bit++)
    {
      uint8_t mix = (uint8_t)((crc ^ in) & 1U);
      crc >>= 1;
      if (mix)
      {
        crc ^= 0x8CU;
      }
      in >>= 1;
    }
  }
  return crc;
}

static int Ds18b20Init(void)
{
  DelayUsInit();
  if (!OwReset())
  {
    INIT_PRINTF("DS18B20: no presence pulse (check yellow wire -> D2, 4.7k to 3V3, power)\r\n");
    return -1;
  }
  uint8_t rom[8];
  OwWriteByte(OW_CMD_READ_ROM);
  for (int i = 0; i < 8; i++)
  {
    rom[i] = OwReadByte();
  }
  INIT_PRINTF("DS18B20 ROM: %02X %02X%02X%02X%02X%02X%02X %02X  family 0x%02X (%s), CRC %s\r\n",
         rom[0], rom[6], rom[5], rom[4], rom[3], rom[2], rom[1], rom[7], rom[0],
         rom[0] == 0x28U ? "DS18B20" : "unexpected", OwCrc8(rom, 7) == rom[7] ? "OK" : "BAD");
  return (rom[0] == 0x28U && OwCrc8(rom, 7) == rom[7]) ? 0 : -1;
}

/* Start a temperature conversion (12-bit takes up to 750 ms). */
static void Ds18b20StartConversion(void)
{
  if (OwReset())
  {
    OwWriteByte(OW_CMD_SKIP_ROM);
    OwWriteByte(OW_CMD_CONVERT_T);
  }
}

/* Read the result of the last conversion. Returns 0 and the temperature, or -1. */
static int Ds18b20ReadTemp(double *temp_c)
{
  if (!OwReset())
  {
    return -1;
  }
  OwWriteByte(OW_CMD_SKIP_ROM);
  OwWriteByte(OW_CMD_READ_SCRATCH);
  uint8_t sp[9];
  for (int i = 0; i < 9; i++)
  {
    sp[i] = OwReadByte();
  }
  if (OwCrc8(sp, 8) != sp[8])
  {
    return -1;
  }
  /* A floating or shorted data line reads all zeros, and the CRC of all zeros is 0, so the
     CRC alone passes it (seen as a fake 0.0 C when the probe wire was pulled). Check the
     bits the DS18B20 always sets: config register 0bx11111 and reserved byte 5 = 0xFF. */
  if ((sp[4] & 0x9FU) != 0x1FU || sp[5] != 0xFFU)
  {
    return -1;
  }
  int16_t raw = (int16_t)((uint16_t)sp[1] << 8 | sp[0]);  /* 1/16 degree steps */
  *temp_c = raw / 16.0;
  return 0;
}

/* ---------------- Watchdog and reset cause ----------------
   The IWDG counts down on its own oscillator. If the program does not "feed" it within
   2 s (because it hung), the chip resets. Once started it cannot be stopped. */

static void WatchdogStart(void)
{
  IWDG->KR = IWDG_KEY_START;
  IWDG->KR = IWDG_KEY_ACCESS;       /* unlock the prescaler and reload registers */
  IWDG->PR = IWDG_PRESCALER_64;
  IWDG->RLR = IWDG_RELOAD_2S;
  while (IWDG->SR != 0U)            /* wait until the new values are taken */
  {
  }
  IWDG->KR = IWDG_KEY_FEED;
}

static void WatchdogFeed(void)
{
  IWDG->KR = IWDG_KEY_FEED;
}

/* RCC keeps flags telling why the chip restarted; read them once, then clear them. */
static void ResetCauseCapture(void)
{
  uint32_t csr = RCC->CSR;
  if (csr & RCC_CSR_IWDGRSTF)
  {
    reset_cause = RESET_WATCHDOG;
  }
  else if (csr & RCC_CSR_SFTRSTF)
  {
    reset_cause = RESET_SOFTWARE;
  }
  else if (csr & RCC_CSR_BORRSTF)
  {
    reset_cause = RESET_POWER;      /* power-on also sets the brown-out flag */
  }
  else if (csr & RCC_CSR_PINRSTF)
  {
    reset_cause = RESET_PIN;
  }
  else
  {
    reset_cause = RESET_BROWNOUT;
  }
  RCC->CSR |= RCC_CSR_RMVF;
}

static const char *ResetCauseName(uint8_t c)
{
  switch (c)
  {
    case RESET_POWER: return "power-on";
    case RESET_PIN: return "reset pin / programmer";
    case RESET_SOFTWARE: return "software";
    case RESET_WATCHDOG: return "WATCHDOG (the program hung)";
    default: return "other";
  }
}

/* ---------------- Flight log in the SPI flash ----------------
   Records are appended one after another. The flash only turns bits 1 -> 0, so each
   sector is erased (all 0xFF) before we write into it; the next sector is erased in
   advance, while the current one fills up, so the frame loop never waits for an erase.
   After a reboot the log is scanned to find where it ended and continues from there. */

static uint16_t Crc16Ccitt(const uint8_t *data, uint32_t len)
{
  uint16_t crc = 0xFFFFU;
  while (len--)
  {
    crc ^= (uint16_t)(*data++ << 8);
    for (int bit = 0; bit < 8; bit++)
    {
      crc = (crc & 0x8000U) ? (uint16_t)((crc << 1) ^ 0x1021U) : (uint16_t)(crc << 1);
    }
  }
  return crc;
}

static uint32_t LogSlotAddr(uint32_t slot)
{
  return LOG_START_ADDR + slot * LOG_RECORD_SIZE;
}

static int FlashBusy(void)
{
  uint8_t cmd = FLASH_CMD_RDSR;
  uint8_t sr = 0;
  FlashSelect();
  HAL_SPI_Transmit(&hspi1, &cmd, 1, 100);
  HAL_SPI_Receive(&hspi1, &sr, 1, 100);
  FlashDeselect();
  return (sr & 0x01U) != 0;
}

/* Start a sector erase and return at once; the flash stays busy for up to ~0.4 s. */
static void FlashStartErase(uint32_t addr)
{
  FlashWriteEnable();
  FlashSelect();
  FlashSendCmdAddr(FLASH_CMD_SE, addr);
  FlashDeselect();
}

/* Start a page program and return at once; the flash stays busy for ~1-3 ms. */
static void FlashStartProgram(uint32_t addr, const uint8_t *data, uint16_t len)
{
  FlashWriteEnable();
  FlashSelect();
  FlashSendCmdAddr(FLASH_CMD_PP, addr);
  HAL_SPI_Transmit(&hspi1, (uint8_t *)data, len, 100);
  FlashDeselect();
}

/* 1 = valid record for this slot, 0 = erased (all 0xFF), -1 = something else (broken). */
static int LogCheckSlot(uint32_t slot, LogRecord *r)
{
  FlashRead(LogSlotAddr(slot), (uint8_t *)r, sizeof(*r));
  if (r->magic == LOG_MAGIC && r->index == slot &&
      r->crc == Crc16Ccitt((const uint8_t *)r, sizeof(*r) - 2))
  {
    return 1;
  }
  const uint8_t *b = (const uint8_t *)r;
  for (uint32_t i = 0; i < sizeof(*r); i++)
  {
    if (b[i] != 0xFFU)
    {
      return -1;
    }
  }
  return 0;
}

/* Find where the log ended: first by sectors (first slot of each sector), then inside
   the last used sector. A record broken by a power cut is skipped, never overwritten. */
static void LogInit(void)
{
  LogRecord r;
  uint32_t sectors = LOG_SLOTS / LOG_PER_SECTOR;
  uint32_t used = 0;
  while (used < sectors && LogCheckSlot(used * LOG_PER_SECTOR, &r) == 1)
  {
    used++;
  }

  if (used == 0)
  {
    log_next = 0;
    log_erased_to = 0;  /* nothing known to be erased: erase before the first write */
  }
  else
  {
    uint32_t base = (used - 1) * LOG_PER_SECTOR;
    uint32_t slot = base;
    uint16_t last_boot = 0;
    while (slot < base + LOG_PER_SECTOR && LogCheckSlot(slot, &r) == 1)
    {
      last_boot = r.boot;
      log_last = r;
      log_last_ok = 1;
      slot++;
    }
    uint32_t skipped = 0;
    while (slot < base + LOG_PER_SECTOR && LogCheckSlot(slot, &r) != 0)
    {
      slot++;  /* half-written record from a power cut: leave it, go past it */
      skipped++;
    }
    log_next = slot;
    log_erased_to = base + LOG_PER_SECTOR;  /* this sector was erased before it was used */
    printf("LOG: found %lu records, last from boot %u, %lu broken slot(s) skipped\r\n",
           (unsigned long)log_next - skipped, last_boot, (unsigned long)skipped);
  }
  printf("LOG: writing from record %lu, room for %lu more (%lu min at 5 Hz)\r\n",
         (unsigned long)log_next, (unsigned long)(LOG_SLOTS - log_next),
         (unsigned long)((LOG_SLOTS - log_next) / 5U / 60U));
}

/* Called once per frame: wrap the frame into a record and queue it. */
static void LogPush(const TelemetryFrame *f)
{
  if (log_full)
  {
    return;
  }
  uint32_t next = (log_q_head + 1U) % LOG_QUEUE_LEN;
  if (next == log_q_tail)
  {
    log_dropped++;  /* flash busy for too long: queue is full */
    return;
  }
  LogRecord *r = &log_queue[log_q_head];
  memset(r, 0xFF, sizeof(*r));
  r->magic = LOG_MAGIC;
  r->boot = boot_id;
  r->reset_cause = reset_cause;
  r->frame = *f;
  r->ground_pa = (float)ground_pa;
  r->asl_offset = (float)asl_offset;
  r->max_alt = fsm.max_alt;
  double bias_dm = afuse.bias_m * 10.0;
  r->alt_bias_dm = (int16_t)lround(bias_dm > 32000.0 ? 32000.0 : (bias_dm < -32000.0 ? -32000.0 : bias_dm));
  log_q_head = next;
}

/* Called as often as possible: does at most one flash operation and never waits. */
static void LogService(void)
{
  if (log_full || FlashBusy())
  {
    return;
  }
  if (log_q_tail != log_q_head)
  {
    if (log_next >= LOG_SLOTS)
    {
      log_full = 1;
      printf("LOG: FULL, logging stopped\r\n");
      return;
    }
    if (log_next >= log_erased_to)
    {
      FlashStartErase(LogSlotAddr(log_erased_to));  /* sector not erased yet: do it now */
      log_erased_to += LOG_PER_SECTOR;
      return;
    }
    LogRecord *r = &log_queue[log_q_tail];
    r->index = log_next;
    r->crc = Crc16Ccitt((const uint8_t *)r, sizeof(*r) - 2);
    FlashStartProgram(LogSlotAddr(log_next), (const uint8_t *)r, sizeof(*r));
    log_next++;
    log_written++;
    log_q_tail = (log_q_tail + 1U) % LOG_QUEUE_LEN;
  }
  else if (log_erased_to < log_next + 2U * LOG_PER_SECTOR && log_erased_to < LOG_SLOTS)
  {
    FlashStartErase(LogSlotAddr(log_erased_to));  /* nothing to write: erase ahead */
    log_erased_to += LOG_PER_SECTOR;
  }
}

/* Console command 'D': print the whole log as CSV. */
static void LogDump(void)
{
  uint32_t t0 = HAL_GetTick();
  while (FlashBusy() && HAL_GetTick() - t0 < 1000U)
  {
  }
  printf("LOGDUMP BEGIN %lu\r\n", (unsigned long)log_next);
  printf("index,boot,seq,t_ms,valid,baro_pa,baro_temp_c,baro_rel_m,ax_g,ay_g,az_g,"
         "gx_dps,gy_dps,gz_dps,out_temp_c,gps_fix,gps_sats,gps_lat,gps_lon,gps_alt_m,reset_cause,"
         "state,alt_m,vz_mps,asl_m,sim,alt_src,gps_model_fixes\r\n");
  uint32_t bad = 0;
  for (uint32_t slot = 0; slot < log_next; slot++)
  {
    WatchdogFeed();
    LogRecord r;
    if (LogCheckSlot(slot, &r) != 1)
    {
      bad++;
      continue;
    }
    const TelemetryFrame *f = &r.frame;
    printf("%lu,%u,%lu,%lu,%u,", (unsigned long)r.index, r.boot, (unsigned long)f->seq,
           (unsigned long)f->t_ms, (unsigned int)f->valid);
    PrintFixed(f->baro_pa, 2);
    printf(",");
    PrintFixed(f->baro_temp_c, 2);
    printf(",");
    PrintFixed(f->baro_rel_m, 2);
    for (int i = 0; i < 3; i++)
    {
      printf(",");
      PrintFixed(f->acc_g[i], 3);
    }
    for (int i = 0; i < 3; i++)
    {
      printf(",");
      PrintFixed(f->gyro_dps[i], 2);
    }
    printf(",");
    PrintFixed(f->out_temp_c, 2);
    printf(",%u,%u,", f->gps_fix, f->gps_sats);
    PrintFixed(f->gps_lat_e7 / 1e7, 7);
    printf(",");
    PrintFixed(f->gps_lon_e7 / 1e7, 7);
    printf(",");
    PrintFixed(f->gps_alt_m, 1);
    printf(",%u,%s,", r.reset_cause, f->state <= FS_LANDED ? FS_NAME[f->state] : "?");
    PrintFixed(f->alt_m, 1);
    printf(",");
    PrintFixed(f->vz_mps, 2);
    printf(",");
    PrintFixed(f->asl_m, 1);
    printf(",%u,%s,%u\r\n", (f->valid & FRAME_SIM) ? 1U : 0U,
           f->alt_src <= ALT_SRC_NONE ? ALT_SRC_NAME[f->alt_src] : "?", f->gps_model_fixes);
  }
  printf("LOGDUMP END records=%lu broken=%lu\r\n", (unsigned long)(log_next - bad), (unsigned long)bad);
}

/* Console command 'E' then 'Y': erase the whole chip for a fresh log (30-100 s). */
static void LogErase(void)
{
  printf("LOG: erase the whole flash? send Y within 5 s\r\n");
  uint8_t c = 0;
  for (int i = 0; i < 50 && c == 0; i++)
  {
    WatchdogFeed();
    if (HAL_UART_Receive(&hlpuart1, &c, 1, 100) != HAL_OK)
    {
      c = 0;
    }
  }
  if (c != 'Y' && c != 'y')
  {
    printf("LOG: erase cancelled\r\n");
    return;
  }
  uint32_t t0 = HAL_GetTick();
  while (FlashBusy() && HAL_GetTick() - t0 < 1000U)
  {
  }
  printf("LOG: erasing chip");
  FlashWriteEnable();
  uint8_t cmd = FLASH_CMD_CHIP_ERASE;
  FlashSelect();
  HAL_SPI_Transmit(&hspi1, &cmd, 1, 100);
  FlashDeselect();
  uint32_t start = HAL_GetTick();
  while (FlashBusy() && HAL_GetTick() - start < 200000U)
  {
    for (int i = 0; i < 10; i++)
    {
      WatchdogFeed();
      HAL_Delay(100);
    }
    printf(".");
  }
  printf(" done in %lu s\r\n", (unsigned long)((HAL_GetTick() - start) / 1000U));
  log_next = 0;
  log_erased_to = LOG_SLOTS;  /* whole chip is erased now */
  log_q_head = log_q_tail = 0;
  log_full = 0;
}

/* ---------------- GPS MAX-M10S (USART1, 9600 baud) ---------------- */

/* Interrupt: one byte arrived -> store it and ask for the next one. */
void HAL_UART_RxCpltCallback(UART_HandleTypeDef *huart)
{
  if (huart == &huart1)
  {
    uint16_t next = (uint16_t)((gps_rx_head + 1U) % GPS_RX_BUF_SIZE);
    if (next != gps_rx_tail)
    {
      gps_rx_buf[gps_rx_head] = gps_rx_byte;
      gps_rx_head = next;
    }
    else
    {
      gps_rx_overflow++;  /* main loop is too slow: byte lost */
    }
    gps_rx_total++;
    HAL_UART_Receive_IT(&huart1, &gps_rx_byte, 1);
  }
}

/* Noise or overrun stops HAL reception; restart it. */
void HAL_UART_ErrorCallback(UART_HandleTypeDef *huart)
{
  if (huart == &huart1)
  {
    HAL_UART_Receive_IT(&huart1, &gps_rx_byte, 1);
  }
}

static int HexDigit(char c)
{
  if (c >= '0' && c <= '9') return c - '0';
  if (c >= 'A' && c <= 'F') return c - 'A' + 10;
  return -1;
}

/* Split "a,b,,c" in place into fields; returns the number of fields. */
static int NmeaSplit(char *s, char *field[], int max)
{
  int n = 0;
  field[n++] = s;
  for (; *s != '\0' && n < max; s++)
  {
    if (*s == ',')
    {
      *s = '\0';
      field[n++] = s + 1;
    }
  }
  return n;
}

/* NMEA "ddmm.mmmm" + hemisphere -> signed decimal degrees. */
static double NmeaToDegrees(const char *value, const char *hemi)
{
  double raw = atof(value);
  int deg = (int)(raw / 100.0);
  double d = deg + (raw - deg * 100.0) / 60.0;
  return (hemi[0] == 'S' || hemi[0] == 'W') ? -d : d;
}

/* One full sentence like "$GNGGA,...*5C" without the line ending. */
static void NmeaHandle(char *line)
{
  /* Checksum = XOR of all chars between '$' and '*', written as 2 hex digits. */
  char *star = strchr(line, '*');
  if (line[0] != '$' || star == NULL || HexDigit(star[1]) < 0 || HexDigit(star[2]) < 0)
  {
    nmea_bad++;
    return;
  }
  uint8_t sum = 0;
  for (char *p = line + 1; p < star; p++)
  {
    sum ^= (uint8_t)*p;
  }
  if (sum != (uint8_t)(HexDigit(star[1]) << 4 | HexDigit(star[2])))
  {
    nmea_bad++;
    return;
  }
  nmea_ok++;
#if GPS_ECHO_NMEA
  printf("%s\r\n", line);
#endif
  *star = '\0';

  char *f[24];
  int n = NmeaSplit(line + 1, f, 24);  /* f[0] = "GNGGA": 2-letter talker + type */
  if (strlen(f[0]) != 5)
  {
    return;
  }
  const char *type = f[0] + 2;

  if (strcmp(type, "GGA") == 0 && n >= 10)
  {
    /* 1 UTC time, 2 lat, 3 N/S, 4 lon, 5 E/W, 6 fix quality, 7 sats used, 8 HDOP, 9 altitude */
    gps_last_gga_ms = HAL_GetTick();
    strncpy(gps.utc, f[1], 6);
    gps.utc[6] = '\0';
    gps.fix_quality = atoi(f[6]);
    gps.sats_used = atoi(f[7]);
    if (gps.fix_quality > 0)
    {
      gps.lat_deg = NmeaToDegrees(f[2], f[3]);
      gps.lon_deg = NmeaToDegrees(f[4], f[5]);
      gps.alt_m = atof(f[9]);
    }
  }
  else if (strcmp(type, "GSV") == 0 && n >= 4)
  {
    /* 1 number of messages, 2 this message number, 3 satellites in view */
    const char *t = strchr(GPS_TALKERS, f[0][1]);
    if (t != NULL && atoi(f[2]) == 1)
    {
      gsv_in_view[t - GPS_TALKERS] = atoi(f[3]);
    }
  }
}

/* Feed one received byte: text goes to NMEA, 0xB5 0x62 ... frames go to UBX. */
static void GpsProcessByte(uint8_t b)
{
  static char line[GPS_LINE_MAX];
  static uint16_t line_len;
  static UbxFrame f;
  static uint8_t state, ck_a, ck_b;
  static uint16_t idx;

  switch (state)
  {
    case 0:  /* outside UBX: collect NMEA text */
      if (b == 0xB5U)
      {
        state = 1;
      }
      else if (b == '$')
      {
        line[0] = '$';
        line_len = 1;
      }
      else if (b == '\n' || b == '\r')
      {
        if (line_len > 0)
        {
          line[line_len] = '\0';
          NmeaHandle(line);
          line_len = 0;
        }
      }
      else if (line_len > 0 && line_len < GPS_LINE_MAX - 1U)
      {
        line[line_len++] = (char)b;
      }
      break;
    case 1: state = (b == 0x62U) ? 2 : 0; break;              /* second sync byte */
    case 2: f.cls = b; ck_a = b; ck_b = ck_a; state = 3; break;
    case 3: f.id = b; ck_a += b; ck_b += ck_a; state = 4; break;
    case 4: f.len = b; ck_a += b; ck_b += ck_a; state = 5; break;
    case 5:
      f.len |= (uint16_t)b << 8;
      ck_a += b; ck_b += ck_a;
      idx = 0;
      state = (f.len > sizeof(f.payload)) ? 0 : (f.len ? 6 : 7);
      break;
    case 6:
      f.payload[idx++] = b;
      ck_a += b; ck_b += ck_a;
      if (idx == f.len) state = 7;
      break;
    case 7: state = (b == ck_a) ? 8 : 0; break;               /* checksum A */
    case 8:                                                    /* checksum B */
      if (b == ck_b)
      {
        f.ready = 1;
        ubx = f;
        if (f.cls == UBX_CLASS_CFG && f.id == UBX_ID_VALGET && f.len >= 9 &&
            f.payload[4] == (uint8_t)CFG_NAVSPG_DYNMODEL &&
            f.payload[5] == (uint8_t)(CFG_NAVSPG_DYNMODEL >> 8) &&
            f.payload[6] == (uint8_t)(CFG_NAVSPG_DYNMODEL >> 16) &&
            f.payload[7] == (uint8_t)(CFG_NAVSPG_DYNMODEL >> 24))
        {
          gps_model_answer = f.payload[8];
        }
      }
      state = 0;
      break;
  }
}

/* Drain everything the interrupt has collected so far. */
static void GpsPoll(void)
{
  while (gps_rx_tail != gps_rx_head)
  {
    uint8_t b = gps_rx_buf[gps_rx_tail];
    gps_rx_tail = (uint16_t)((gps_rx_tail + 1U) % GPS_RX_BUF_SIZE);
    GpsProcessByte(b);
  }
}

/* UBX frame: B5 62 class id len(2, LSB first) payload ck_a ck_b (Fletcher checksum). */
static void UbxSend(uint8_t cls, uint8_t id, const uint8_t *payload, uint16_t len)
{
  uint8_t hdr[6] = {0xB5U, 0x62U, cls, id, (uint8_t)len, (uint8_t)(len >> 8)};
  uint8_t ck[2] = {0, 0};
  for (int i = 2; i < 6; i++)
  {
    ck[0] += hdr[i];
    ck[1] += ck[0];
  }
  for (uint16_t i = 0; i < len; i++)
  {
    ck[0] += payload[i];
    ck[1] += ck[0];
  }
  ubx.ready = 0;
  HAL_UART_Transmit(&huart1, hdr, sizeof(hdr), 100);
  HAL_UART_Transmit(&huart1, (uint8_t *)payload, len, 100);
  HAL_UART_Transmit(&huart1, ck, sizeof(ck), 100);
}

/* Send a request and wait for the answer.
   Returns 1 on data (want_data) or ACK, 0 on NAK, -1 on timeout. */
static int UbxRequest(uint8_t cls, uint8_t id, const uint8_t *payload, uint16_t len, int want_data)
{
  UbxSend(cls, id, payload, len);
  uint32_t start = HAL_GetTick();
  while (HAL_GetTick() - start < 1000U)
  {
    GpsPoll();
    if (!ubx.ready)
    {
      continue;
    }
    ubx.ready = 0;
    if (want_data && ubx.cls == cls && ubx.id == id)
    {
      return 1;
    }
    if (ubx.cls == UBX_CLASS_ACK && ubx.len >= 2 && ubx.payload[0] == cls && ubx.payload[1] == id)
    {
      if (ubx.id == UBX_ID_NAK) return 0;
      if (!want_data) return 1;
    }
  }
  return -1;
}

/* Read the dynamic model from a layer: 0 = RAM (active), 1 = BBR (kept by backup cell).
   Returns the value, -2 if the layer holds no value (NAK), -1 on timeout. */
static int GpsGetDynModel(uint8_t layer)
{
  uint8_t p[8] = {0x00, layer, 0x00, 0x00,
                  (uint8_t)CFG_NAVSPG_DYNMODEL, (uint8_t)(CFG_NAVSPG_DYNMODEL >> 8),
                  (uint8_t)(CFG_NAVSPG_DYNMODEL >> 16), (uint8_t)(CFG_NAVSPG_DYNMODEL >> 24)};
  int r = UbxRequest(UBX_CLASS_CFG, UBX_ID_VALGET, p, sizeof(p), 1);
  if (r == 0) return -2;
  if (r < 0 || ubx.len < 9) return -1;
  return ubx.payload[8];  /* version, layer, position(2), key(4), value */
}

static const char *DynModelName(int m)
{
  switch (m)
  {
    case 0: return "portable";
    case 2: return "stationary";
    case 3: return "pedestrian";
    case 4: return "automotive";
    case 6: return "airborne<1g";
    case 7: return "airborne<2g";
    case 8: return "AIRBORNE<4g";
    case -1: return "no answer";
    case -2: return "not stored";
    default: return "other";
  }
}

/* Modules are sometimes pre-set to another speed: try common baud rates
   and keep the first one where NMEA checksums pass. Returns the baud or 0. */
static uint32_t GpsDetectBaud(void)
{
  static const uint32_t bauds[] = {9600, 38400, 115200, 57600, 19200, 4800};
  for (unsigned i = 0; i < sizeof(bauds) / sizeof(bauds[0]); i++)
  {
    HAL_UART_AbortReceive(&huart1);
    huart1.Init.BaudRate = bauds[i];
    HAL_UART_Init(&huart1);
    gps_rx_tail = gps_rx_head;  /* drop bytes received at the old speed */
    gps_rx_total = 0;
    nmea_ok = 0;
    nmea_bad = 0;
    HAL_UART_Receive_IT(&huart1, &gps_rx_byte, 1);

    uint32_t start = HAL_GetTick();
    while (nmea_ok < 2 && HAL_GetTick() - start < 1500U)
    {
      GpsPoll();
    }
    printf("GPS baud %6lu: bytes=%lu nmea ok=%lu bad=%lu\r\n", (unsigned long)bauds[i],
           (unsigned long)gps_rx_total, (unsigned long)nmea_ok, (unsigned long)nmea_bad);
    if (nmea_ok >= 2)
    {
      return bauds[i];
    }
  }
  return 0;
}

static void GpsInit(void)
{
  /* 1. Is the module talking, and at what speed? */
  uint32_t baud = GpsDetectBaud();
  if (baud == 0)
  {
    printf("GPS: no valid NMEA at any speed. Check GPS TX -> D0, GND, power\r\n");
    return;
  }
  printf("GPS: NMEA OK at %lu baud\r\n", (unsigned long)baud);
  boot_gps_talks = 1;

  /* 2. What model did the module wake up with? 8 here after a power cycle = setting survived. */
  int ram = GpsGetDynModel(0);
  int bbr = GpsGetDynModel(1);
  gps_boot_dynmodel = ram;
  printf("GPS dynModel at boot: RAM=%d (%s), BBR=%d (%s)\r\n",
         ram, DynModelName(ram), bbr, DynModelName(bbr));

  /* 3. Set Airborne <4g in RAM (now) and BBR (after power-off, if the backup cell holds). */
  uint8_t p[9] = {0x00, UBX_LAYER_RAM | UBX_LAYER_BBR, 0x00, 0x00,
                  (uint8_t)CFG_NAVSPG_DYNMODEL, (uint8_t)(CFG_NAVSPG_DYNMODEL >> 8),
                  (uint8_t)(CFG_NAVSPG_DYNMODEL >> 16), (uint8_t)(CFG_NAVSPG_DYNMODEL >> 24),
                  DYNMODEL_AIRBORNE_4G};
  int r = UbxRequest(UBX_CLASS_CFG, UBX_ID_VALSET, p, sizeof(p), 0);
  printf("GPS set Airborne<4g: %s\r\n", r == 1 ? "ACK" : (r == 0 ? "NAK" : "no answer"));

  /* 4. Read back to be sure. */
  ram = GpsGetDynModel(0);
  printf("GPS dynModel now: RAM=%d (%s)\r\n", ram, DynModelName(ram));
  boot_gps_airborne = ram == (int)DYNMODEL_AIRBORNE_4G;
}

/* Copy the latest parsed GPS data into the frame (GPS itself updates once per second). */
static void GpsFillFrame(TelemetryFrame *f)
{
  int in_view = 0;
  for (unsigned i = 0; i < sizeof(gsv_in_view) / sizeof(gsv_in_view[0]); i++)
  {
    in_view += gsv_in_view[i];
  }
  if (gps_last_gga_ms == 0 || HAL_GetTick() - gps_last_gga_ms > GPS_STALE_MS)
  {
    /* GPS went silent: do not pass old coordinates off as new ones. */
    f->gps_fix = 0;
    f->gps_sats = 0;
    f->gps_in_view = 0;
    return;
  }
  f->valid |= FRAME_OK_GPSLINK;
  f->gps_fix = (uint8_t)gps.fix_quality;
  f->gps_sats = (uint8_t)gps.sats_used;
  f->gps_in_view = (uint8_t)in_view;
  if (gps.fix_quality > 0)
  {
    f->valid |= FRAME_OK_GPSFIX;
    f->gps_lat_e7 = (int32_t)lround(gps.lat_deg * 1e7);
    f->gps_lon_e7 = (int32_t)lround(gps.lon_deg * 1e7);
    f->gps_alt_m = (float)gps.alt_m;
  }
}

/* Called as often as possible from the main loop: asks the GPS for its model once a
   minute and puts Airborne <4g back if it is gone. Never waits for the GPS. */
static void GpsModelService(void)
{
  if (!boot_gps_talks)
  {
    return;
  }
  uint32_t now = HAL_GetTick();
  if (gps_model_waiting)
  {
    int m = gps_model_answer;
    if (m >= 0)
    {
      gps_model_waiting = 0;
      if (m != (int)DYNMODEL_AIRBORNE_4G)
      {
        uint8_t p[9] = {0x00, UBX_LAYER_RAM | UBX_LAYER_BBR, 0x00, 0x00,
                        (uint8_t)CFG_NAVSPG_DYNMODEL, (uint8_t)(CFG_NAVSPG_DYNMODEL >> 8),
                        (uint8_t)(CFG_NAVSPG_DYNMODEL >> 16), (uint8_t)(CFG_NAVSPG_DYNMODEL >> 24),
                        DYNMODEL_AIRBORNE_4G};
        UbxSend(UBX_CLASS_CFG, UBX_ID_VALSET, p, sizeof(p));
        if (gps_model_fixes < 255U)
        {
          gps_model_fixes++;
        }
        printf("GPS: model was %d (%s), set back to AIRBORNE<4g (%u times so far)\r\n", m,
               DynModelName(m), gps_model_fixes);
        gps_model_next_ms = now + 2000U;  /* and check again soon that it took */
      }
    }
    else if (now - gps_model_asked_ms > 2000U)
    {
      gps_model_waiting = 0;
      printf("GPS: no answer to the model check\r\n");
    }
    return;
  }
  if ((int32_t)(now - gps_model_next_ms) >= 0)
  {
    uint8_t p[8] = {0x00, 0x00 /* RAM: the active value */, 0x00, 0x00,
                    (uint8_t)CFG_NAVSPG_DYNMODEL, (uint8_t)(CFG_NAVSPG_DYNMODEL >> 8),
                    (uint8_t)(CFG_NAVSPG_DYNMODEL >> 16), (uint8_t)(CFG_NAVSPG_DYNMODEL >> 24)};
    gps_model_answer = -1;
    UbxSend(UBX_CLASS_CFG, UBX_ID_VALGET, p, sizeof(p));
    gps_model_waiting = 1;
    gps_model_asked_ms = now;
    gps_model_next_ms = now + GPS_MODEL_CHECK_MS;
  }
}

/* ---------------- The frame: one line per frame on the console ---------------- */

static void FramePrint(const TelemetryFrame *f)
{
  printf("FRM seq=%lu t=%lu | BARO p=", (unsigned long)f->seq, (unsigned long)f->t_ms);
  PrintFixed(f->baro_pa, 2);
  printf(" T=");
  PrintFixed(f->baro_temp_c, 2);
  printf(" rel=");
  PrintFixed(f->baro_rel_m, 2);
  printf(" | IMU a=");
  PrintFixed(f->acc_g[0], 2);
  printf(",");
  PrintFixed(f->acc_g[1], 2);
  printf(",");
  PrintFixed(f->acc_g[2], 2);
  printf(" g=");
  PrintFixed(f->gyro_dps[0], 1);
  printf(",");
  PrintFixed(f->gyro_dps[1], 1);
  printf(",");
  PrintFixed(f->gyro_dps[2], 1);
  printf(" | GPS fix=%u sats=%u view=%u alt=", f->gps_fix, f->gps_sats, f->gps_in_view);
  PrintFixed(f->gps_alt_m, 1);
  printf(" | OUT T=");
  PrintFixed(f->out_temp_c, 2);
  printf(" | work=%lu valid=0x%02X model@boot=%d", (unsigned long)f->work_us,
         (unsigned int)f->valid, gps_boot_dynmodel);
  printf(" | FLT st=%s h=", f->state <= FS_LANDED ? FS_NAME[f->state] : "?");
  PrintFixed(f->alt_m, 1);
  printf(" vz=");
  PrintFixed(f->vz_mps, 1);
  printf(" asl=");
  PrintFixed(f->asl_m, 1);
  printf(" src=%s%s hsrc=%s\r\n", f->asl_src == ASL_GPS ? "GPS" : f->asl_src == ASL_QNH ? "QNH" : "STD",
         (f->valid & FRAME_SIM) ? " SIM" : "", f->alt_src <= ALT_SRC_NONE ? ALT_SRC_NAME[f->alt_src] : "?");
}

/* ---------------- Flight state machine (HW-18) ---------------- */

static void BuzzerInit(void)
{
  __HAL_RCC_GPIOB_CLK_ENABLE();
  GPIO_InitTypeDef g = {0};
  g.Pin = GPIO_PIN_4;  /* PB4 = D5 on the Nucleo; FET gate of the buzzer on the flight board */
  g.Mode = GPIO_MODE_OUTPUT_PP;
  g.Pull = GPIO_NOPULL;
  g.Speed = GPIO_SPEED_FREQ_LOW;
  HAL_GPIO_Init(GPIOB, &g);
  HAL_GPIO_WritePin(GPIOB, GPIO_PIN_4, GPIO_PIN_RESET);
}

static void BuzzerSet(int on)
{
  HAL_GPIO_WritePin(GPIOB, GPIO_PIN_4, on ? GPIO_PIN_SET : GPIO_PIN_RESET);
}

/* LED "alive": PB0 = A3 on the Nucleo, LED_ALIVE on the flight board. Normally one short
   blink a second. Before the launch with too little room in the black box for a flight it
   blinks 10 times a second: erase the log (E, then Y) before launching. A flight with the
   time on the pad needs about 4 h; the warning starts below 5 h of room (31 % used). */
#define LED_PORT         GPIOB
#define LED_PIN          GPIO_PIN_0
#define LOG_WARN_MIN     300U
#define LOG_WARN_SLOTS   (LOG_WARN_MIN * 60U * 5U)

static int LogRoomLow(void)
{
  return log_full || LOG_SLOTS - log_next < LOG_WARN_SLOTS;
}

static void LedInit(void)
{
  __HAL_RCC_GPIOB_CLK_ENABLE();
  GPIO_InitTypeDef g = {0};
  g.Pin = LED_PIN;
  g.Mode = GPIO_MODE_OUTPUT_PP;
  g.Pull = GPIO_NOPULL;
  g.Speed = GPIO_SPEED_FREQ_LOW;
  HAL_GPIO_Init(LED_PORT, &g);
  HAL_GPIO_WritePin(LED_PORT, LED_PIN, GPIO_PIN_RESET);
}

/* Called as often as possible from the main loop. */
static void LedService(void)
{
  uint32_t t = HAL_GetTick();
  int on = (fsm.state == FS_PRELAUNCH && LogRoomLow()) ? (int)((t / 50U) % 2U) : (t % 1000U) < 50U;
  HAL_GPIO_WritePin(LED_PORT, LED_PIN, on ? GPIO_PIN_SET : GPIO_PIN_RESET);
}

/* 'S' simulation: a real flight profile (5 m/s up, burst at 30 km, parachute down)
   played SIM_SPEED times faster, with +-0.5 m of noise. The 20 s around the burst run
   at real speed, so burst detection is tested on a real fall speed. */
static double SimAltitude(uint32_t now_ms)
{
  const double pre_s = 400.0, burst_m = 30000.0, scale_m = 14600.0;
  const double w_st = pre_s + burst_m / 5.0 - 5.0;  /* flight time 5 s before the burst */
  const double w_r = w_st / SIM_SPEED;              /* ... reached at this real time */
  double r = (now_ms - sim_start_ms) / 1000.0;
  double st = r < w_r ? r * SIM_SPEED
            : r < w_r + 20.0 ? w_st + (r - w_r)
            : w_st + 20.0 + (r - w_r - 20.0) * SIM_SPEED;
  double h;
  if (st < pre_s)
  {
    h = 0.0;
  }
  else if (st < pre_s + burst_m / 5.0)
  {
    h = (st - pre_s) * 5.0;
  }
  else
  {
    /* descent speed 5 m/s * exp(h / 14.6 km): solved in closed form */
    double e = exp(-burst_m / scale_m) + 5.0 * (st - pre_s - burst_m / 5.0) / scale_m;
    h = e >= 1.0 ? 0.0 : -scale_m * log(e);
  }
  sim_rng = sim_rng * 1103515245U + 12345U;
  return h + (((sim_rng >> 16) & 0xFFU) / 255.0 - 0.5);
}

/* 'S' simulation (HW-15): a barometer and a GPS reading made from SimAltitude, so the
   barometer/GPS mix is exercised on the bench. The barometer reads the standard
   atmosphere and stops at 300 hPa like the BMP390; the GPS sees a weather difference that
   grows by 4 m per km, +-3 m of noise, and gives a sample every frame (the profile runs
   40x faster than real, one sample a second would be one per 200 m). */
static void SimInput(uint32_t now_ms, AltInput *in)
{
  double h = SimAltitude(now_ms);
  double launch_isa = IsaAltitude(ground_pa > 0.0 ? ground_pa : 101325.0);
  double p = IsaPressure(launch_isa + h);
  if (p < 30000.0)
  {
    p = 30000.0;
  }
  sim_rng = sim_rng * 1103515245U + 12345U;
  in->baro_ok = 1;
  in->press_pa = p;
  in->baro_asl_m = IsaAltitude(p) + asl_offset;
  in->gps_ok = 1;
  in->gps_sats = 12;
  in->gps_asl_m = launch_isa + asl_offset + h * 1.004 + (((sim_rng >> 16) & 0xFFU) / 255.0 - 0.5) * 6.0;
  in->gps_ms = now_ms;
}

/* Altitudes for this frame and one step of the state machine. */
static void FlightUpdate(TelemetryFrame *f, double press_pa, int baro_ok)
{
  int gps_ok = (f->valid & FRAME_OK_GPSFIX) != 0;
  if (baro_ok && ground_pa > 0.0)
  {
    /* Before launch the sea-level reference follows the GPS (it has no weather error). */
    if (fsm.state == FS_PRELAUNCH && !sim_active && gps_ok && f->gps_sats >= 6U)
    {
      double target = f->gps_alt_m - IsaAltitude(press_pa);
      if (asl_src != ASL_GPS)
      {
        asl_offset = target;
        asl_src = ASL_GPS;
        printf("ALT: sea level now calibrated by GPS (%u satellites)\r\n", f->gps_sats);
      }
      else
      {
        asl_offset += 0.02 * (target - asl_offset);  /* ~10 s average */
      }
    }
  }

  /* Barometer below ~7 km, GPS above ~9 km, a smooth mix in between (altitude_fuse.h).
     The weather difference between them is learned only in a real flight: not before the
     launch (the calibration above does that) and not in the lift test (GPS indoors). */
  AltInput in = {0};
  if (sim_active)
  {
    SimInput(f->t_ms, &in);
    f->valid |= FRAME_SIM;
  }
  else
  {
    in.baro_ok = baro_ok && ground_pa > 0.0;
    in.press_pa = press_pa;
    in.baro_asl_m = IsaAltitude(press_pa) + asl_offset;
    in.gps_ok = gps_ok;
    in.gps_sats = f->gps_sats;
    in.gps_asl_m = f->gps_alt_m;
    in.gps_ms = gps_last_gga_ms;
  }
  if (test_mode)
  {
    f->valid |= FRAME_TEST;
  }
  int learn = fsm.state != FS_PRELAUNCH && !test_mode;
  int alt_ok = AltFuseUpdate(&afuse, f->t_ms, &in, learn) && (ground_pa > 0.0 || sim_active);
  double launch_asl = IsaAltitude(ground_pa > 0.0 ? ground_pa : 101325.0) + asl_offset;
  double alt = afuse.asl_m - launch_asl;
  f->asl_m = (float)afuse.asl_m;
  f->alt_src = afuse.src;
  f->gps_model_fixes = gps_model_fixes;

  FlightState before = fsm.state;
  if (FlightSmUpdate(&fsm, f->t_ms, (float)alt, alt_ok))
  {
    printf("STATE: %s -> %s  h=", FS_NAME[before], FS_NAME[fsm.state]);
    PrintFixed(fsm.alt, 1);
    printf(" m  vz=");
    PrintFixed(fsm.vz, 1);
    printf(" m/s  max=");
    PrintFixed(fsm.max_alt, 1);
    printf(" m%s\r\n", sim_active ? "  (SIM)" : "");
  }
  f->alt_m = fsm.alt;
  f->vz_mps = fsm.vz;
  f->state = (uint8_t)fsm.state;
  f->asl_src = asl_src;
}

/* At boot: if the log says we were flying and this was not a normal start, continue the
   flight instead of calling the current altitude "ground". */
static void FlightResume(int bmp_ok)
{
  FlightSmInit(&fsm, HAL_GetTick());
  if (!log_last_ok || (log_last.frame.valid & FRAME_SIM) ||
      log_last.frame.state < FS_ASCENT || log_last.frame.state > FS_LANDED)
  {
    return;
  }
  int unplanned = (reset_cause == RESET_WATCHDOG || reset_cause == RESET_SOFTWARE ||
                   reset_cause == RESET_BROWNOUT) && !reset_by_programmer;
  int in_air = bmp_ok && ground_pa > 0.0 && ground_pa < log_last.ground_pa - 1000.0;  /* ~90 m up */
  if (!unplanned && !in_air)
  {
    printf("FLIGHT: log ended in %s, but this is a normal start%s: new flight from PRELAUNCH\r\n",
           FS_NAME[log_last.frame.state], reset_by_programmer ? " (programmer)" : "");
    return;  /* power-on, reset button or the programmer, on the ground: a new start */
  }
  ground_pa = log_last.ground_pa;
  asl_offset = log_last.asl_offset;
  asl_src = log_last.frame.asl_src;
  FlightSmResume(&fsm, HAL_GetTick(), (FlightState)log_last.frame.state, log_last.max_alt);
  afuse.bias_m = log_last.alt_bias_dm / 10.0;
  if (log_last.frame.valid & FRAME_TEST)
  {
    test_mode = 1;
    fsm.scale = TEST_SCALE;
    fsm.landed_max = TEST_LANDED_MAX;
    printf("FLIGHT: (lift test mode)\r\n");
  }
  printf("FLIGHT: resumed %s after a %s reset, launch pressure ", FS_NAME[fsm.state],
         ResetCauseName(reset_cause));
  PrintFixed2(ground_pa);
  printf(" Pa, max altitude ");
  PrintFixed(fsm.max_alt, 0);
  printf(" m\r\n");
}
/* ---------------- Radio telemetry (HW-13) ----------------
   Every RADIO_EVERY_N frames the latest frame goes out as one 28-byte packet. The loop
   does not wait for the radio: the packet is started in one frame and checked in the next
   ones. Flight power is the Thai licence-exempt limit (10 mW e.i.r.p., HW-166); the bench
   build stays at the lowest power.
   Bench build: off after power-up, command 'A' turns it on (antenna!). Flight build: on. */
#define RADIO_EVERY_N  25U     /* one packet every 5 s */
#ifdef HAB_FLIGHT_BOARD
#define RADIO_TX_DBM   LORA_TX_DBM_FLIGHT
#else
#define RADIO_TX_DBM   LORA_TX_DBM_BENCH
#endif
#define RADIO_PAYLOAD_ID 1U

static uint8_t radio_auto;     /* periodic transmit is on */
static uint8_t radio_ready;    /* the radio is set up */
static uint8_t radio_busy;     /* a packet is on the air */
static uint16_t radio_seq;
static uint32_t radio_sent, radio_failed;

static void RadioPacket(const TelemetryFrame *f, uint8_t pkt[TP_SIZE])
{
  Telemetry tm = {0};
  tm.payload_id = RADIO_PAYLOAD_ID;
  tm.seq = radio_seq++;
  tm.uptime_s = HAL_GetTick() / 1000U;
  tm.state = f->state;
  tm.flags = (uint8_t)(((f->valid & FRAME_OK_BARO) ? TP_FLAG_BARO_OK : 0) |
                       ((f->valid & FRAME_OK_GPSFIX) ? TP_FLAG_GPS_FIX : 0) |
                       ((f->valid & FRAME_OK_OUT) ? TP_FLAG_OUT_OK : 0) |
                       (log_full ? 0 : TP_FLAG_LOG_OK));
  tm.gps_sats = f->gps_sats;
  tm.lat_e7 = f->gps_lat_e7;
  tm.lon_e7 = f->gps_lon_e7;
  tm.gps_alt_m = f->gps_alt_m;
  tm.alt_m = f->alt_m;
  tm.vz_mps = f->vz_mps;
  tm.out_temp_c = f->out_temp_c;
  tm.board_temp_c = f->baro_temp_c;
  tm.alt_src = f->alt_src;
  TelemetryEncode(&tm, pkt);
}

/* Called once per frame */
static void RadioTick(const TelemetryFrame *f)
{
  if (radio_busy)
  {
    int r = LoraSendPoll();
    if (r == 0)
    {
      return;
    }
    radio_busy = 0;
    if (r == 1)
    {
      radio_sent++;
      if (radio_sent % 12U == 1U)   /* once a minute, not every packet */
      {
        printf("LORA: auto: %lu sent, %lu failed, last one took %lu ms\r\n", (unsigned long)radio_sent,
               (unsigned long)radio_failed, (unsigned long)lora_tx_ms);
      }
    }
    else
    {
      radio_failed++;
      radio_ready = 0;              /* set the radio up again before the next packet */
      printf("LORA: auto: packet NOT sent (irq 0x%04X, chip errors 0x%04X), %lu failed so far\r\n",
             lora_tx_irq, lora_tx_err, (unsigned long)radio_failed);
    }
    return;
  }
  if (!radio_auto)
  {
    return;
  }
  if (!radio_ready)
  {
    /* The setup takes about 0.3 s, so it gets a frame of its own, 1 s before a packet is due */
    if (f->seq % RADIO_EVERY_N == RADIO_EVERY_N - 5U)
    {
      uint16_t err = LoraRadioSetup(RADIO_TX_DBM);
      radio_ready = err == 0U;
      if (!radio_ready)
      {
        radio_failed++;
        printf("LORA: auto: radio setup failed, chip errors 0x%04X\r\n", err);
      }
    }
    return;
  }
  if (f->seq % RADIO_EVERY_N == 0U)
  {
    uint8_t pkt[TP_SIZE];
    RadioPacket(f, pkt);
    radio_busy = LoraSendStart(pkt, TP_SIZE) != 0;
  }
}

/* ---------------- Bench OLED (HW-142) ----------------
   A small screen on the barometer's I2C wires, for photos and video on the ground. At
   power-on it lists the real results of the start-up checks, then it turns the pages:
   flight, satellites, radio and health, a running line. The blue button turns the page
   by hand and holds it; one more press after the last page gives the turning back.
   Not plugged in = nothing happens. The flight build never looks for it. */
#define OLED_FRAME_BYTES   400U  /* picture bytes sent per frame: about 40 ms of the 200 ms */
#define OLED_VERDICT_FRAMES 15U  /* READY / NOT READY stays for 3 s */
#define OLED_HIST_EVERY_N  2U    /* graph: one point per 0.4 s, 51 s across the screen */
#ifdef HAB_FLIGHT_BOARD
#define OLED_ALLOWED       0     /* the flight board has no screen: never look for one */
#else
#define OLED_ALLOWED       1
#endif
enum { DISP_FLIGHT, DISP_GPS, DISP_SYSTEM, DISP_TICKER, DISP_PAGES };
static const uint8_t DISP_FRAMES[DISP_PAGES] = {25, 25, 25, 54};  /* 5 s each, the line once round */
static const char *const DISP_NAME[DISP_PAGES] = {"flight", "satellites", "radio and health", "running line"};

static OledView disp;
static uint8_t disp_page, disp_hold;
static uint32_t disp_page_frames;
static volatile uint8_t disp_button;

/* Blue button of the NUCLEO, from its interrupt */
void BSP_PB_Callback(Button_TypeDef Button)
{
  (void)Button;
  disp_button = 1;
}

static void DisplayBoot(void)
{
  if (OLED_ALLOWED && OledInit())
  {
    printf("OLED: screen found at 0x3C\r\n");
  }
  disp.probe_id = RADIO_PAYLOAD_ID;
  disp.boot = boot_id;
  OledDrawSplash(&disp);
  OledFlush(sizeof(oled_fb));
}

/* One line of the power-on list: the result of a check that has just been run. */
static void DisplayCheck(int which, int ok, const char *note)
{
  disp.boot = boot_id;
  disp.chk[which] = ok ? OLED_PASS : OLED_FAIL;
  snprintf(disp.chk_note[which], sizeof(disp.chk_note[which]), "%s", note);
  if (!oled_ok)
  {
    return;
  }
  OledDrawSplash(&disp);
  OledFlush(sizeof(oled_fb));
  HAL_Delay(200);  /* the real checks are faster than the eye: give each line a moment */
}

/* Called once per frame, after everything else in the frame is done. */
static void DisplayTick(const TelemetryFrame *f)
{
  static uint32_t last_press_ms;
  if (f->seq % OLED_HIST_EVERY_N == 0U)
  {
    OledHistPush(f->alt_m);
  }
  if (disp_button)
  {
    disp_button = 0;
    if (HAL_GetTick() - last_press_ms > 300U && f->seq > OLED_VERDICT_FRAMES)
    {
      last_press_ms = HAL_GetTick();
      if (disp_hold && disp_page == DISP_PAGES - 1)
      {
        disp_hold = 0;
        disp_page = 0;
      }
      else
      {
        disp_page = (uint8_t)(disp_hold ? disp_page + 1 : (disp_page + 1) % DISP_PAGES);
        disp_hold = 1;
      }
      disp_page_frames = 0;
      printf("OLED: page \"%s\", %s\r\n", DISP_NAME[disp_page], disp_hold ? "held" : "pages turn by themselves");
    }
  }
  if (!oled_ok)
  {
    /* plugged in later, or pulled out and put back: look for it every 5 s */
    if (OLED_ALLOWED && f->seq % RETRY_EVERY_N == 0U && OledInit())
    {
      printf("OLED: screen found at 0x3C\r\n");
    }
    if (!oled_ok)
    {
      return;
    }
  }

  disp.state = FS_NAME[f->state];
  disp.mode = sim_active ? "SIM" : (test_mode ? "LIFT" : NULL);
  disp.alt_m = f->alt_m;
  disp.alt_src = f->alt_src <= ALT_SRC_NONE ? ALT_SRC_NAME[f->alt_src] : NULL;
  disp.vz_mps = f->vz_mps;
  disp.gps_link = (f->valid & FRAME_OK_GPSLINK) != 0;
  disp.gps_fix = (f->valid & FRAME_OK_GPSFIX) != 0;
  disp.gps_airborne = boot_gps_airborne;
  disp.sats_used = f->gps_sats;
  disp.sats_seen = f->gps_in_view;
  for (int i = 0; i < 4; i++)  /* GPS_TALKERS order: GPS, GLONASS, Galileo, BeiDou */
  {
    disp.seen[i] = (uint8_t)gsv_in_view[i];
  }
  memcpy(disp.utc, disp.gps_link ? gps.utc : "", sizeof(disp.utc));
  disp.radio_on = radio_auto;
  disp.tx_dbm = RADIO_TX_DBM;
  disp.freq_khz = LORA_FREQ_HZ / 1000UL;
  disp.sent = radio_sent;
  disp.failed = radio_failed;
  disp.board_temp_ok = (f->valid & FRAME_OK_BARO) != 0;
  disp.out_temp_ok = (f->valid & FRAME_OK_OUT) != 0;
  disp.board_temp_c = f->baro_temp_c;
  disp.out_temp_c = f->out_temp_c;
  disp.sensors_all = 5;
  disp.sensors_ok = (uint8_t)(((f->valid & FRAME_OK_BARO) != 0) + ((f->valid & FRAME_OK_IMU) != 0) +
                              ((f->valid & FRAME_OK_OUT) != 0) + ((f->valid & FRAME_OK_GPSLINK) != 0) +
                              (log_full ? 0 : 1));
  disp.log_free_pct = (uint8_t)((uint64_t)(LOG_SLOTS - log_next) * 100U / LOG_SLOTS);
  disp.log_min_left = (LOG_SLOTS - log_next) / 5U / 60U;
  disp.uptime_s = HAL_GetTick() / 1000U;

  if (f->seq <= OLED_VERDICT_FRAMES)
  {
    OledDrawVerdict(&disp);
  }
  else
  {
    if (!disp_hold && disp_page_frames >= DISP_FRAMES[disp_page])
    {
      disp_page = (uint8_t)((disp_page + 1) % DISP_PAGES);
      disp_page_frames = 0;
    }
    switch (disp_page)
    {
      case DISP_FLIGHT: OledDrawFlight(&disp); break;
      case DISP_GPS:    OledDrawGps(&disp); break;
      case DISP_SYSTEM: OledDrawSystem(&disp); break;
      default:          OledDrawTicker(&disp, disp_page_frames); break;
    }
    disp_page_frames++;
  }
  OledFlush(OLED_FRAME_BYTES);
}

#ifdef HAB_GROUND_STATION
/* Ground receiver (HW-29), cmake preset "Ground": the same board and the same radio wiring,
   but it only listens. Every packet goes to the laptop as one text line; the decoding is
   done there (tools/ground_station.py), so a new packet format needs no new firmware here.
   NOTHING IS EVER TRANSMITTED in this build.

     RX t=<ms> len=<n> rssi=<dBm> snr=<dB> data=<hex>     a packet
     RXBAD t=<ms> rssi=<dBm> snr=<dB>                     a packet damaged on the air
     GS: alive t=<ms> rx=<n> bad=<n> noise=<dBm>          every 5 s: the link to the laptop lives */
static void GroundStationRun(void)
{
  uint32_t rx_count = 0, bad_count = 0;
  printf("\r\n=== HAB-1 ground receiver ===\r\n");
  WatchdogStart();
  for (;;)
  {
    WatchdogFeed();
    uint16_t err = LoraCheck() ? LoraRadioSetup(LORA_TX_DBM_BENCH) : 0xFFFFU;
    WatchdogFeed();
    if (err != 0U)
    {
      printf("GS: radio not ready (chip errors 0x%04X), next try in 1 s\r\n", err);
      HAL_Delay(1000);
      continue;
    }
    printf("GS: listening on %lu Hz SF%u BW125\r\n", (unsigned long)LORA_FREQ_HZ, LORA_SF);
    LoraRxStart();
    uint32_t alive_ms = HAL_GetTick();
    for (;;)
    {
      uint8_t pkt[64];
      int rssi = 0, snr = 0;
      WatchdogFeed();
      int n = LoraRxPoll(pkt, sizeof(pkt), &rssi, &snr);
      if (n > 0)
      {
        rx_count++;
        printf("RX t=%lu len=%d rssi=%d snr=%d data=", (unsigned long)HAL_GetTick(), n, rssi, snr);
        for (int i = 0; i < n; i++)
        {
          printf("%02X", pkt[i]);
        }
        printf("\r\n");
      }
      else if (n < 0)
      {
        bad_count++;
        printf("RXBAD t=%lu rssi=%d snr=%d\r\n", (unsigned long)HAL_GetTick(), rssi, snr);
      }
      if (HAL_GetTick() - alive_ms >= 5000U)
      {
        alive_ms = HAL_GetTick();
        /* the chip answers "receiving" (mode 5 in GetStatus); anything else: set it up again */
        const uint8_t tx[2] = {SX_GET_STATUS, 0};
        uint8_t rx[2] = {0};
        LoraWaitReady(50);
        LoraXfer(tx, rx, 2);
        if (((rx[1] >> 4) & 0x07U) != 5U)
        {
          printf("GS: radio left receive mode (status 0x%02X), restarting it\r\n", rx[1]);
          break;
        }
        printf("GS: alive t=%lu rx=%lu bad=%lu noise=%d\r\n", (unsigned long)alive_ms,
               (unsigned long)rx_count, (unsigned long)bad_count, LoraNoiseDbm());
      }
    }
  }
}
#endif /* HAB_GROUND_STATION */
/* USER CODE END 0 */

/**
  * @brief  The application entry point.
  * @retval int
  */
int main(void)
{

  /* MCU Configuration--------------------------------------------------------*/

  /* Reset of all peripherals, Initializes the Flash interface and the Systick. */
  HAL_Init();

  /* Configure the system clock */
  SystemClock_Config();

  /* Initialize all configured peripherals */
  MX_GPIO_Init();
  MX_LPUART1_UART_Init();
  MX_I2C1_Init();
  MX_SPI1_Init();
  MX_USART1_UART_Init();
  MX_SPI3_Init();
  /* USER CODE BEGIN 2 */
  setvbuf(stdout, NULL, _IONBF, 0);
#ifdef HAB_GROUND_STATION
  GroundStationRun();  /* never returns */
#endif
  /* The programmer (st-flash) sets "halt on reset" in the debug unit. That register
     survives every reset except power-off, so a watchdog reset would stop the core
     instead of restarting the program. Clear it: no programmer is attached in flight. */
  /* The same bit tells that this boot comes from the programmer: its reset looks like a
     software reset, but it must not "continue a flight" on the bench. */
  reset_by_programmer = (CoreDebug->DEMCR & CoreDebug_DEMCR_VC_CORERESET_Msk) != 0U;
  CoreDebug->DEMCR &= ~CoreDebug_DEMCR_VC_CORERESET_Msk;
  ResetCauseCapture();
  DelayUsInit();  /* cycle counter: microsecond delays and loop timing */
  FlashDeselect();
  ImuCsInit();
  BuzzerInit();
  LedInit();
#ifdef HAB_FLIGHT_BOARD
  radio_auto = 1;  /* nobody is there to switch it on in flight */
#endif
  HAL_Delay(100);
  printf("\r\n=== hab_bringup: BMP390 + SPI flash + GPS ===\r\n");
#if WIRING_DIAG
  FlashWiringCheck();
#endif

  DisplayBoot();
  FlashBootTest();
  printf("RESET cause: %s (boot %u)\r\n", ResetCauseName(reset_cause), boot_id);
  LogInit();
  if (LogRoomLow())
  {
    printf("LOG: WARNING - %lu min of room left, a flight needs %u. Erase before launch: E, then Y."
           " The LED blinks fast until then\r\n",
           (unsigned long)((LOG_SLOTS - log_next) / 5U / 60U), (unsigned)LOG_WARN_MIN);
  }
  char note[24];
  snprintf(note, sizeof(note), "%lu%% FREE", (unsigned long)((uint64_t)(LOG_SLOTS - log_next) * 100U / LOG_SLOTS));
  DisplayCheck(OLED_CHK_MEMORY, boot_flash_ok && !LogRoomLow(), boot_flash_ok ? note : "NO ANSWER");

  int imu_ok = ImuInit() == 0;
  FlashNoEraseDemo();
  DisplayCheck(OLED_CHK_IMU, imu_ok, "");

  int bmp_ok = BmpInit() == 0;
  if (bmp_ok)
  {
    /* Average 10 samples at power-on as the "ground" reference. */
    double sum = 0.0;
    double t, p;
    for (int i = 0; i < 10; i++)
    {
      HAL_Delay(100);
      BmpReadData(&t, &p);
      sum += p;
    }
    ground_pa = sum / 10.0;
    printf("Ground reference: ");
    PrintFixed2(ground_pa);
    printf(" Pa, ~");
    PrintFixed(IsaAltitude(ground_pa), 0);
    printf(" m above sea level at standard pressure (GPS refines it)\r\n");
  }
  FlightResume(bmp_ok);
  snprintf(note, sizeof(note), "%lu hPa", (unsigned long)(ground_pa / 100.0 + 0.5));
  DisplayCheck(OLED_CHK_BARO, bmp_ok, bmp_ok ? note : "");

  int ds_ok = Ds18b20Init() == 0;
  if (ds_ok)
  {
    Ds18b20StartConversion();
  }
  DisplayCheck(OLED_CHK_TEMP, ds_ok, "");

  GpsInit();
  DisplayCheck(OLED_CHK_GPS, boot_gps_talks && boot_gps_airborne,
               !boot_gps_talks ? "NO DATA" : (boot_gps_airborne ? "AIRBORNE" : "NO AIRBORNE"));
  if (oled_ok)
  {
    /* the radio is asked only for the screen's list: it answers on its wires, nothing is sent */
    int lora_ok = LoraCheck();
    snprintf(note, sizeof(note), "%lu.%lu MHz", (unsigned long)(LORA_FREQ_HZ / 1000000UL),
             (unsigned long)(LORA_FREQ_HZ / 100000UL % 10UL));
    DisplayCheck(OLED_CHK_RADIO, lora_ok, lora_ok ? note : "NO ANSWER");
  }

  /* Scheduler state. Each deadline is the previous deadline + period, so small
     delays do not add up over time. Timing is measured with the cycle counter. */
  const uint32_t cycles_per_us = SystemCoreClock / 1000000U;
  TelemetryFrame frame;
  memset(&frame, 0, sizeof(frame));
  uint32_t next_ms = HAL_GetTick() + FRAME_PERIOD_MS;
  uint32_t prev_start_cyc = DWT->CYCCNT;
  uint32_t stat_n = 0, stat_work_sum = 0, stat_work_max = 0, stat_print_max = 0;
  uint32_t stat_jitter_max = 0, overruns = 0;
  printf("LOOP: started, period %lu ms\r\n", (unsigned long)FRAME_PERIOD_MS);
  init_verbose = 0;
  uint16_t prev_valid = 0xFFFFU;
  WatchdogStart();
  printf("WATCHDOG: armed, 2 s\r\n");
  /* USER CODE END 2 */

  /* Initialize USER push-button, will be used to trigger an interrupt each time it's pressed.*/
  BSP_PB_Init(BUTTON_USER, BUTTON_MODE_EXTI);

  /* Infinite loop */
  /* USER CODE BEGIN WHILE */
  while (1)
  {

    /* USER CODE END WHILE */

    /* USER CODE BEGIN 3 */
    /* Between frames: keep draining GPS bytes and feeding the log to the flash. */
    GpsPoll();
    GpsModelService();
    LogService();
    LedService();
    uint8_t cmd;
    if (HAL_UART_Receive(&hlpuart1, &cmd, 1, 0) == HAL_OK)
    {
      if (cmd == 'D' || cmd == 'd')
      {
        LogDump();
        next_ms = HAL_GetTick() + FRAME_PERIOD_MS;
      }
      else if (cmd == 'E' || cmd == 'e')
      {
        LogErase();
        next_ms = HAL_GetTick() + FRAME_PERIOD_MS;
      }
      else if (cmd == 'S' || cmd == 's')
      {
        if (sim_active)
        {
          sim_active = 0;
          FlightSmInit(&fsm, HAL_GetTick());
          AltFuseInit(&afuse);
          BuzzerSet(0);
          printf("SIM: stopped, back to PRELAUNCH\r\n");
        }
        else if (fsm.state != FS_PRELAUNCH)
        {
          printf("SIM: refused, the real flight is in state %s\r\n", FS_NAME[fsm.state]);
        }
        else
        {
          sim_active = 1;
          sim_start_ms = HAL_GetTick();
          FlightSmInit(&fsm, sim_start_ms);
          AltFuseInit(&afuse);
          printf("SIM: fake flight x40 - burst at 30 km after ~2.7 min, landing after ~4 min,"
                 " LANDED 1 min later. Press S again to stop.\r\n");
        }
      }
      else if (cmd == 'T' || cmd == 't')
      {
        if (test_mode)
        {
          test_mode = 0;
          FlightSmInit(&fsm, HAL_GetTick());
          BuzzerSet(0);
          printf("TEST: lift mode off, back to PRELAUNCH\r\n");
        }
        else if (fsm.state != FS_PRELAUNCH || sim_active)
        {
          printf("TEST: refused, only in PRELAUNCH without S\r\n");
        }
        else
        {
          double t, p;
          if (bmp_ok && BmpReadData(&t, &p) == 0)
          {
            ground_pa = p;  /* this floor is the "ground" of the lift flight */
          }
          test_mode = 1;
          FlightSmInit(&fsm, HAL_GetTick());
          fsm.scale = TEST_SCALE;
          fsm.landed_max = TEST_LANDED_MAX;
          printf("TEST: lift mode ON - launch above 15 m, descent 25 m below the top, landed only"
                 " within 10 m of this floor (ground re-zeroed here)\r\n");
        }
        next_ms = HAL_GetTick() + FRAME_PERIOD_MS;
      }
      else if (cmd == 'Q' || cmd == 'q')
      {
        uint8_t d[4];
        WatchdogFeed();
        int hpa = -1;
        if (HAL_UART_Receive(&hlpuart1, d, 4, 1500) == HAL_OK)
        {
          hpa = 0;
          for (int i = 0; i < 4; i++)
          {
            hpa = (d[i] >= '0' && d[i] <= '9' && hpa >= 0) ? hpa * 10 + (d[i] - '0') : -1;
          }
        }
        if (hpa >= 870 && hpa <= 1085)
        {
          asl_offset = -IsaAltitude(hpa * 100.0);
          asl_src = ASL_QNH;
          printf("ALT: sea-level pressure set to %d hPa (GPS overrides it before launch)\r\n", hpa);
        }
        else
        {
          printf("ALT: send Q and 4 digits of sea-level pressure in hPa, e.g. Q1009\r\n");
        }
        next_ms = HAL_GetTick() + FRAME_PERIOD_MS;
      }
      else if (cmd == 'L' || cmd == 'l')
      {
        WatchdogFeed();
        if (LoraCheck())
        {
          /* also set the radio up for our link: starts its clock (TCXO) and calibrates it,
             still without transmitting anything */
          uint16_t err = LoraRadioSetup(LORA_TX_DBM_BENCH);
          printf("LORA: radio setup %lu.%03lu MHz SF%u - chip errors 0x%04X: %s\r\n",
                 (unsigned long)(LORA_FREQ_HZ / 1000000UL), (unsigned long)((LORA_FREQ_HZ / 1000UL) % 1000UL),
                 (unsigned)LORA_SF, err,
                 err == 0 ? "none, the clock runs and the calibration passed"
                 : (err & 0x20) ? "the 32 MHz clock (TCXO on DIO3) did not start" : "calibration failed");
        }
        next_ms = HAL_GetTick() + FRAME_PERIOD_MS;
      }
      else if (cmd == 'P' || cmd == 'p')
      {
        /* Send ONE telemetry packet at the lowest power. Asks first: transmitting without an
           antenna damages the module. */
        uint8_t yes = 0;
        printf("LORA: transmit one packet? antenna must be on. send Y within 5 s\r\n");
        for (int i = 0; i < 5 && yes == 0; i++)
        {
          WatchdogFeed();
          HAL_UART_Receive(&hlpuart1, &yes, 1, 1000);
        }
        if (yes == 'Y' || yes == 'y')
        {
          uint8_t pkt[TP_SIZE];
          uint16_t this_seq = radio_seq;
          RadioPacket(&frame, pkt);
          radio_busy = 0;
          WatchdogFeed();
          uint16_t err = LoraRadioSetup(LORA_TX_DBM_BENCH);
          WatchdogFeed();
          int sent = err == 0 && LoraSend(pkt, TP_SIZE);
          WatchdogFeed();
          printf("LORA: packet seq=%u %s (chip errors 0x%04X)\r\n", (unsigned)this_seq,
                 sent ? "SENT, the radio reported TxDone" : "NOT sent", err);
          printf("LORA: tx detail: status after SetTx 0x%02X, waited %lu ms, irq 0x%04X, errors after 0x%04X\r\n",
                 lora_tx_status, (unsigned long)lora_tx_ms, lora_tx_irq, lora_tx_err);
        }
        else
        {
          printf("LORA: transmit cancelled\r\n");
        }
        next_ms = HAL_GetTick() + FRAME_PERIOD_MS;
      }
      else if (cmd == 'R' || cmd == 'r')
      {
        /* Listen for 10 s and print every HAB-1 packet that arrives */
        WatchdogFeed();
        uint16_t err = LoraRadioSetup(LORA_TX_DBM_BENCH);
        int got = 0;
        printf("LORA: listening for 10 s (chip errors 0x%04X)\r\n", err);
        for (int i = 0; i < 10 && err == 0; i++)
        {
          uint8_t pkt[64];
          int rssi = 0, snr = 0;
          Telemetry tm;
          WatchdogFeed();
          int n = LoraListen(pkt, sizeof(pkt), 1000, &rssi, &snr);
          if (n == 0)
          {
            continue;
          }
          got++;
          int rc = n < 0 ? -9 : TelemetryDecode(pkt, (uint32_t)n, &tm);
          if (rc == 0)
          {
            printf("LORA: RX id=%u seq=%u up=%lus st=%s sats=%u lat=%ld lon=%ld h=%d m vz=%d cm/s"
                   " out=%d C  rssi=%d dBm snr=%d dB\r\n", tm.payload_id, tm.seq,
                   (unsigned long)tm.uptime_s, FS_NAME[tm.state > 5 ? 0 : tm.state], tm.gps_sats,
                   (long)tm.lat_e7, (long)tm.lon_e7, (int)tm.alt_m, (int)(tm.vz_mps * 100.0f),
                   (int)tm.out_temp_c, rssi, snr);
          }
          else
          {
            printf("LORA: RX %d bytes, not a good HAB-1 packet (code %d), rssi=%d dBm\r\n", n, rc, rssi);
          }
        }
        printf("LORA: listening done, %d packet(s)\r\n", got);
        next_ms = HAL_GetTick() + FRAME_PERIOD_MS;
      }
      else if (cmd == 'I' || cmd == 'i')
      {
        /* I2C line check: with the internal pull-down and then pull-up, does the line follow
           the MCU (nothing connected), stay high (module pull-up present) or stay low (shorted)? */
        GPIO_InitTypeDef g = {0};
        GPIO_TypeDef *const ports[2] = {I2C_SCL_PORT, GPIOB};
        const uint16_t pins[2] = {I2C_SCL_PIN, GPIO_PIN_9};
        const char *names[2] = {I2C_SCL_NAME, "SDA (PB9, D14)"};
        WatchdogFeed();
        HAL_I2C_DeInit(&hi2c1);
        for (int i = 0; i < 2; i++)
        {
          g.Pin = pins[i];
          g.Mode = GPIO_MODE_INPUT;
          g.Pull = GPIO_PULLDOWN;
          HAL_GPIO_Init(ports[i], &g);
          HAL_Delay(5);
          int low = HAL_GPIO_ReadPin(ports[i], pins[i]) == GPIO_PIN_SET;
          g.Pull = GPIO_PULLUP;
          HAL_GPIO_Init(ports[i], &g);
          HAL_Delay(5);
          int high = HAL_GPIO_ReadPin(ports[i], pins[i]) == GPIO_PIN_SET;
          printf("I2C: %s reads %d with pull-down, %d with pull-up - %s\r\n", names[i], low, high,
                 (low && high) ? "held high: a module with pull-ups is connected"
                 : (!low && !high) ? "STUCK LOW: shorted to GND or another wire sits on this line"
                 : "FLOATING: nothing is connected to this pin");
        }
        HAL_I2C_Init(&hi2c1);
        int found = 0;
        for (uint16_t a = 0x08; a < 0x78; a++)
        {
          if (HAL_I2C_IsDeviceReady(&hi2c1, (uint16_t)(a << 1), 1, 5) == HAL_OK)
          {
            printf("I2C: device answers at 0x%02X\r\n", a);
            found++;
          }
          WatchdogFeed();
        }
        printf("I2C: scan done, %d device(s). BMP390 is expected at 0x77 (or 0x76)\r\n", found);
        if (found == 0)
        {
          /* Second try with the MCU's own weak pull-ups: an answer now means the wires are
             fine and only the external pull-up resistor is missing. */
          g.Mode = GPIO_MODE_AF_OD;
          g.Pull = GPIO_PULLUP;
          g.Speed = GPIO_SPEED_FREQ_LOW;
          g.Alternate = GPIO_AF4_I2C1;
          g.Pin = GPIO_PIN_9;
          HAL_GPIO_Init(GPIOB, &g);
          g.Pin = I2C_SCL_PIN;
          HAL_GPIO_Init(I2C_SCL_PORT, &g);
          HAL_Delay(5);
          int with_pull = HAL_I2C_IsDeviceReady(&hi2c1, BMP390_ADDR, 3, 20) == HAL_OK;
          printf("I2C: with internal pull-ups the BMP390 %s\r\n",
                 with_pull ? "ANSWERS - wires are fine, the pull-up resistor on SCL is missing"
                           : "still does not answer - the SCL wire itself does not reach the module");
          HAL_I2C_DeInit(&hi2c1);
          HAL_I2C_Init(&hi2c1);
        }
        next_ms = HAL_GetTick() + FRAME_PERIOD_MS;
      }
      else if (cmd == 'A' || cmd == 'a')
      {
        /* Periodic telemetry on / off */
        if (radio_auto)
        {
          radio_auto = 0;
          printf("LORA: auto transmit OFF (%lu sent, %lu failed)\r\n", (unsigned long)radio_sent,
                 (unsigned long)radio_failed);
        }
        else
        {
          uint8_t yes = 0;
          printf("LORA: transmit a packet every %lu s? antenna must be on. send Y within 5 s\r\n",
                 (unsigned long)(RADIO_EVERY_N * FRAME_PERIOD_MS / 1000U));
          for (int i = 0; i < 5 && yes == 0; i++)
          {
            WatchdogFeed();
            HAL_UART_Receive(&hlpuart1, &yes, 1, 1000);
          }
          radio_auto = yes == 'Y' || yes == 'y';
          radio_ready = 0;
          printf("LORA: auto transmit %s\r\n", radio_auto ? "ON" : "stays off");
        }
        next_ms = HAL_GetTick() + FRAME_PERIOD_MS;
      }
      else if (cmd == 'H' || cmd == 'h')
      {
        printf("TEST: hanging the loop on purpose, the watchdog should reset the board in ~2 s\r\n");
        while (1)
        {
        }
      }
    }
    if ((int32_t)(HAL_GetTick() - next_ms) < 0)
    {
      continue;
    }

    /* ---- a new frame is due ---- */
    WatchdogFeed();  /* the loop is alive: tell the watchdog */
    uint32_t start_cyc = DWT->CYCCNT;
    uint32_t period_us = (start_cyc - prev_start_cyc) / cycles_per_us;
    prev_start_cyc = start_cyc;
    uint32_t jitter_us = period_us > FRAME_PERIOD_MS * 1000U ? period_us - FRAME_PERIOD_MS * 1000U
                                                             : FRAME_PERIOD_MS * 1000U - period_us;
    next_ms += FRAME_PERIOD_MS;
    if ((int32_t)(HAL_GetTick() - next_ms) >= 0)
    {
      overruns++;  /* we are already late for the next frame: skip ahead, do not pile up */
      next_ms = HAL_GetTick() + FRAME_PERIOD_MS;
    }

    frame.seq++;
    frame.t_ms = HAL_GetTick();
    frame.valid &= FRAME_OK_OUT;  /* keep the last DS18B20 value between its 1 s reads */

    double temp_c = 0.0, press_pa = 0.0;
    if (bmp_ok && BmpReadData(&temp_c, &press_pa) == 0)
    {
      frame.valid |= FRAME_OK_BARO;
      frame.baro_pa = (float)press_pa;
      frame.baro_temp_c = (float)temp_c;
      frame.baro_rel_m = (float)PressureToAltitude(press_pa, ground_pa);
    }
    if (imu_ok && ImuReadReg(IMU_REG_WHO_AM_I) == IMU_WHO_AM_I_VAL)
    {
      /* SPI never "fails" on its own, so check the IMU still answers before trusting data. */
      ImuRead(frame.acc_g, frame.gyro_dps);
      frame.valid |= FRAME_OK_IMU;
    }
    else
    {
      imu_ok = 0;
    }
    if (!ds_ok)
    {
      frame.valid &= (uint16_t)~FRAME_OK_OUT;
    }
    if (ds_ok && frame.seq % DS18B20_EVERY_N == 0U)
    {
      /* Conversion started one second ago is ready: read it, then start the next one. */
      double out_c;
      if (Ds18b20ReadTemp(&out_c) == 0)
      {
        frame.out_temp_c = (float)out_c;
        frame.valid |= FRAME_OK_OUT;
      }
      else
      {
        frame.valid &= (uint16_t)~FRAME_OK_OUT;
      }
      Ds18b20StartConversion();
    }
    GpsFillFrame(&frame);
    FlightUpdate(&frame, press_pa, (frame.valid & FRAME_OK_BARO) != 0);
    BuzzerSet(fsm.state == FS_LANDED && frame.seq % BUZZER_EVERY_N == 0U);
    RadioTick(&frame);

    /* A lost sensor is re-tried every 5 s; the rest of the system keeps flying meanwhile. */
    if (frame.seq % RETRY_EVERY_N == 0U)
    {
      if (!(frame.valid & FRAME_OK_BARO))
      {
        HAL_I2C_DeInit(&hi2c1);  /* a stuck I2C bus is freed by re-initialising it */
        MX_I2C1_Init();
        bmp_ok = BmpInit() == 0;
        if (bmp_ok && ground_pa == 0.0)
        {
          double t, p;
          if (BmpReadData(&t, &p) == 0)
          {
            ground_pa = p;
          }
        }
      }
      if (!imu_ok)
      {
        imu_ok = ImuInit() == 0;
      }
      if (!ds_ok)
      {
        ds_ok = Ds18b20Init() == 0;
        if (ds_ok)
        {
          Ds18b20StartConversion();
        }
      }
    }
    frame.work_us = (DWT->CYCCNT - start_cyc) / cycles_per_us;

    /* Report every change of sensor health once. */
    if (frame.valid != prev_valid)
    {
      static const struct { uint16_t bit; const char *name; } sensors[] = {
        {FRAME_OK_BARO, "BARO"}, {FRAME_OK_IMU, "IMU"}, {FRAME_OK_OUT, "OUT-TEMP"},
        {FRAME_OK_GPSLINK, "GPS-LINK"}, {FRAME_OK_GPSFIX, "GPS-FIX"}};
      for (unsigned i = 0; i < sizeof(sensors) / sizeof(sensors[0]); i++)
      {
        uint16_t now = frame.valid & sensors[i].bit;
        uint16_t was = prev_valid & sensors[i].bit;
        if (prev_valid != 0xFFFFU && now != was)
        {
          printf("HEALTH: %s %s\r\n", sensors[i].name, now ? "back" : "lost");
        }
      }
      prev_valid = frame.valid;
    }

    uint32_t print_start = DWT->CYCCNT;
    if (fsm.state != FS_LANDED || frame.seq % LANDED_LOG_EVERY == 0U)
    {
      LogPush(&frame);
    }
    FramePrint(&frame);
    uint32_t print_us = (DWT->CYCCNT - print_start) / cycles_per_us;
    DisplayTick(&frame);

    /* ---- loop statistics: is the period stable, how long does a frame take? ---- */
    if (frame.seq > 1U)  /* the first period includes start-up, skip it */
    {
      stat_n++;
      stat_work_sum += frame.work_us;
      stat_work_max = frame.work_us > stat_work_max ? frame.work_us : stat_work_max;
      stat_print_max = print_us > stat_print_max ? print_us : stat_print_max;
      stat_jitter_max = jitter_us > stat_jitter_max ? jitter_us : stat_jitter_max;
    }
    if (stat_n >= LOOP_STATS_EVERY)
    {
      printf("LOOP: period %lu ms  frames %lu  jitter max %lu us  work avg %lu us max %lu us"
             "  print max %lu us  overruns %lu  gps lost %lu  log %lu dropped %lu\r\n",
             (unsigned long)FRAME_PERIOD_MS, (unsigned long)stat_n, (unsigned long)stat_jitter_max,
             (unsigned long)(stat_work_sum / stat_n), (unsigned long)stat_work_max,
             (unsigned long)stat_print_max, (unsigned long)overruns, (unsigned long)gps_rx_overflow,
             (unsigned long)log_next, (unsigned long)log_dropped);
      stat_n = stat_work_sum = stat_work_max = stat_print_max = stat_jitter_max = 0;
    }
  }

  /* USER CODE END 3 */
}

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
/* USER CODE BEGIN 4 */
/* Retarget printf (syscalls.c _write -> __io_putchar) to LPUART1 / ST-LINK VCP */
int __io_putchar(int ch)
{
  uint8_t c = (uint8_t)ch;
  HAL_UART_Transmit(&hlpuart1, &c, 1, HAL_MAX_DELAY);
  return ch;
}

/* USER CODE END 4 */
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
