barcklay/Cube_SAT/(commit log)

2026-09-24 hab_bringup: I2C1 + SPI1 bring-up, read BMP390 and flash IDs
    Enable I2C1 (PB8/PB9) and SPI1 (PA5/PA6/PA7, CS on PB6) in CubeMX and
    print the BMP390 chip ID (0x77, reg 0x00 -> 0x60) and the SPI flash
    JEDEC ID (0x9F -> C8 40 18, GigaDevice GD25Q128) every 2 s.
    FLASH_CS_Pin/Port are defined in USER CODE PD because PB6 has no
    CubeMX label yet.
    The BMP390 module has no pull-up on SCK: an external 4.7k SCL pull-up
    to 3V3 is required on the bench.
2026-09-24 hab_bringup: BMP390 pressure/altitude + SPI flash erase/write/read
    BMP390 (HW-8): read NVM calibration, configure OSR x8/x1, 12.5 Hz,
    IIR 3, normal mode; compensate temperature and pressure per datasheet
    8.4-8.6 and convert to altitude (standard atmosphere and relative to
    the pressure averaged at power-on). Printed every 500 ms as fixed-point
    because newlib-nano printf has no %f.
    SPI flash (HW-5): JEDEC ID, 4 KB sector erase, 256 B page program,
    read. A boot record in sector 0 counts boots and carries a check
    pattern to prove data survives reset and power-off. Sector 1 shows why
    erase is required: programming F0 then 0F without erase reads 00.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
    [main.c]
2026-09-25 hab_bringup: GPS MAX-M10S on USART1, NMEA fix + Airborne <4g
    USART1 on PC4/PC5 (D1/D0) with RX interrupt into a ring buffer. The
    module was pre-set to 38400 baud, so the firmware tries common baud
    rates and keeps the first where NMEA checksums pass.
    NMEA: checksum-verified GGA (UTC, fix, satellites used, lat/lon,
    altitude) and GSV (satellites in view per constellation).
    UBX: read CFG-NAVSPG-DYNMODEL from RAM and BBR with CFG-VALGET, set it
    to 8 (airborne <4g) in RAM+BBR with CFG-VALSET and check the ACK, then
    read back. Without it the receiver drops the fix above 18 km.
    Main loop now polls the GPS continuously and prints GPS + BMP390 once
    per second.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
    [hab_bringup.ioc, main.c]
2026-09-25 hab_bringup: print GPS dynamic model seen at power-up in every status line
    Keeps the power-cycle check visible even when the serial port misses the
    first seconds after boot: model@boot=8 means the receiver restored
    Airborne <4g from battery-backed RAM on its own.
    Claude-Session: https://claude.ai/code/session_01Y9WTd2yaDzj6r4py6E8uJo
2026-09-25 hab_bringup: optional raw NMEA echo (GPS_ECHO_NMEA, off by default)
    Set GPS_ECHO_NMEA to 1 to print every checksum-valid NMEA sentence to
    the console, e.g. to log GSV data for a sky-plot visualisation.
    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
2026-09-25 hab_bringup: ICM-42688-P IMU on its own SPI3 + flash wiring check
    The IMU module (GY-601N1) has I2C pull-ups/level shifters on its
    SCL/SDA/SA0 pins, which corrupted the flash on the shared SPI1 lines
    (JEDEC read as C0 00 44 instead of C8 40 18). The IMU now sits on SPI3
    (PC10 SCK, PC11 MISO, PC12 MOSI) with CS on PC7 (D9); the flash keeps
    SPI1 alone and reads C8 40 18 again.
    IMU: WHO_AM_I 0x47, I2C interface off, accel + gyro in low-noise mode,
    burst read of temperature/accel/gyro printed once per second in g
    (+-16 g, 2048 LSB/g), deg/s (+-2000 dps, 16.4 LSB/dps) and deg C.
    Flash wiring check (WIRING_DIAG): bit-bangs JEDEC reads with CS on
    D10/D9 and DI/DO normal/swapped, compares each ans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
    [hab_bringup.ioc, main.c]
2026-09-25 tools: live mission-control style telemetry view for hab_bringup
    Reads the board's ST-LINK console and prints one colour block per
    second: GPS fix and altitude, barometer pressure and relative altitude,
    temperature, IMU acceleration and rotation, Airborne <4g status. Shows
    boot checks (flash, IMU, baro, GPS) when the board restarts and
    reconnects by itself if the USB link drops. Exact coordinates are never
    printed, so the output is safe for public videos.
    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
    [telemetry.py]
2026-09-26 hab_bringup: DS18B20 outside thermometer on 1-Wire (PA10 / D2)
    PA10 is an open-drain output labelled DS18B20 in CubeMX, with an
    external 4.7k pull-up to 3V3. 1-Wire is bit-banged with microsecond
    delays from the DWT cycle counter; interrupts are off only inside each
    timed bit so GPS UART reception is not disturbed.
    At boot: reset/presence and READ ROM (family 0x28 + CRC-8 check). In the
    loop: read the scratchpad of the conversion started one second earlier
    (CRC-checked, 1/16 degC steps), print it, start the next conversion, so
    the 750 ms conversion never blocks the main loop.
    Checked on the bench: hand +7 degC in a minute, ice water down to +2 degC.
    tools/telemetry.py: shows inside (BMP39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
    [hab_bringup.ioc, main.c, main.h, telemetry.py]
2026-09-27 hab_bringup: fixed-rate telemetry frame loop (HW-12, not yet run on the board)
    All sensors now feed one TelemetryFrame (seq, time since boot, validity
    bits, baro pressure/temperature/relative altitude, IMU acceleration and
    rotation, DS18B20 outside temperature, GPS fix/satellites/lat-lon e7/
    altitude, sensor read time). Frames are taken every 200 ms on a
    drift-free schedule (next deadline = previous deadline + period); an
    overrun skips ahead instead of piling up. DS18B20 is read once per
    second (every 5th frame) because a conversion takes 750 ms.
    Each frame prints one "FRM ..." line; every 25 frames a "LOOP ..." line
    reports period jitter, sensor read time (avg/max), print time,
    overruns an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
    [main.c]
2026-09-27 tools: chunked flashing script + telemetry view for the frame loop
    flash.py: long continuous st-flash writes to the bench board fail with
    LIBUSB_ERROR_TIMEOUT halfway while reads and short writes work, so the
    image is written in 4 KB pieces (2 flash pages each) with up to 3 tries
    per piece, then read back and compared byte for byte, then the board is
    reset.
    telemetry.py: parses the new "FRM" frame lines (5 per second, shown once
    per second) and the "LOOP" statistics line (period, jitter, sensor and
    print time, overruns). HW-12 loop verified on the board with it:
    200 ms period, jitter <= 1 us, 0 overruns, no lost GPS bytes.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
    [flash.py, telemetry.py]
2026-09-27 hab_bringup: flight log in SPI flash that survives power cuts (HW-16)
    Every telemetry frame (5 per second) is appended to the SPI flash as a
    128-byte LogRecord: magic "LG", boot number, record index, the frame and
    a CRC-16/CCITT. Records are half a page, so they never cross a page.
    16 MB minus 8 KB holds 131008 records, about 7 h at 5 Hz.
    Writing never blocks the frame loop: LogService() issues at most one
    flash operation per call and returns without waiting (page program or
    sector erase); the next sectors are erased ahead of time, and a 16-frame
    RAM queue covers the up to ~0.4 s sector erase.
    At boot LogInit() finds where the log ended (first slot of each sector,
    then inside the last used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
    [logdump.py, main.c, telemetry.py]
2026-09-27 hab_bringup: independent watchdog, reset cause, sensor health and recovery (HW-17)
    IWDG set up by registers (LSI /64, reload 999 = 2 s), armed right before
    the frame loop and fed once per frame; the long ground-only operations
    (log dump, chip erase) feed it too and have bounded waits.
    Reset cause is read from RCC->CSR at boot (power-on, reset pin /
    programmer, software, WATCHDOG), printed and stored in every log record
    (new reset_cause byte in LogRecord, size still 128; CSV column added).
    st-flash leaves VC_CORERESET set in DEMCR, which survives any reset but
    power-off, so a watchdog reset halted the core instead of restarting it.
    The firmware now clears it at start. Verified: console comm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
    [main.c]
2026-09-27 hardware: flight board spec draft (STM32G474RET6 + modules on headers)
    Rev A plan for the HAB-1 flight PCB: the same STM32G474RET6 (LQFP64)
    as the Nucleo, placed by JLCPCB, so the tested bench pinout and firmware
    carry over; sensor breakouts on female headers; CubeSat 1U outline;
    STDC14 connector for SWD + virtual COM port via the Nucleo's ST-LINK.
    Includes the pin map taken from hab_bringup.ioc, new pins for LoRa on
    its own SPI2 (checked against the CubeMX pin database), battery ADC and
    LEDs, the pull-ups learned on the bench (4.7k on SCL/SDA and the
    DS18B20 line, 10k on chip selects), MCU support circuit, power estimate,
    layout rules and the open questions to settle before ordering.
    Co-A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
2026-09-27 hardware: generated rev A schematic of the flight board (ERC clean)
    gen_schematic.py builds hab1_flight.kicad_sch from the SPEC.md tables:
    symbols are copied from the KiCad standard library, every pin gets a net
    label or power symbol right on its end (no wires), footprints are
    assigned for the PCB. A self-check aborts if two different nets would
    meet at one point (that happened with overlapping blocks in the first
    try and merged VBAT_SENSE into +3V3).
    Contents: STM32G474RET6 (LQFP64) with decoupling, ferrite-filtered
    VDDA/VREF+, reset button and STDC14 SWD+VCP connector; battery ->
    external switch -> AO3401A reverse-polarity FET -> MIC5219-3.3
    (provisional until HW-21) with battery sense di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
    [hab1_flight.kicad_sch]
2026-09-27 hardware: tidier schematic and stable UUIDs for the PCB link
    MCU power pins now go through short stubs to one bus wire with a single
    +3V3 / GND symbol per side instead of overlapping symbols. The MCU name
    sits under the body; resistors, capacitors and LEDs show their value on
    the left so it does not collide with power symbols.
    UUIDs are derived from the reference (uuid5) instead of random, so
    regenerating the schematic keeps the symbol <-> footprint links of the
    PCB. ERC still 0 violations, netlist check 0 mismatches.
    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
    [hab1_flight.kicad_sch]
2026-09-27 hardware: generated starting PCB for the flight board (placed, not routed)
    gen_pcb.py (run with KiCad's Python) builds hab1_flight.kicad_pcb from
    the schematic netlist: CubeSat 1U outline 95.89 x 90.17 mm, 4 copper
    layers, JLCPCB-friendly minimum rules, all 56 footprints from the KiCad
    library with their nets and linked to the schematic symbols, placed in
    zones (power top-left, MCU centre with decoupling around it, STDC14 and
    reset at the bottom edge, GPS top edge, LoRa right edge, IMU/barometer/
    flash sockets on the left, DS18B20 connector at the bottom edge, test
    points bottom-right), GND plane on In1 and +3V3 plane on In2, module
    body outlines on User.Drawings. It refuses to overwrite a b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
    [hab1_flight.kicad_pcb, hab1_flight.kicad_sch]
2026-09-28 portfolio: interactive 3D lab page for HAB-1 (HW-145)
    Full-screen Three.js scene: payload in the stratosphere with sky and Earth by
    altitude, balloon, parachute, foam enclosure (HW-34 concept) and the flight PCB
    exported from KiCad inside. Flight model with tropical/ISA atmosphere, sensor
    limits and the firmware barometric formula. build_board.sh regenerates board.js.
    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
2026-09-28 portfolio: lab page over the real launch site; launch site study (HW-145)
    Launch site chosen on a 0.1 deg grid over Thailand: far from airports, OSM
    military sites, borders and the sea, flat by SRTM; landing checked with
    SondeHub/Tawhiri forecasts. The page now shows NASA Blue Marble imagery around
    15.8 N 102.5 E with an example predicted track, and a top-down view.
    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
2026-09-28 tools: board_watch.command, double-click monitor of the board USB link
    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
2026-09-28 hab_bringup: reject all-zero DS18B20 scratchpad; logdump.py fixes (HW-17)
    A pulled probe wire leaves the 1-Wire line floating, which reads as all
    zeros; the CRC of all zeros is 0, so the frame showed a fake 0.0 C instead
    of OUT-TEMP lost. Check the bits the DS18B20 always sets (config register,
    reserved byte 5 = 0xFF).
    logdump.py: tolerate select() waking with nothing to read, and find
    LOGDUMP BEGIN even when it shares a line with a half-printed frame.
    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
    [logdump.py, main.c]
2026-09-28 hardware: barometer and GPS sockets from the real module pinouts (HW-24)
    BMP390 module has 7 pins: INT CS SDO SDI SCK VCC GND (was 6 guessed).
    MAX-M10S module has 5 pins: VCC GND TX RX PPS (was 4); PPS goes to PA8
    (TIM1_CH1) for precise time. ERC 0, netlist check 0 mismatches, PCB
    schematic parity 0; 121 unrouted connections as expected.
    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
    [hab1_flight.kicad_pcb, hab1_flight.kicad_sch]
2026-09-28 hardware: OLED socket order confirmed from the module (HW-24)
    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
    [hab1_flight.kicad_sch]
2026-09-28 hardware: recovery buzzer on PB4 (HW-24)
    Active piezo buzzer on a 2-pin JST cable to the box wall, switched on the
    low side by an AO3400A from the battery rail (loud), 100k gate pull-down so
    it stays silent during boot, 1N4148W in case a magnetic buzzer is used.
    ERC 0, netlist check 0 mismatches, PCB parity 0.
    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
    [hab1_flight.kicad_pcb, hab1_flight.kicad_sch]
2026-09-29 portfolio: lab page says what HAB-1 is and shows where the inside is
    First-visit card (what / why / what is here) with 'look inside' and 'start
    the flight' buttons, a hint bubble that follows the payload box until the
    inside view is opened, an accent 'look inside' button, and the one-line
    pitch on the splash screen (seen in link previews).
    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
2026-09-29 portfolio: 'look inside' is a toggle (same button or Esc goes back)
    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
2026-09-29 portfolio: no atmosphere switch; on phones the sensor panels fold into one button
    Tropical profile only. Timeline marks show ticks without labels on narrow
    screens (labels overlapped), the landing clock is hidden there.
    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
2026-09-29 hab_bringup: flight state machine and real altitude above sea level (HW-18)
    - flight_sm.h (pure C, shared with a host test): PRELAUNCH -> ASCENT ->
    FLOAT -> BURST -> DESCENT -> LANDED from altitude above launch and the
    5 s least-squares vertical speed; conditions must hold for seconds; a
    lift to the 21st floor or a floating balloon never looks like a launch
    or a landing.
    - Layered ISA altitude (0-47 km) replaces the 44330 formula, which was
    ~4.7 km low at 30 km.
    - Altitude above sea level: standard pressure, GPS calibration before
    launch (6+ satellites), or 'Q' + 4 digits of sea-level pressure (hPa).
    - A watchdog/brown-out reset in flight resumes the state, launch pressure
    and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
    [flight_sm.h, main.c, telemetry.py, test_flight_sm.c]
2026-09-29 hab_bringup: lift test mode 'T'; programmer reset never resumes a flight (HW-18)
    - 'T' (only in PRELAUNCH): a lift ride becomes a small flight - thresholds
    x0.05, ground re-zeroed on this floor, landing only within 10 m of it so
    a lift stopping on the way is not a landing. Survives a resume.
    - Checked in a lift: launch detected at 38 m (2.3 m/s); 'H' hang -> watchdog
    reset -> 'FLIGHT: resumed ASCENT' with the launch pressure and max altitude
    restored, altitude continued 38 -> 43 m.
    - st-flash resets look like a software reset: the VC_CORERESET bit it leaves
    now marks the boot as 'programmer', which starts a new flight instead of
    resuming the last one.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
    [flight_sm.h, main.c, telemetry.py]
2026-09-29 hardware: flight board routed with Freerouting (HW-24)
    route_pcb.py: In1/In2 as GND/+3V3 planes, 0.5 mm tracks for the battery
    and buzzer nets, a fan-out via from every SMD GND/3V3 pad to its plane
    (straight out along QFP pins, a tie to a same-net pad where there is no
    room), plane clearance 0.2 mm, then Freerouting (100 passes) and SES import.
    gen_pcb.py: VDDA filter (FB1, C11, C12) moved under the VDDA pins, hole
    labels hidden, title moved off J11; --force to re-place a routed board.
    Result: 486 track segments (2.3 m), 108 vias; DRC 0 unconnected, 0
    clearance errors, 0 schematic parity issues; 13 silkscreen warnings
    (text over pads / neighbouring labels), cosmetic.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
    [hab1_flight.kicad_pcb]
2026-09-29 portfolio: drop the GPS mode switch, keep the Airborne story in 'about'
    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
2026-09-29 portfolio: flight board shown with the red solder mask it will be ordered with
    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
2026-09-29 portfolio/sky: each satellite modelled after its real type, with a spec card (HW-141)
    GPS IIR/IIR-M/IIF with the helix antenna ring, Galileo FOC with its flat
    antenna, BeiDou-2 IGSO (DFH-3), GAGAN on GSAT-8/10 with dish reflectors;
    proportions and panel counts from published specs and photos. Card: vehicle,
    launch date, maker, mass, array span, signals, clock; plain-language section
    on what navigation satellites do; sources listed.
    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
2026-09-29 portfolio/sky: plain-language satellite card and a close-up viewer with named parts (HW-141)
    Card: what it transmits, its clock (rubidium / hydrogen maser explained),
    what else is on board (search-and-rescue repeater, laser retroreflector),
    link to photos. 'Look at the satellite' opens the model alone, turning,
    with labels on the solar arrays, antennas, radiators and reflectors.
    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
2026-09-30 portfolio/lab: dawn over a night Earth - city lights, sunrise at the horizon
    The Sun 3° below the flat horizon: from 30 km the horizon dips 5.6°, so the
    probe sees the sunrise while the ground is still at night. City lights of
    Bangkok and Isan from NASA Black Marble (broken into sparkles up close),
    warm band towards the Sun, cool haze over the ground, low warm sunlight on
    the payload; the default view faces the sunrise.
    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
2026-09-30 portfolio/sky: satellite models closer to the real ones - crinkled foil, solar cell grid, helix antennas, reflections (HW-141)
    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
2026-09-30 portfolio/sky: satellite models redrawn from real photos - IIR lattice antennas and striped helices, Galileo dark body with orange honeycomb antenna, GSAT mirrors and dishes (HW-141)
    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
2026-09-30 firmware: L command - bring-up check of the E22 LoRa module on SPI2, no transmitting (HW-160)
    Resets the module, reads its status and the LoRa sync word register, writes and
    reads back a test value; each failure names the wire to check.
    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
    [lora_e22.h, main.c, telemetry.py]
2026-10-06 firmware: I command - I2C line check (floating / stuck low / pulled up) and bus scan
    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
    [main.c, telemetry.py]
2026-10-06 firmware: I command also retries with internal pull-ups to tell a missing pull-up resistor from a loose wire; ignore local data/
    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
    [main.c]
2026-10-06 flight PCB: expansion header J12 (3V3, battery rail, 4 analog pins, 2 PWM pins), rerouted
    ERC 0/0, netlist check 0 mismatches, DRC 0 unconnected, 0 parity issues.
    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
    [hab1_flight.kicad_pcb, hab1_flight.kicad_sch]
2026-10-06 flight PCB: fix swapped console TX/RX on the STDC14 connector, buzzer gate pull-down 4.7k; add the independent review report (HW-153)
    Review finding B1: STDC14 pin 13 is the target RX (PA3), pin 14 the target TX (PA2).
    ERC 0/0, netlist 0 mismatches, DRC 0 unconnected, 0 parity issues.
    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
    [hab1_flight.kicad_pcb, hab1_flight.kicad_sch]
2026-10-06 flight PCB: review fixes - fuses, cable protection, SCL off the BOOT0 pin, decoupling at the pins, silkscreen pin names (HW-153)
    F1/F2 resettable fuses, series resistors on the DS18B20 cable and the expansion
    header, I2C SCL moved PB8 -> PA15 with PB8 pulled down, 100 nF 2 mm from each VDD
    pin and at NRST / VDDA, pull-downs on LORA_TXEN/RXEN, module and pin names on silk.
    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
    [hab1_flight.kicad_pcb, hab1_flight.kicad_sch]
2026-10-06 flight PCB: regulator MIC5219 (SOT-23-5) -> LDL1117S33R (SOT-223), enough for LoRa TX current (HW-153)
    Pin order taken as the LD1117 symbol; to be confirmed against the datasheet before ordering.
    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
    [hab1_flight.kicad_pcb, hab1_flight.kicad_sch]
2026-10-06 flight PCB: LDL1117 pinout confirmed from the datasheet; LoRa bulk capacitor 47u -> 4.7u to stay inside its stability chart (HW-153)
    DS12022 rev 7: pins 1 GND, 2 VOUT, 3 VIN, tab VOUT; theta-JA 120 C/W; stability chart up to 22 uF.
    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
    [hab1_flight.kicad_pcb, hab1_flight.kicad_sch]
2026-10-06 flight PCB: sockets placed for the measured module boards, automatic module fit check, 1:1 print for a paper check (HW-153)
    Module sizes measured from photos (pin pitch as the ruler). Flash socket turned so its
    board stays on the PCB, barometer and GPS moved to the top. ERC 0/0, netlist 0
    mismatches, DRC 0 unconnected, 0 parity issues.
    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
    [hab1_flight.kicad_pcb]
2026-10-07 flight PCB: JLCPCB files (gerbers, BOM with LCSC numbers, CPL), parts checked in the JLCPCB catalogue (HW-155)
    LEDs red/yellow instead of green/blue (out of stock and too dim from 3.3 V), battery
    fuse in the 24 V version, keyed programming header, via copper ring 0.15 mm.
    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
    [bom_jlcpcb.csv, hab1_flight.kicad_pcb, hab1_flight.kicad_sch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]
2026-10-07 firmware: 28-byte radio telemetry packet with tests, SX1268 transmit/receive code, flight-board build (HW-13, HW-6)
    telemetry_packet.h: position, altitude, state, temperatures, CRC-16; host test
    tools/test_telemetry_packet.c passes (incl. all single-bit errors detected).
    lora_e22.h: radio setup (TCXO on DIO3, 434.5 MHz SF9), send, listen; commands L
    (setup without transmitting), P (one packet, asks first), R (listen 10 s).
    Compiled, not run on the air: one module on the bench.
    cmake preset Flight: I2C clock on PA15 as on our own PCB.
    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
    [lora_e22.h, main.c, telemetry_packet.h, test_telemetry_packet.c]
2026-10-08 flight PCB: LoRa module E22-400M22S soldered on by JLCPCB instead of an adapter socket (HW-162, HW-155)
    Own footprint from the Ebyte drawing, checked against the labels on the real module;
    no tracks or vias under the module; JLCPCB part C411291 in the BOM.
    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
    [bom_jlcpcb.csv, hab1_flight.kicad_pcb, hab1_flight.kicad_sch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]
2026-10-08 LoRa breakout board: E22-400M22S on two rows of 2.54 mm pins for the bench and the ground station
    31.6 x 25.2 mm, 2 layers, generated and routed by gen_adapter.py, JLCPCB files in fab/.
    DRC: 0 unconnected, no errors.
    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
    [bom_jlcpcb.csv, e22_adapter.kicad_pcb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]
2026-10-09 ground segment: receiver firmware build and ground station program (HW-29, HW-28)
    Receiver: cmake preset Ground builds the same firmware as a listen-only radio
    receiver. It keeps the SX1268 in continuous receive, prints every packet as one
    hex line with RSSI and SNR, and a heartbeat with the noise floor every 5 s.
    It never transmits. Compiled, not yet run on hardware.
    Ground station: tools/ground_station.py reads those lines, checks and decodes the
    28-byte packet, writes a CSV table and a raw log into data/ground/ (ignored: they
    hold coordinates) and serves a local page with the map, altitude and signal level,
    plus distance, bearing and elevation angle to the payload. --demo flies a made-up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
    [ground_station.py, lora_e22.h, main.c, test_ground_station.py]
2026-10-09 ground receiver on Arduino Nano ESP32 (RadioLib), wiring self-check and wire auto-detection (HW-29)
    The second E22-400M22S is wired to a Nano ESP32. The sketch prints packets in the
    same line format as the NUCLEO receiver build, so tools/ground_station.py works
    with either. It uses RadioLib rather than our own SX1268 driver: an independent
    implementation on the other end of the link.
    At power-on it checks every wire with bit-banged SPI; if the module does not
    answer, it finds NSS, MISO, MOSI, SCK and NRST by itself. That is how the swapped
    NSS/NRST wires were found on the bench; the pins are set to match.
    Checked on hardware: the module answers (status 0x2A, sync word 14 24) and the
    receiv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
    [ground_station.py, receiver.cpp]
2026-10-09 firmware: fix stack overflow in LoraCmd that crashed every transmit; first packet over the air (HW-6)
    LoraCmd() received the SPI reply into a 16-byte buffer while WriteBuffer sends
    2 + 28 bytes: the first real transmit overwrote the stack and the board reset by
    watchdog before the transmitter was switched on. The buffer is now as long as the
    longest command. The P command also feeds the watchdog around setup and send and
    prints the chip status, wait time and IRQ word of the transmit.
    Result on the bench: NUCLEO + E22 sends a 28-byte packet at -9 dBm, TxDone after
    232 ms; Nano ESP32 + E22 (RadioLib) half a metre away receives it at -36 dBm,
    SNR 11 dB; the ground station code decodes it with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
    [lora_e22.h, main.c]
2026-10-09 tools: pick the ST-LINK serial port when the Arduino receiver is plugged in too
    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
2026-10-09 firmware: periodic radio telemetry, one packet every 5 s, without stopping the 5 Hz loop
    LoraSendStart() starts a packet and returns; LoraSendPoll() is checked in the
    following frames. RadioTick() runs once per frame: it sets the radio up when
    needed, sends the latest frame every 25th frame and counts sent and failed
    packets. Bench build: off at power-up, console command 'A' turns it on after a
    confirmation (antenna). Flight build: on from power-up. Power is still the bench
    value (-9 dBm).
    On the bench: packets arrive at the Nano ESP32 receiver every 5 s at -36 dBm,
    loop jitter stays at ~20 us, no overruns.
    Claude-Session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
    [lora_e22.h, main.c]
2026-10-10 firmware: flight radio power +8 dBm, the Thai licence-exempt limit of 10 mW e.i.r.p. (HW-166)
    Bench build stays at -9 dBm.
    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
2026-10-13 firmware: bench OLED (SSD1306) - power-on self-check list, live pages, running line (HW-142)
    The screen shares the barometer's I2C wires. Only changed bytes are sent, at most
    400 per frame, so the 5 Hz loop keeps its timing (jitter 21-26 us, 0 overruns with
    the screen on). No screen = no effect; the flight build never looks for one.
    Coordinates are never drawn. Screens are drawn by the same code on the laptop in
    tools/test_oled.c.
    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
2026-10-21 firmware: LED on PB0 blinks fast before launch when the black box has less than 5 h of room
    PB0 is A3 on the Nucleo and LED_ALIVE on the flight board. Normally one short blink a
    second; in PRELAUNCH with less room than a flight needs (about 4 h with the time on the
    pad) it blinks 10 times a second. The boot log prints a warning and the bench OLED
    check list marks MEMORY as failed. Built (Debug, Flight, Ground); not yet run on the
    board.
    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
2026-10-23 firmware: altitude from the barometer and the GPS together, GPS model checked every minute (HW-15)
    The BMP390 is specified down to 300 hPa (~9 km); the balloon goes to 30+ km. New
    Core/Inc/altitude_fuse.h blends the two by the measured pressure: barometer only above
    400 hPa, GPS only below 320 hPa, a linear mix in between. The GPS-minus-barometer
    difference is learned in flight below ~7 km so the mix starts without a jump; the GPS is
    followed by a small tracking filter between its 1 Hz samples; a sample far from where
    the payload can be is ignored; without GPS up high the altitude is carried forward for
    30 s, then reported as unknown so the state machine waits instead of guessing.
    The Airbo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
